Zvonko2203/Map-from-transfer-folder/SanaBike Measuring head/BoM_Messkopf.xlsx

Sheet: 20-30-602_SB3-1_2025_NiBP
20-30-602_SB3-1_2025_NiBP&SPO2 |  |  |  | 206-00-0-110 | Measuring Head with NiBP & SpO2
Qty | Unit | Ergosana article number | Description | New article number | Description
1 | Stück | 27-30-400 | Lagergehäuse für Messkopf - new version for rotation mechanisam | 206-10-5-001 | Bearing Rotation Mechanism
1 | Stück | 27-30-504 | Filterscheibe, Drehzahlanzeige, Meßkopf | 206-10-5-002 | Speed Indicator Housing
2 | Stück | 31-30-001 | Ersatzsteg für Platine ohne BD | 206-10-5-003 | Carrier for Main Unit PCB
1 | Stück | 35-30-001 | Auflageplatte, Display | 206-10-5-004 | Display plate | 206-10-1-001 | Downside Housing for Standard
1 | Stück | 35-30-400 | 35-30-400_ZI04 Unterteil, Gehäuse Messkopf Typ3_Stand2022-06-15 - BD+SpO2 | 206-10-1-002 | Downside Housing for NiBP/SpO2 | 206-10-1-002 | Downside Housing for NiBP/SpO2
1 | Stück | 35-30-401 | 35-30-401_ZI03 Oberteil, Gehäuse Messkopf Typ3-x_Displayausschnitt 2,8Zoll | 206-10-5-005 | Upside Housing | 206-10-1-003 | Downside Housing for NiBP
1 | Stück | 37-30-501 (https://qms.schiller.ch/display/SANABEM/Ergometer+Schematic+Part+List+37-30-501+Platine+Ergometersteuerung) | Platine Ergometersteuerung SB3 3.1 Version 30_04_012 | 206-30-1-100 | Main Unit PCB | 206-10-1-004 | Downside Housing for SpO2
1 | Stück | 37-30-503 (https://qms.schiller.ch/display/SANABEM/Ergometer+Schematic+Part+List+37-30-503+Platine+Drehzahlanzeige) | Platine Drehzahlanzeige kpl. SB3 | 206-30-1-200 | LED Display PCB
1 | Stück | N/A | Kabel SpO2 6 pol - from PAR | 211-40-1-100 | SpO2 cable from PAR
1 | Stück | 39-30-800 | Frontfolie Meßkopf SB3 | 206-10-5-006 | Front foil of head
9 | Stück | 40-08-006 | Linsenschraube, Kreuzschlitz DIN7985 4.8 verz. M3x4 | 210-10-5-101 | Pan Head Screw DIN7985 M3x4
4 | Stück | 40-10-001 | Senkschraube, Kreuzschlitz DIN965 4.8 verz. M4x10 | 210-10-5-102 | Flat Head Screw DIN965 M4x10
2 | Stück | 40-10-002 | Senkschraube, Kreuzschlitz DIN 965 4.8 verz. M3x6 | 210-10-5-103 | Flat Head Screw DIN965 M3x6
4 | Stück | 40-18-015 | Linsen-Blechschraube, Kreuzschlitz C DIN 7981 verz. 3,9x25 | 210-10-5-104 | Tapping screw DIN9781 3,9x25
7 | Stück | 41-01-006 | Mutter, Sechskant DIN934 8 verz. M3 | 210-10-5-201 | Hexagon Nut DIN934 M3
3 | Stück | 41-02-018 | Abstandsbolzen M3x15 (IG/AG) Stahl verz. | 210-10-5-701 | Spacer Bolts M3x15 Female/Male
2 | Stück | 42-01-001 | Scheibe, A DIN125 Stahl 140HV verz. 3,2 (M3) | 210-10-5-301 | Flat Washer DIN125A 140HV M3
1 | Stück | 42-02-001 | Scheibe, Kunststoff, A DIN125 Polyamid 6.6 3,2 (M3) | 210-10-5-302 | Flat Washer DIN125 Polyamide M3 | Ide na kriticno mjesto oko komponenti kod NiBP jedne na steuerplatine
1 | Stück | 59-01-147 | Federndruckstück GN 614.4-5-NI | 210-10-5-501 | Ganter GN 614.4-5-NI
4 | Stück | 59-01-148 | Gewindeeinsatz M3 | 210-10-5-001 | Thread insert brass M3
1 | Stück | 69-01-008 | Jumper (Brücke) 2-Pin 2,54mm SIP-2P | 211-20-5-101 | Jumper 2Pin 2,54mm SIP-2P
1 | Stück | 69-01-103 | Display TFT, Messkopf easy, SB3 | 211-20-5-102 | TFT Display
2 | Stück | N/A | Abstandsbolzen M3x10 (IG/AG) Stahl vern (gbms_3055_33_10) | 210-10-5-702 | Spacer Bolts M3x10 Female/Male
4 | Stück | N/A | Abstandsbolzen M3x30 (IG/AG) Stahl verz. (gbm_3050_30) | 210-10-5-703 | Spacer Bolts M3x30 Female/Male
1 | Stück | N/A | Label Ergosana | 230-10-5-001 | Label Ergosana
1 | Stück | 26-37-501_ZI00 | Anschlußstück Luftdruck, BD-Messung | 210-50-5-001 | Connector for air pressure
1 | Stück | 26-37-502_ZI00 | Mutter M7x0,75, Anschlussstück BD-Messung | 210-10-5-202 | Hexagon Nut M7x0,75 for air pressure connector
1 | Stück | N/A | Steckanschluss, Mikrophon - 4pin | 211-20-5-301 | 4pin Microphone connector 09-9766-30-04
1 | Stück | N/A | NiBP2020B | 211-20-1-100 | NiBP2020B module
1 | Stück | 38-30-320 | Kabel Drehzahlanzeige 6 pol 120 mm | 211-40-1-200 | LED Display Cable 6pin 120mm
1 | Stück | 35-30-xxx | Plain Bearing socket | 210-10-5-601 | Plain Bearing socket
1 | Stück | N/A | QRS cable | 210-10-5-602 | QRS Cable 2pin 220mm
1 | Stück | N/A | Microphone cable | 210-10-5-603 | Microphone Cable 3pin 220mm

Sheet: 20-30-600_SB3-1_2025
20-30-600_SB3-1_2025 |  |  |  | 206-00-0-000 | Measuring Head standard
Qty | Unit | Ergosana article number | Description | New article number | Description
1 | Stück | 27-30-400 | Lager, Gehäuse, Messkopf - new version for rotation mechanisam | 206-10-5-001 | Bearing Rotation Mechanism
1 | Stück | 27-30-504 | Filterscheibe, Drehzahlanzeige, Meßkopf | 206-10-5-002 | Speed Indicator Housing
2 | Stück | 31-30-001 | Ersatzsteg für Platine ohne BD | 206-10-5-003 | Carrier for Main Unit PCB
1 | Stück | 35-30-xxx | Plain Bearing socket | 210-10-5-601 | Plain Bearing socket
1 | Stück | 35-30-001 | Auflageplatte, Display | 206-10-5-004 | Display plate
1 | Stück | 35-30-400 | Gehäuse Messkopf Unterteil SB3 | 206-10-1-001 | Downside Housing for Standard
1 | Stück | 35-30-401 | Gehäuse Messkopf Oberteil SB3 | 206-10-5-005 | Upside Housing
1 | Stück | 37-30-501 (https://qms.schiller.ch/display/SANABEM/Ergometer+Schematic+Part+List+37-30-501+Platine+Ergometersteuerung) | Platine Ergometersteuerung SB3 3.1 Version 30_04_012 | 206-30-1-100 | Main Unit PCB
1 | Stück | 37-30-503 (https://qms.schiller.ch/display/SANABEM/Ergometer+Schematic+Part+List+37-30-503+Platine+Drehzahlanzeige) | Platine Drehzahlanzeige kpl. SB3 | 206-30-1-200 | LED Display PCB
1 | Stück | 38-30-320 | Kabel Drehzahlanzeige 6 pol 120 mm | 211-40-1-200 | LED Display Cable 6pin 120mm
1 | Stück | 39-30-800 | Frontfolie Meßkopf SB3 | 206-10-5-006 | Front foil of head
6 | Stück | 40-08-006 | Linsenschraube, Kreuzschlitz DIN7985 4.8 verz. M3x4 | 210-10-5-101 | Pan Head Screw DIN7985 M3x4
4 | Stück | 40-10-001 | Senkschraube, Kreuzschlitz DIN965 4.8 verz. M4x10 | 210-10-5-102 | Flat Head Screw DIN965 M4x10
2 | Stück | 40-10-002 | Senkschraube, Kreuzschlitz DIN 965 4.8 verz. M3x6 | 210-10-5-103 | Flat Head Screw DIN965 M3x6
4 | Stück | 40-18-015 | Linsen-Blechschraube, Kreuzschlitz C DIN 7981 verz. 3,9x25 | 210-10-5-104 | Tapping screw DIN9781 3,9x25
4 | Stück | 41-01-006 | Mutter, Sechskant DIN934 8 verz. M3 | 210-10-5-201 | Hexagon Nut DIN934 M3
4 | Stück | N/A | Abstandsbolzen M3x10 (IG/AG) Stahl vern (gbms_3055_33_10) | 210-10-5-702 | Spacer Bolts M3x10 Female/Male
2 | Stück | N/A | Abstandsbolzen M3x30 (IG/AG) Stahl verz. (gbm_3050_30) | 210-10-5-703 | Spacer Bolts M3x30 Female/Male
2 | Stück | 42-01-001 | Scheibe, A DIN125 Stahl 140HV verz. 3,2 (M3) | 210-10-5-301 | Flat Washer DIN125A 140HV M3
1 | Stück | 42-02-001 | Scheibe, Kunststoff, A DIN125 Polyamid 6.6 3,2 (M3) | 210-10-5-302 | Flat Washer DIN125 Polyamide M3
1 | Stück | 59-01-147 | Federndruckstück GN 614.4-5-NI | 210-10-5-501 | Ganter GN 614.4-5-NI
4 | Stück | 59-01-148 | Gewindeeinsatz M3 | 210-10-5-001 | Thread insert brass M3
1 | Stück | 69-01-008 | Jumper (Brücke) 2-Pin 2,54mm SIP-2P | 211-20-5-101 | Jumper 2Pin 2,54mm SIP-2P
1 | Stück | 69-01-103 | Display TFT, Messkopf easy, SB3 | 211-20-5-102 | TFT Display
1 | Stück | N/A | Label Ergosana | 230-10-5-001 | Label Ergosana
