Zvonko2203/Map-from-transfer-folder/SanaBike Measuring head/BoM_Messkopf_comparation.xlsx

Sheet: 20-30-602_SB3-1_2025_NiBP
Added parts to BoM
Removed Parts from BoM
Parts matched from BoM QMS
Changed number of parts to BoM
20-30-602_SB3-1_2025_NiBP&SPO2
Qty | Unit | Ergosana article number | Description
1 | Stück | 27-30-400 | Lagergehäuse für Messkopf - for rotation mechanisam
1 | Stück | 27-30-504 | Filterscheibe, Drehzahlanzeige, Meßkopf
2 | Stück | 31-30-001 | Ersatzsteg für Platine ohne BD
1 | Stück | 35-30-001 | Auflageplatte, Display
1 | Stück | 35-30-400 | 35-30-400_ZI04 Unterteil, Gehäuse Messkopf Typ3_Stand2022-06-15 - BD+SpO2
1 | Stück | 35-30-401 | 35-30-401_ZI03 Oberteil, Gehäuse Messkopf Typ3-x_Displayausschnitt 2,8Zoll
1 | Stück | 37-30-501 (https://qms.schiller.ch/display/SANABEM/Ergometer+Schematic+Part+List+37-30-501+Platine+Ergometersteuerung) | Platine Ergometersteuerung SB3 3.1 Version 30_04_012
1 | Stück | 37-30-503 (https://qms.schiller.ch/display/SANABEM/Ergometer+Schematic+Part+List+37-30-503+Platine+Drehzahlanzeige) | Platine Drehzahlanzeige kpl. SB3
1 | Stück | N/A | Kabel Drehzahlanzeige 6 pol - from PAR
1 | Stück | 39-30-800 | Frontfolie Meßkopf SB3
9 (6-old) | Stück | 40-08-006 | Linsenschraube, Kreuzschlitz DIN7985 4.8 verz. M3x4
4 | Stück | 40-10-001 | Senkschraube, Kreuzschlitz DIN965 4.8 verz. M4x10
2 | Stück | 40-10-002 | Senkschraube, Kreuzschlitz DIN 965 4.8 verz. M3x6
4 | Stück | 40-18-015 | Linsen-Blechschraube, Kreuzschlitz C DIN 7981 verz. 3,9x25
7 (6 - old) | Stück | 41-01-006 | Mutter, Sechskant DIN934 8 verz. M3
4 | Stück | 41-02-006 | Abstandsbolzen M3x25 (IG/AG) Stahl vern
3 (4-old) | Stück | 41-02-018 | Abstandsbolzen M3x15 (IG/AG) Stahl verz.
2 | Stück | 42-01-001 | Scheibe, A DIN125 Stahl 140HV verz. 3,2 (M3)
1 | Stück | 42-02-001 | Scheibe, Kunststoff, A DIN125 Polyamid 6.6 3,2 (M3)
1 | Stück | 59-01-147 | Federndruckstück GN 614.4-5-NI
4 | Stück | 59-01-148 | Gewindeeinsatz M3
1 | Stück | 69-01-008 | Jumper (Brücke) 2-Pin 2,54mm SIP-2P
1 | Stück | 69-01-103 | Display TFT, Messkopf easy, SB3
2 | Stück | N/A | Abstandsbolzen M3x10 (IG/AG) Stahl vern (gbms_3055_33_10)
4 | Stück | N/A | Abstandsbolzen M3x30 (IG/AG) Stahl verz. (gbm_3050_30)
2 | Stück | 26-30-800 | Anschlußstück BD-Druckausgleich
1 | Stück | 38-01-043 | PVC-Schlauch 8x2mm glasklar
1 | Stück | N/A | Label Ergosana
1 | Stück | 26-37-501_ZI00 | Anschlußstück Luftdruck, BD-Messung
1 | Stück | 26-37-502_ZI00 | Mutter M7x0,75, Anschlussstück BD-Messung
1 | Stück | N/A | Steckanschluss, Mikrophon - 4pin
1 | Stück | 69-01-075 | Mutter, Mikrofonstecker
1 | Stück | 69-30-010 | SpO2-Stecker-bluepoint
1 | Stück | N/A | NiBP2020B
1 | Stück | 38-30-320 | Kabel Drehzahlanzeige 6 pol 120 mm
1 | Stück | 35-30-xxx | Plain Bearing socket

Sheet: 20-30-600_SB3-1_2025
Added parts to BoM
Removed Parts from BoM
Parts matched from BoM QMS
Changed number of parts to BoM
20-30-602_SB3-1_2025_NiBP&SPO2
Qty | Unit | Ergosana article number | Description
1 | Stück | 27-30-504 | Filterscheibe, Drehzahlanzeige, Meßkopf
2 | Stück | 31-30-001 | Ersatzsteg für Platine ohne BD
1 | Stück | 35-30-001 | Auflageplatte, Display
1 | Stück | 35-30-400 | Gehäuse Messkopf Unterteil SB3
1 | Stück | 35-30-401 | Gehäuse Messkopf Oberteil SB3
1 | Stück | 37-30-501 (https://qms.schiller.ch/display/SANABEM/Ergometer+Schematic+Part+List+37-30-501+Platine+Ergometersteuerung) | Platine Ergometersteuerung SB3 3.1 Version 30_04_012
1 | Stück | 37-30-503 (https://qms.schiller.ch/display/SANABEM/Ergometer+Schematic+Part+List+37-30-503+Platine+Drehzahlanzeige) | Platine Drehzahlanzeige kpl. SB3
1 | Stück | 38-30-320 | Kabel Drehzahlanzeige 6 pol 120 mm
1 | Stück | 39-30-800 | Frontfolie Meßkopf SB3
6 | Stück | 40-08-006 | Linsenschraube, Kreuzschlitz DIN7985 4.8 verz. M3x4
4 | Stück | 40-10-001 | Senkschraube, Kreuzschlitz DIN965 4.8 verz. M4x10
2 | Stück | 40-10-002 | Senkschraube, Kreuzschlitz DIN 965 4.8 verz. M3x6
4 | Stück | 40-18-015 | Linsen-Blechschraube, Kreuzschlitz C DIN 7981 verz. 3,9x25
4 (6-old) | Stück | 41-01-006 | Mutter, Sechskant DIN934 8 verz. M3
4 | Stück | 41-02-006 | Abstandsbolzen M3x25 (IG/AG) Stahl vern
2 (4-old) | Stück | 41-02-018 | Abstandsbolzen M3x15 (IG/AG) Stahl verz.
2 | Stück | 42-01-001 | Scheibe, A DIN125 Stahl 140HV verz. 3,2 (M3)
1 | Stück | 42-02-001 | Scheibe, Kunststoff, A DIN125 Polyamid 6.6 3,2 (M3) | check - extra on model for display
1 | Stück | 59-01-147 | Federndruckstück GN 614.4-5-NI
4 | Stück | 59-01-148 | Gewindeeinsatz M3
1 | Stück | 69-01-008 | Jumper (Brücke) 2-Pin 2,54mm SIP-2P
1 | Stück | 69-01-103 | Display TFT, Messkopf easy, SB3
1 | Stück | 27-30-400 | Lager, Gehäuse, Messkopf - new version for rotation mechanisam
1 | Stück | N/A | Label Ergosana
1 | Stück | 35-30-xxx | Plain Bearing socket
