Zvonko2203/Map-from-transfer-folder/SanaBike New PS/RACM/BoM/BoM_SB1000.xlsx

Added parts
Removed Parts
Modified part
Not on model |  |  |  | 17
SanaBike 1000
Qty | Unit | Ergosana article number | Description
1 | Stück | 20-30-201 (https://qms.schiller.ch/pages/viewpage.action?pageId=156026939) | Antriebseinheit, Baureihe SB3.1 ab 03/22
1 | Stück | 20-30-602 (https://qms.schiller.ch/display/SANABEM/Ergometer+BoM+20-30-602+Messkopf%2C+SB+3.1) | Meßkopf
1 | Stück | 35-10-807 | Faltenbalg Sattel, basaltgrau (RAL7012) SB2+SB3
1 | Stück | 35-10-806 | Faltenbalg Lenker, basaltgrau (RAL7012) SB2+SB3
1 | Stück | 21-10-806 | Lenker Fahrradergometer SB2+SB3
1 | Stück | 35-30-813 | Fußabdeckung vorne SanaBike 1000 SB3
1 | Stück | 35-30-811 | Verschalung Seitenteile Ergometer SB3
1 | Stück | 37-30-300 (https://qms.schiller.ch/pages/viewpage.action?pageId=156030211) | Platine Netzteil
1 | Stück | 20-30-100 | Liefersatz Gestell SanaBike 1000 (Fahrradergometer SB3) | 28-30-101-A1-ZI06 (Hole for input cable moved, position for trafo removed, add new 4 holes for SMPS, new hole for fixing RS232, changed position for PE)
 |  |  |  | 28-30-101-A4_ZI00 & 28-30-101-A5_ZI00 removed
1 | Stück | 21-30-801 | Lenkerstange SanaBike 1000 SB3
1 | Stück | 25-30-101 | Lenkerklemmung Messkopf Typ3
1 | Stück | 25-30-100 | Lenkerverkleidung Messkopf Typ3
1 | Stück | 26-10-210 | Federlager | ??
1 | Stück | 27-10-808 | Druckplatte Lenkerrohrklemmung
1 | Stück | 27-10-803 | Gewindeplatte Sattelklemmung
2 | Stück | 28-30-001 | Haltewinkel, Verschalung SanaBike 1000
1 | Stück | 28-10-802 | Druckplatte Sattelklemmung
2 | Stück | 31-10-805 | Platte, Verschalung
1 | Stück | 31-10-301 | Schnittstellenblech, RS232
1 | Stück | 31-10-803 | Halter Faltenbalg Sattel, SB2+3
1 | Stück | 31-10-804 | Halter Faltenbalg Lenker SB2+3
1 | Stück | 31-30-100 | Abdeckung Netzteilplatine, SanaBike 1000, SB3
0.32 | Mtr. | 35-10-860 | Bms30 Streifen 40mm (mit Selbstklebeband)
2 | Stück | 35-30-831 | Isolationsfolie Abdeckung Netzteilplatine
1 | Stück | 35-30-832 | Isolationsfolie Netzteilplatine 0,43mm Materialstärke
1 | Stück | 37-10-201 (https://qms.schiller.ch/display/SANABEM/Ergometer+BoM+37-10-201+Platine+DMS) | Platine DMS kpl. | part of Drive unit
1 | Stück | 37-10-302 (https://qms.schiller.ch/display/SANABEM/Ergometer+BoM+37-30-302+Platine+RS232) | Platine Schnittstelle RS232 | modified version
 | Stück | 38-10-307 | Kabel, Erdleitung NT-Platine (zentr. Schutzleiter) 200mm | PE cable from power PCB
1 | Stück | 38-10-305 | Kabel, Kombimodul-Netzteilplatine, 500mm | new cable from input to SMPS
1 | Stück | 38-30-301 | Kabel, Steuerplatine-Netzteil 1900mm, 26-polig
1 | Stück | 38-10-302 | Kabel, DMS-Platine-Netzteil, 480mm
1 | Stück | 38-10-313 | Kabel, RS232-Schnittstelle-NT, 10-polig, 240mm
1 | Stück | 38-10-318 | Kabel, Erdleitung-Kombimodul (zentr. Schutzl) 430mm, SB2+SB3 | cable grom input to old power pcb
0.1 | Mtr. | 38-01-041 | Spiralschlauch Polyethylen 10-40mm
1 | Stück | 39-10-201 | Zugseil DMS (Öse/Öse) | part of Drive unit
1 | Stück | 39-10-202 | Federseil DMS | part of Drive unit
1 | Stück | 40-01-001 | Zylinderschraube, Innensechskant DIN912 8.8 verz. M3x12
1 | Stück | 40-01-002 | Zylinderschraube, Innensechskant DIN912 8.8 M8x25
1 | Stück | 40-01-007 | Zylinderschraube, Innensechskant DIN912 8.8 verz. M4x14
1 | Stück | 40-01-030 | Zylinderschraube, Innensechskant DIN912 8.8 verz. M8x12
2 | Stück | 40-11-005 | Linsensenkschraube, Kreuzschlitz DIN966 4.8 verz. M3x8
4 | Stück | 40-01-004 | Zylinderschraube, Innensechskant DIN912 8.8 verz. M8x18
1 | Stück | 40-13-013 | Gewindestift, Innensechskant DIN913 45H sw. M6x12
2 | Stück | 40-03-015 | Sechskantbolzen, SUB-D-Stecker verz. M3x13,2 (4-40UNC)
1 | Stück | 40-08-001 | Linsenschraube, Kreuzschlitz DIN7985 4.8 verz. M5x6
1 | Stück | 40-10-001 | Senkschraube, Kreuzschlitz DIN965 4.8 verz. M4x10
2 | Stück | 40-18-010 | Linsen-Blechschraube, Kreuzschlitz DIN7981 verz. 4,2x50
6 | Stück | 40-18-003 | Linsen-Blechschraube, Kreuzschlitz DIN7981 verz. 4,2x19
4 | Stück | 40-18-001 | Linsen-Blechschraube, Kreuzschlitz DIN7981 verz. 3,9x9,5
1 | Stück | 40-15-002 | Ringschraube 4.8 verz. M4x10
1 | Stück | 40-15-004 | Ringschraube 4.8 verz. M4x30
7 | Stück | 40-08-007 | Linsenschraube, Kreuzschlitz DIN7985 4.8 verz. M4x6
3 | Stück | 40-08-015 | EcoFix-Schraube BN4825 verz. M4x8
2 | Stück | 40-01-026 | Zylinderschraube, Innensechskant DIN7984 08.8 verz. M6x12
9 (5-old) | Stück | 41-01-006 | Mutter, Sechskant DIN934 8 verz. M3
2(3-old) | Stück | 41-01- 003 | Mutter, Sechskant DIN934 8 verz. M8 | ?? On model is one
1 | Stück | 41-01-002 | Mutter, Sechskant DIN934 8 verz. M6
2 | Stück | 41-01-001 | Mutter, Sechskant DIN934 8 verz. M4
1 | Stück | 41-02-001 | Abstandsbolzen M4x20 (IG/IG) Ms vern
2 | Stück | 42-01-001 | Scheibe, A DIN125 Stahl 140HV verz. 3,2 (M3) | on model different definition
1 | Stück | 42-04-001 | Zahnscheibe, Innenverz. DIN6797 Federstahl verz. 3,2 (M3)
1 | Stück | 42-04-002 | Zahnscheibe, Innenverz. DIN6797 Federstahl verz. 8,4 (M8)
1 (2-old) | Stück | 42-04-003 | Zahnscheibe, Innenverz. DIN6797 Federstahl verz. 4,3 (M4)
1 | Stück | 42-01-006 | Scheibe, B DIN125 Stahl 140HV verz. 6,4 (M6)
5 | Stück | 42-01-002 | Scheibe, A DIN125 Stahl 140HV verz. 8,4 (M8)
2 | Stück | 42-01-014 | Kotflügelscheibe Stahl 100HV verz. 4,3x20x1,5
2 | Stück | 42-01-007 | Scheibe, A DIN9021 Stahl 100HV verz. 10,5 (M10)
2 | Stück | 42-05-001 | Federscheibe (ohne Kappe) verz. Ø12
2 | Stück | 42-04-004 | Fächerscheibe, Außenverz. DIN6798 Federstahl verz. 6,4 (M6)
1 | Stück | 42-01-003 | Scheibe, A DIN125 Stahl HV140 verz. 4,3 (M4)
2 | Stück | 42-03-007 | Passscheibe, Stahl DIN988 40x50x1,2
1 | Stück | 46-01-007 | Druckfeder VD 161
2 | Stück | 49-01-006 | Sicherungsscheibe DIN6799 Ø9x1
3 | Stück | 59-01-021 | Klebesockel 27x27 natur
3 | Stück | 59-01-037 | Kabelbinder 100x2,5mm natur
0.03 | Mtr. | 59-01-089 | Zellgummiband (Flüssigkeitssperre)
1 | Stück | 59-01-027 | Sattel für SanaBike (Ergometersattel)
2 | Stück | 59-01-005 | Justierteller, antirutsch HVF 48 M10x30
1 | Stück | 59-01-004 | Klemmhebel schwarz M10x30 (Lenkerverstellung 360°)
4 | Stück | 59-01-035 | Distanzstück 4,3x8x5
1 | Stück | 59-01-171 | Kabeltülle PVC schwarz 25 x 31,7mm
2 | Stück | 59-01-006-01 | Abdeckung, Radkappe Rad Polypropylen
1 | Stück | 59-01-056 | Warnschild, Potentialausgleich
1 | Stück | 59-01-011 | Pedal (Paar) long straps 9/16", schwarz, ergosana
2 | Stück | 59-01-010 | Combischraube+Ansatzscheibe VKT DIN933 sw. 14 M8x1x18
1 | Stück | 59-01-009 | Tretkurbel AVAX rechts 170mm FG -Rechtsgewinde- sw
1 | Stück | 59-01-008 | Tretkurbel AVAX-S links 170mm FG -Linksgewinde- sw
2 | Stück | 59-01-006 | Rad, Polypropylen PP80/12G
2 | Stück | 59-01-003 | Klemmhebel schwarz M10x20 Lenker- +Sitzhöhenverst.
2 | Stück | 59-01-117 | Spreizmutter 12,7x0,8
1 | Stück | 59-01-164 | Sattelkloben 5- Komp. ab Sep. 21
1 | Stück | 59-01-062 | Piktogramm "Bedienungsanleitung beachten"
1 | Stück | 66-10-302 | Ringkerntransformator SB2+SB3
1 | Stück | 69-01-015 | Stecker, Potentialausgleich
1 | Stück | 69-01-050 | Farbring, Potentialausgleichsanschluss
1 | Stück | 69-01-119 (https://qms.schiller.ch/pages/viewpage.action?pageId=231286925) | Brücke kpl. für 230V Netzspannung
1 | Stück | 69-01-121 (https://qms.schiller.ch/pages/viewpage.action?pageId=238960409) | Kombi Einbaustecker mit Schalter kpl. SanaBike
1 | Stück | 69-01-123 (https://qms.schiller.ch/pages/viewpage.action?pageId=238960487) | Biegeelement kpl. SB3
1 | Stück | N/A | new PS - RACM230
1 | Stück | N/A | new Power PCB
4 | Stück | N/A | spring washer M3 DIN 127
4 | Stück | N/A | DIN 916 M3x16
4 | Stück | N/A | BN 6 1010565 flat washer M3
4 | Stück | N/A | DIN985 M3 nut with gume
1 | Stück | N/A | Isolationfolie for SMPS (new isolationfolie above SMPS)
1 | Stück | 41-01-003 | Mutter, Sechskant DIN934 8 verz. M8 | not in BoM?
1 | Stück | N/A | Cable from SMPS to Power PCB
1 | Stück | 42-01-001 | Sechskantmutter M4 - DIN 934 | not in BoM?
