Zvonko2203/Map-from-transfer-folder/SanaBike New PS/RACM/BoM/BoM_SB500.xlsx

Added parts
Removed Parts
Modified part
11-20-500 SanaBike 500
Qty | Unit | Ergosana article number | Description
1 | Stück | 20-31-100 | Grundgestell kpl. | 21-31-101-A1_ZI03 (old holes removed, added new holes for SMPS)
1 | Stück | 20-30-201 (https://qms.schiller.ch/pages/viewpage.action?pageId=156026939) | Antriebseinheit, Baureihe ab 03/22
1 | Stück | 20-30-602 (https://qms.schiller.ch/display/SANABEM/Ergometer+BoM+20-30-602+Messkopf%2C+SB+3.1) | Meßkopf
1 | Stück | 21-10-806 | Lenker Fahrradergometer SB2+SB3
1 | Stück | 25-30-101 | Lenkerklemmung Messkopf Typ3
1 | Stück | 25-30-100 | Lenkerverkleidung Messkopf Typ3
1 | Stück | 26-10-210 | Federlager
1 | Stück | 27-10-803 | Gewindeplatte Sattelklemmung
1 | Stück | 28-11-102 | Abdeckblech, Ringkerntrafo | modified with new holes for new PS
1 | Stück | 28-11-103 | Abdeckblech, Netzteilplatine
2 | Stück | 28-11-105 | Haltewinkel, Verkleidung
1 | Stück | 28-10-802 | Druckplatte Sattelklemmung
2 | Stück | 28-11-301 | Halteblech NT-Platine
2 | Stück | 31-10-805 | Platte, Verschalung
1 | Stück | 31-10-803 | Halter Faltenbalg Sattel, SB2+3
1 | Stück | 35-11-817 | Montagesteg, Verschalung
0.08 | Mtr. | 35-10-860 | Bms30 Streifen 40mm (mit Selbstklebeband)
1 | Stück | 35-10-807 | Faltenbalg Sattel, basaltgrau (RAL7012) SB2+SB3
1 | Satz | 35-31-811 | Verschalung Seitenschale links/rechts Rohrergom. sb3 (Satz)
1 | Stück | 37-10-201 (https://qms.schiller.ch/display/SANABEM/Ergometer+BoM+37-10-201+Platine+DMS) | Platine DMS kpl.
1 | Stück | 37-10-302 (https://qms.schiller.ch/display/SANABEM/Ergometer+Schematic+Part+List+37-30-302+Platine+RS232) | Platine Schnittstelle RS232 | modified version
1 | Stück | 37-30-300 (https://qms.schiller.ch/display/SANABEM/Ergometer+Schematic+Part+List+37-30-300+Platine+Netzteil) | Platine Netzteil | new PS from Schiller AG
1 | Stück | 38-11-303 | Kabel, Schnittstelle-Netzteil, 10-polig, 600mm
1 | Stück | 38-10-307 | Kabel, Erdleitung NT-Platine (zentr. Schutzleiter) 200mm | cable from power PCB to PE
1 | Stück | 38-10-308 | Kabel, Erdleitung Kombimodul (zentr. Schutzleiter) 750mm
1 | Stück | 38-31-301 | Kabel Steuerplatine-Netzteil 26-pol. 1780mm
1 | Stück | 38-11-305 | Kabel, Kombimodul-NT-Platine (Rohrergometer) 650mm | cable with new connector for new PS
1 | Stück | 38-10-302 | Kabel, DMS-Platine-Netzteil, 480mm
1 | Stück | 38-12-311 | Kabel Erdleitung f. Pot-Ausgleichst.-zentr.Erdleiter 500mm
0.1 | Mtr. | 38-01-041 | Spiralschlauch Polyethylen 10-40mm
1 | Stück | 39-10-201 | Zugseil DMS (Öse/Öse)
1 | Stück | 39-10-202 | Federseil DMS
4 | Stück | 40-01-004 | Zylinderschraube, Innensechskant DIN912 8.8 verz. M8x18
4 | Stück | 40-08-003 | Linsenschraube, Kreuzschlitz DIN7985 4.8 verz. M4x10
1 | Stück | 40-15-004 | Ringschraube 4.8 verz. M4x30
2 | Stück | 40-18-005 | Linsensenk-Blechschraube, Kreuzschl. C DIN7983 verz. 2,9x13
6 | Stück | 40-18-001 | Linsen-Blechschraube, Kreuzschlitz DIN7981 verz. 3,9x9,5
4 | Stück | 40-01-001 | Zylinderschraube, Innensechskant DIN912 8.8 verz. M3x12
2 | Stück | 40-18-003 | Linsen-Blechschraube, Kreuzschlitz DIN7981 verz. 4,2x19
4 | Stück | 40-11-005 | Linsensenkschraube, Kreuzschlitz DIN966 4.8 verz. M3x8
2 | Stück | 40-03-007 | Sechskantbolzen, SUB-D-Stecker verz. M3x18,2 (4-40UNC)
1 | Stück | 40-01-003 | Zylinderschraube, Innensechskant DIN912 8.8 verz. M8x40
1 | Stück | 40-01-002 | Zylinderschraube, Innensechskant DIN912 8.8 M8x25
1 | Stück | 40-01-007 | Zylinderschraube, Innensechskant DIN912 8.8 verz. M4x14
4 | Stück | 40-08-007 | Linsenschraube, Kreuzschlitz DIN7985 4.8 verz. M4x6
3 | Stück | 40-08-015 | EcoFix-Schraube BN4825 verz. M4x8
2 | Stück | 40-01-026 | Zylinderschraube, Innensechskant DIN7984 08.8 verz. M6x12
2 | Stück | 40-03-012 | Sechskantschraube DIN933 8.8 verz. M10x60
6 (2-old) | Stück | 41-01-006 | Mutter, Sechskant DIN934 8 verz. M3
1 | Stück | 41-01-002 | Mutter, Sechskant DIN934 8 verz. M6
1 | Stück | 41-02-001 | Abstandsbolzen M4x20 (IG/IG) Ms vern
2 | Stück | 42-04-004 | Fächerscheibe, Außenverz. DIN6798 Federstahl verz. 6,4 (M6)
1 | Stück | 42-04-002 | Zahnscheibe, Innenverz. DIN6797 Federstahl verz. 8,4 (M8)
2 | Stück | 42-01-003 | Scheibe, A DIN125 Stahl HV140 verz. 4,3 (M4)
1 | Stück | 42-01-006 | Scheibe, B DIN125 Stahl 140HV verz. 6,4 (M6)
4 (5-old) | Stück | 42-01-002 | Scheibe, A DIN125 Stahl 140HV verz. 8,4 (M8)
1 | Stück | 42-04-001 | Zahnscheibe, Innenverz. DIN6797 Federstahl verz. 3,2 (M3)
2 | Stück | 42-04-003 | Zahnscheibe, Innenverz. DIN6797 Federstahl verz. 4,3 (M4)
2 | Stück | 42-01-007 | Scheibe, A DIN9021 Stahl 100HV verz. 10,5 (M10)
2 | Stück | 42-05-001 | Federscheibe (ohne Kappe) verz. Ø12
2 | Stück | 42-03-007 | Passscheibe, Stahl DIN988 40x50x1,2
4 | Stück | 43-01-002 | Abstandshülse Polystyrol sw 7x3,6x3
1 | Stück | 46-01-007 | Druckfeder VD 161
4 | Stück | 59-01-021 | Klebesockel 27x27 natur
6 | Stück | 59-01-037 | Kabelbinder 100x2,5mm natur
2 | Stück | 59-01-005 | Justierteller, antirutsch HVF 48 M10x30
1 | Stück | 59-01-004 | Klemmhebel schwarz M10x30 (Lenkerverstellung 360°)
1 | Stück | 59-01-003 | Klemmhebel schwarz M10x20 Lenker- +Sitzhöhenverst.
4 | Stück | 59-01-035 | Distanzstück 4,3x8x5
2 | Stück | 59-01-006-01 | Abdeckung, Radkappe Rad Polypropylen
1 | Stück | 59-01-056 | Warnschild, Potentialausgleich
1 | Stück | 59-01-011 | Pedal (Paar) long straps 9/16", schwarz, ergosana
2 | Stück | 59-01-010 | Combischraube+Ansatzscheibe VKT DIN933 sw. 14 M8x1x18
1 | Stück | 59-01-009 | Tretkurbel AVAX rechts 170mm FG -Rechtsgewinde- sw
1 | Stück | 59-01-008 | Tretkurbel AVAX-S links 170mm FG -Linksgewinde- sw
2 | Stück | 59-01-074 | Gleiter 40x40x1,5-2,0mm
2 | Stück | 59-01-006 | Rad, Polypropylen PP80/12G
0.03 | Mtr. | 59-01-089 | Zellgummiband (Flüssigkeitssperre)
1 | Stück | 59-01-164 | Sattelkloben 5- Komp. ab Sep. 21
1 | Stück | 59-01-062 | Piktogramm "Bedienungsanleitung beachten"
1 | Stück | 66-10-302 | Ringkerntransformator SB2+SB3
1 | Stück | 69-01-015 | Stecker, Potentialausgleich
1 | Stück | 69-01-050 | Farbring, Potentialausgleichsanschluss
1 | Stück | 69-01-119 (https://qms.schiller.ch/pages/viewpage.action?pageId=231286925) | Brücke kpl. für 230V Netzspannung
1 | Stück | 69-01-121 (https://qms.schiller.ch/pages/viewpage.action?pageId=238960409) | Kombi Einbaustecker mit Schalter kpl. SanaBike
1 | Stück | 69-01-123 (https://qms.schiller.ch/pages/viewpage.action?pageId=238960487) | Biegeelement kpl. SB3
4 | Stück | N/A | spring washer M3 DIN 127
4 | Stück | N/A | DIN 916 M3x16
4 | Stück | N/A | BN 6 1010565 flat washer M3
4 | Stück | N/A | DIN985 M3 nut with rubber
1 | Stück | N/A | Power PCB Schiller AG
1 | Stück | N/A | Cable from SMPS to power PCB
