Zvonko2203/Map-from-transfer-folder/Rotation Mechanism/Passscheibe 40x50x1,2 - DIN 988 (ArtNr. 42-03-007).step

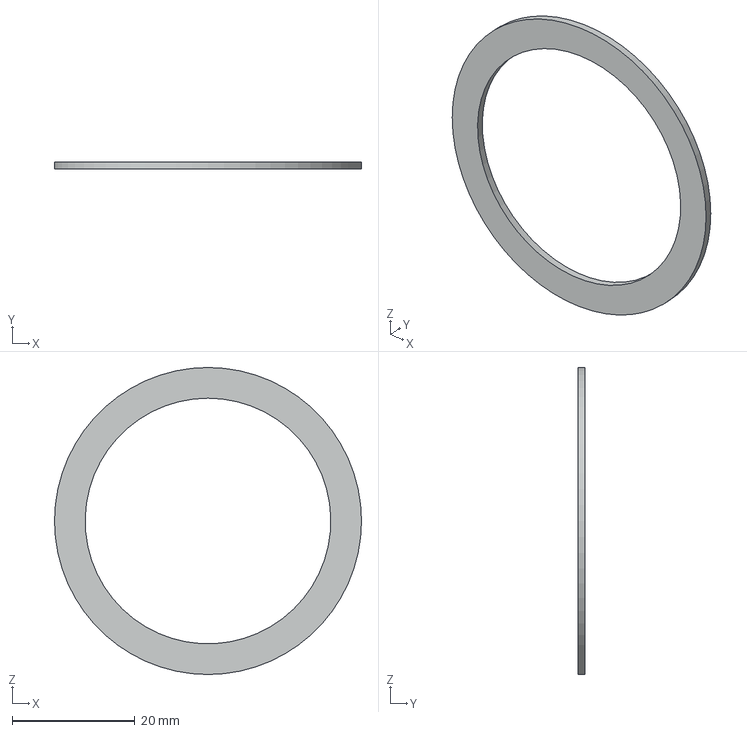
[picture p1: CAD file, 2025-05-22]
Rotation Mechanism/Passscheibe 40x50x1,2 - DIN 988 (ArtNr. 42-03-007).step
50.0 x 1.20 x 50.0 mm
