Zvonko2203/Map-from-transfer-folder/SanaBike New PS/RACM/SB1000/CAD components/28-30-101-A1_ZI06 Mittelteilblech, Grundgestell.step

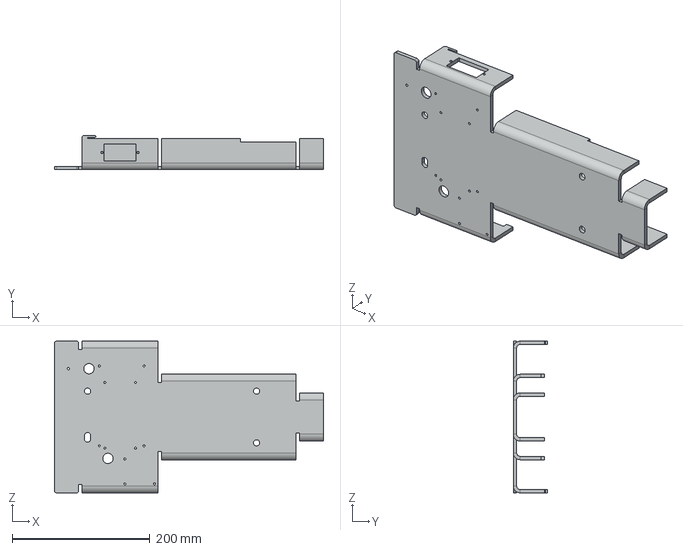
[picture p2: CAD file, 2025-05-22]
SanaBike New PS/RACM/SB1000/CAD components/28-30-101-A1_ZI06 Mittelteilblech, Grundgestell.step
390.0 x 50.0 x 220.0 mm
