Zvonko2203/Map-from-transfer-folder/SanaBike New PS/RACM/SB500/CAD components/Obsolite/28-11-102_ZI03 Abdeckblech, Ringkerntrafo.step

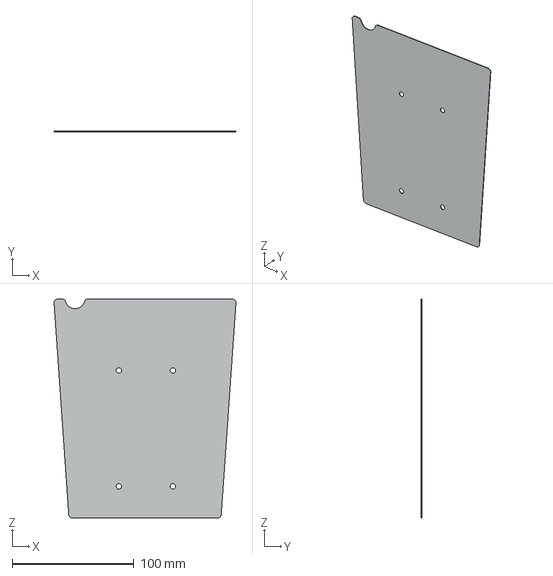
[picture p4: CAD file, 2025-05-22]
SanaBike New PS/RACM/SB500/CAD components/Obsolite/28-11-102_ZI03 Abdeckblech, Ringkerntrafo.step
149.6 x 0.5 x 180.0 mm
