Zvonko2203/Map-from-transfer-folder/Test Station/Test_Station_Front_Housing.step

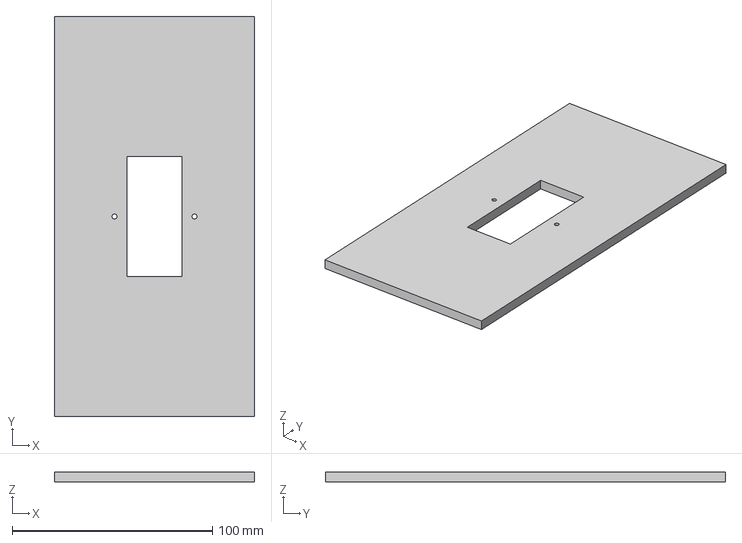
[picture p5: CAD file, 2025-05-22]
Test Station/Test_Station_Front_Housing.step
100.0 x 200.0 x 5.00 mm
