Zvonko2203/Map-from-transfer-folder/SanaBike New PS/RACM/SB500/CAD components/21-31-101-A1_ZI03 Grundrohr, Grundgestell_.step

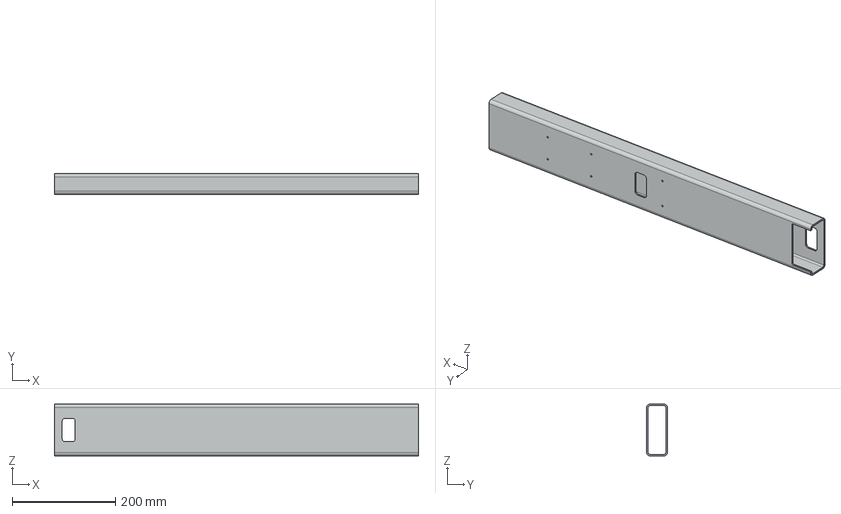
[picture p6: CAD file, 2025-05-22]
SanaBike New PS/RACM/SB500/CAD components/21-31-101-A1_ZI03 Grundrohr, Grundgestell_.step
705.0 x 40.0 x 100.0 mm
