Zvonko2203/Map-from-transfer-folder/SanaBike 500 Modifield/Rotation Mechanism/Linsenflanschkopf (ecosyn-fix) M4x8 BN4825 (40-08-015).step

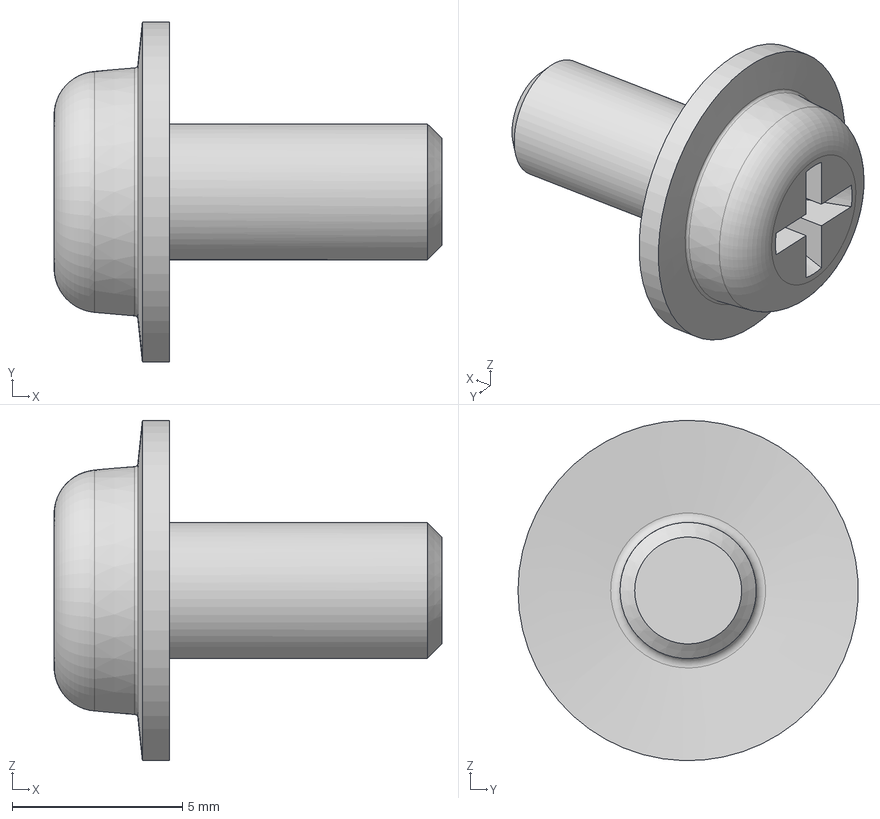
[picture p8: CAD file, 2025-05-22]
SanaBike 500 Modifield/Rotation Mechanism/Linsenflanschkopf (ecosyn-fix) M4x8 BN4825 (40-08-015).step
11.4 x 9.99 x 10.00 mm
