Zvonko2203/Map-from-transfer-folder/Test Station/Housing Debugger.step

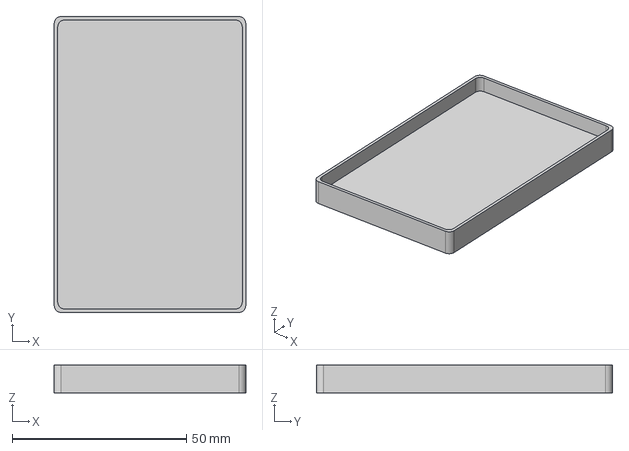
[picture p9: CAD file, 2025-05-22]
Test Station/Housing Debugger.step
55.0 x 85.0 x 8.00 mm
