Zvonko2203/Map-from-transfer-folder/(list of files, cad)

Other CAD files:
SanaBike New PS/RACM/SB1000/CAD components/Obsolite/28-30-101-A1_ZI06 Mittelteilblech, Grundgestell .step
Template folder/ERG_template_GENERAL.dwg
Rotation Mechanism/35-30-xxx Plain Bearing socket.dwg
SanaBike 500 Modifield/Rotation Mechanism/35-30-xxx Plain Bearing socket.dwg
SanaBike New PS/RACM/SB500/CAD components/Obsolite/21-31-101-A1_ZI03 Grundrohr, Grundgestell.step
Template folder/ERG_template_GENERAL 2.dwg
Rotation Mechanism/27-30-400_ZI05 Lager, Gehäuse, Messkopf.dwg
SanaBike 500 Modifield/Rotation Mechanism/27-30-400 Bearing, Housing Measuring Head.dwg
10-30-100 SanaBike 1000_/1,5nF, 250V Kondensator (HerstNr. MPY20W1150FA00MSC9).ipt
10-30-100 SanaBike 1000_/100nF, 440V Kondensator (HerstNr. B81141C1103M).ipt
10-30-100 SanaBike 1000_/20-30-200_ZI01 Antriebseinheit Typ3, kpl.iam
10-30-100 SanaBike 1000_/20-30-602 Messkopf SB3-1_2022-06-23 - BD+SpO2.iam
10-30-100 SanaBike 1000_/21-10-202_ZI00 Spannhebel Stufe 2, kpl.iam
10-30-100 SanaBike 1000_/21-10-203_ZI00 Spannhebel Stufe 1, kpl.iam
10-30-100 SanaBike 1000_/21-10-803-A1_ZI00 Rohr, Sattelstange.ipt
10-30-100 SanaBike 1000_/21-10-803-A2_ZI00 Bolzen, Sattelstange.ipt
10-30-100 SanaBike 1000_/21-10-803-A_ZI00 Sattelstange, kpl.iam
10-30-100 SanaBike 1000_/21-10-806_ZI00 Lenker SanaBike, kpl.iam
10-30-100 SanaBike 1000_/21-10-830-A1_ZI00 Führungsrohr, Sattelstange.ipt
10-30-100 SanaBike 1000_/21-10-830-A2_ZI01 Klemmhalter, Sattelführungsrohr.ipt
10-30-100 SanaBike 1000_/21-10-830-A3_ZI00 Befestigungswinkel, Sattelführungsrohr.ipt
10-30-100 SanaBike 1000_/21-10-830-A_ZI02 Sattelführungsrohr, kpl.iam
10-30-100 SanaBike 1000_/21-30-101-A1_ZI02 Führungsrohr, Lenkerstange, Grundgestell.ipt
10-30-100 SanaBike 1000_/21-30-101-A2_ZI01 Anschweißplatte, Lenkerführungsrohr, Grundgestell.ipt
10-30-100 SanaBike 1000_/21-30-101-A_ZI01 Führungsrohr, Lenkerstange, kpl.iam
10-30-100 SanaBike 1000_/21-30-101_ZI02 Grundgestell kpl.iam
10-30-100 SanaBike 1000_/21-30-102-A1_ZI01 Querrohr vorne, Grundgestell.ipt
10-30-100 SanaBike 1000_/21-30-102-A3_ZI01 Achsbolzen.ipt
10-30-100 SanaBike 1000_/21-30-102-A_ZI01 Querrohr vorne kpl, Grundgestell.iam
10-30-100 SanaBike 1000_/21-30-220-A_ZI04 Grundblech, Gehäuse, Antriebseinheit Typ3.ipt
10-30-100 SanaBike 1000_/21-30-220-B1_ZI03 Seitenblech, Gehäuse, Antriebseinheit Typ3.ipt
10-30-100 SanaBike 1000_/21-30-220-B2_ZI02 Mittelblech, Gehäuse, Antriebseinheit Typ3.ipt
10-30-100 SanaBike 1000_/21-30-220-B3_ZI01 DMS Montageplatte, Antriebseinheit Typ3.ipt
10-30-100 SanaBike 1000_/21-30-220-B_ZI01 Seitenteil, Antriebseinheit Typ3, kpl.iam
10-30-100 SanaBike 1000_/21-30-801-A1_ZI01 Lenkerstange.ipt
10-30-100 SanaBike 1000_/21-30-801-A2_ZI04 Anschraubplatte, Lenkerverkleidung.ipt
10-30-100 SanaBike 1000_/21-30-801-A3_ZI04 Klemmklotz, Lenkerklemmung.ipt
10-30-100 SanaBike 1000_/21-30-801-A_ZI01 Lenkerstange, kpl.iam
10-30-100 SanaBike 1000_/25-30-100_ZI02 Lenkerverkleidung.ipt
10-30-100 SanaBike 1000_/25-30-101_ZI02 Lenkerklemmung.ipt
10-30-100 SanaBike 1000_/26-10-201_ZI01 Tretlagerewelle, Antriebseinheit.ipt
10-30-100 SanaBike 1000_/26-10-203_ZI01 Spannrad Stufe 1, Riemenspanner.ipt
10-30-100 SanaBike 1000_/26-10-204_ZI06 Freilaufwelle, Antriebseinheit.ipt
10-30-100 SanaBike 1000_/26-10-206_ZI01 Spannrad Stufe 2, Riemenspanner.ipt
10-30-100 SanaBike 1000_/26-10-207_ZI00 Gewindestift, Seilaufhängung.ipt
10-30-100 SanaBike 1000_/26-10-208_ZI04 Lagerbolzen, Spannhebel.ipt
10-30-100 SanaBike 1000_/26-10-209_ZI01 Lagerhülse, Spannhebel.ipt
10-30-100 SanaBike 1000_/26-10-210_ZI00 Federlager.ipt
10-30-100 SanaBike 1000_/26-10-211_ZI00 Führungshülse, Druckfeder.ipt
10-30-100 SanaBike 1000_/26-10-212_ZI03 Bolzen, Spannhebel Stufe 1.ipt
10-30-100 SanaBike 1000_/26-10-213_ZI03 Bolzen, Spannhebel Stufe 2.ipt
10-30-100 SanaBike 1000_/26-30-800_ZI01 Anschlußstück BD-Druckausgleich.ipt
10-30-100 SanaBike 1000_/26-37-501_ZI00 Anschlußstück Luftdruck, BD-Messung.ipt
10-30-100 SanaBike 1000_/26-37-502_ZI00 Mutter M7x0,75, Anschlussstück BD-Messung.ipt
10-30-100 SanaBike 1000_/27-10-803_ZI00 Gewindeplatte, Sattelklemmung.ipt
10-30-100 SanaBike 1000_/27-10-804_ZI00 Druckplatte Lenkerrohrklemmung.ipt
10-30-100 SanaBike 1000_/27-30-400_ZI04 Lager, Gehäuse, Messkopf.ipt
10-30-100 SanaBike 1000_/27-30-504_ZI00 Filterscheibe, Drehzahlanzeige, Messkopf Typ3.ipt
10-30-100 SanaBike 1000_/28-10-802_ZI01 Druckplatte, Sattelklemmung.ipt
10-30-100 SanaBike 1000_/28-30-001_ZI01 Haltewinkel, Verkleidung.ipt
10-30-100 SanaBike 1000_/28-30-100_ZI02 Winkelblech, Netzstecker.ipt
10-30-100 SanaBike 1000_/28-30-101-A1_ZI04 Mittelteilblech, Grundgestell.ipt
10-30-100 SanaBike 1000_/28-30-101-A2_ZI00 Blende1, Mittelteilblech, Grundgestell.ipt
10-30-100 SanaBike 1000_/28-30-101-A3_ZI00 Blende2, Mittelteilblech, Grundgestell.ipt
10-30-100 SanaBike 1000_/28-30-101-A4_ZI00 Gewindebolzen, Ringkerntrafo, Grundgestell.ipt
10-30-100 SanaBike 1000_/28-30-101-A5_ZI00 Gewindebolzen, Erdung, Grundgestell.ipt
10-30-100 SanaBike 1000_/28-30-101-A6_ZI00 Gewindebolzen, Netzteilplatine, Grundgestell.ipt
10-30-100 SanaBike 1000_/28-30-101-A_ZI04 Blechmittelteil, Grundgestell.iam
10-30-100 SanaBike 1000_/29-10-201_ZI01 Poly-V Riemenscheibe PJ8 22mm.ipt
10-30-100 SanaBike 1000_/29-10-202_ZI01 Poly-V Riemenscheibe PJ8 22mm.ipt
10-30-100 SanaBike 1000_/29-10-203_ZI02 Poly-V Riemenscheibe PJ4 11mm.ipt
10-30-100 SanaBike 1000_/30-10-111_ZI03 Mittelrohr, Grundgestell.ipt
10-30-100 SanaBike 1000_/30-30-103_ZI01 Querrohr hinten, Grundgestell.ipt
10-30-100 SanaBike 1000_/31-10-112_ZI01 Versteifung, Mittelteilblech, Grundgestell.ipt
10-30-100 SanaBike 1000_/31-10-114_ZI01 Versteifungsblech, Grundgestell.ipt
10-30-100 SanaBike 1000_/31-10-201_ZI01 Spannhebel, Riemenspanner.ipt
10-30-100 SanaBike 1000_/31-10-301_ZI01 Blende, RS232-Platine.ipt
10-30-100 SanaBike 1000_/31-10-803_ZI01 Halter, Faltenbalg Sattel.ipt
10-30-100 SanaBike 1000_/31-10-804_ZI01 Halter, Faltenbalg Lenker.ipt
10-30-100 SanaBike 1000_/31-10-805_ZI00 Halteplatte, Verschalung.ipt
10-30-100 SanaBike 1000_/31-30-100_ZI00 Blech, Abdeckung, Netzteilplatine_StandardSM-FLAT-PATTERN.ipt
10-30-100 SanaBike 1000_/35-10-806_ZIxx Faltenbalg Lenker.ipt
10-30-100 SanaBike 1000_/35-10-807_ZIxx Faltenbalg Sattel.ipt
10-30-100 SanaBike 1000_/35-10-813_ZIxx Fußabdeckung vorne.ipt
10-30-100 SanaBike 1000_/35-10-860 BMS-Streifen.ipt
10-30-100 SanaBike 1000_/35-30-001_ZI04 Auflageplatte, Display.ipt
10-30-100 SanaBike 1000_/35-30-400_ZI04 Unterteil, Gehäuse Messkopf Typ3_Stand2022-06-15 - BD+SpO2.ipt
10-30-100 SanaBike 1000_/35-30-401_ZI03 Oberteil, Gehäuse Messkopf Typ3-x_Displayausschnitt 2,8Zoll.ipt
10-30-100 SanaBike 1000_/35-30-811_ZIxx Verschalung Seitenteile re+li (links).iam
10-30-100 SanaBike 1000_/35-30-811_ZIxx Verschalung Seitenteile re+li (rechts).iam
10-30-100 SanaBike 1000_/35-30-830_ZI00 Isolationsfolie, Netzteilplatine.ipt
10-30-100 SanaBike 1000_/35-30-831_ZI00 Isolationsfolie, Abdeckung Netzteilplatine.ipt
10-30-100 SanaBike 1000_/37-10-201_ZI00 Platine DMS.ipt
10-30-100 SanaBike 1000_/37-10-302 RS232-Schnittstelle.iam
10-30-100 SanaBike 1000_/37-10-504-CH Platine BD (Schiller), teilbestückt.ipt
10-30-100 SanaBike 1000_/37-10-506 Platine BD-Schiller kpl.iam
10-30-100 SanaBike 1000_/37-30-300 Netzteilplatine.iam
10-30-100 SanaBike 1000_/37-30-501 Steuerplatine, teilbestückt (LY_sanabike_30_04_008) - Stand 03-2020.iam
10-30-100 SanaBike 1000_/37-30-503 Platine Drehzahlanzeige.ipt
10-30-100 SanaBike 1000_/38-01-043_ZI00 PVC-Schlauch 8x2mm glasklar.ipt
10-30-100 SanaBike 1000_/39-10-201_ZI00 Zugseil.ipt
10-30-100 SanaBike 1000_/39-10-202-A1_ZI00 Federseil, Seil.ipt
10-30-100 SanaBike 1000_/39-10-202-A2_ZI00 Federseil, Gewindestift.ipt
10-30-100 SanaBike 1000_/39-10-202_ZI00 Federseil.iam
10-30-100 SanaBike 1000_/39-30-800_ZI01 Frontfolie, Messkopf SB3 Typ easy.ipt
10-30-100 SanaBike 1000_/50-01-001_ZI00 Poly-V Riemen, 20mm Stufe 1.ipt
10-30-100 SanaBike 1000_/50-01-002_ZI00 Poly-V Riemen, 10mm Stufe 2.ipt
10-30-100 SanaBike 1000_/59-01-002-A_ZIA Achse, Wirbelstrombremse.ipt
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
