Zvonko2203/Map-from-transfer-folder/Test Station/Housing Debugger.pdf

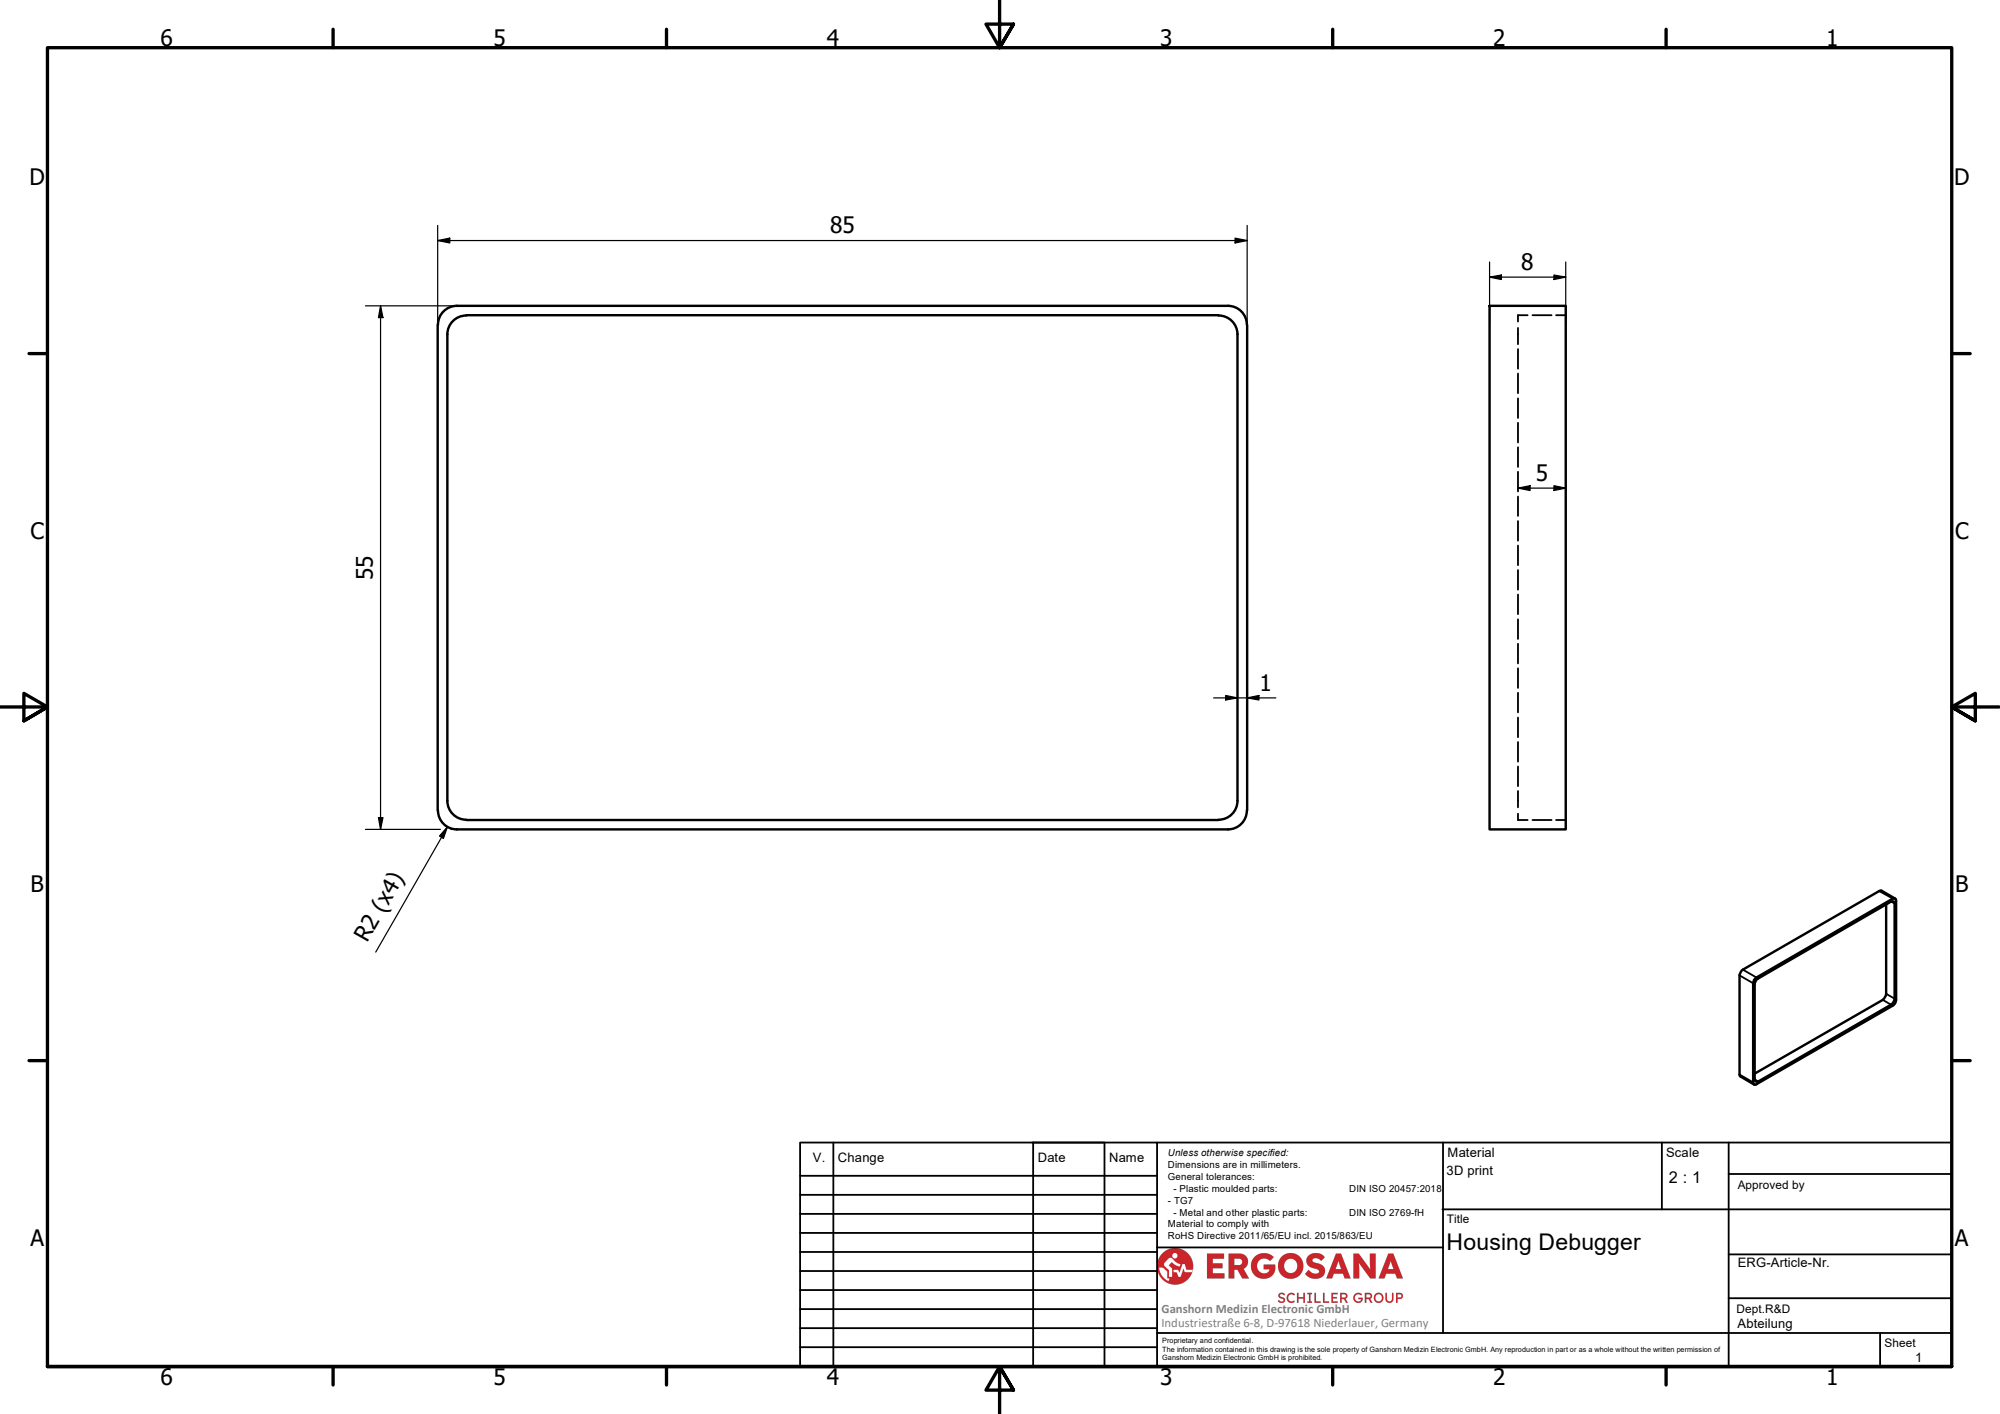
[picture p10: page 1]
Approved by; - Plastic moulded parts:; DIN ISO 20457:2018; - Metal and other plastic parts:; DIN ISO 2769-fH; 3D print

Unless otherwise specified:
Dimensions are in millimeters.
General tolerances:
Material to comply with
RoHS Directive 2011/65/EU incl. 2015/863/EU

Title Housing Debugger

ERG-Article-Nr.

Ganshorn Medizin Electronic GmbH
Industriestraße 6-8, D-97618 Niederlauer, Germany

Proprietary and confidential. The information contained in this drawing is the sole property of Ganshorn Medizin Electronic GmbH. Any reproduction in part or as a whole without the written permission of Ganshorn Medizin Electronic GmbH is prohibited. | Sheet 1
