Zvonko2203/Map-from-transfer-folder/SanaBike New PS/RACM/SB1000/CAD components/28-30-101-A1_ZI06 Mittelteilblech, Grundg.pdf

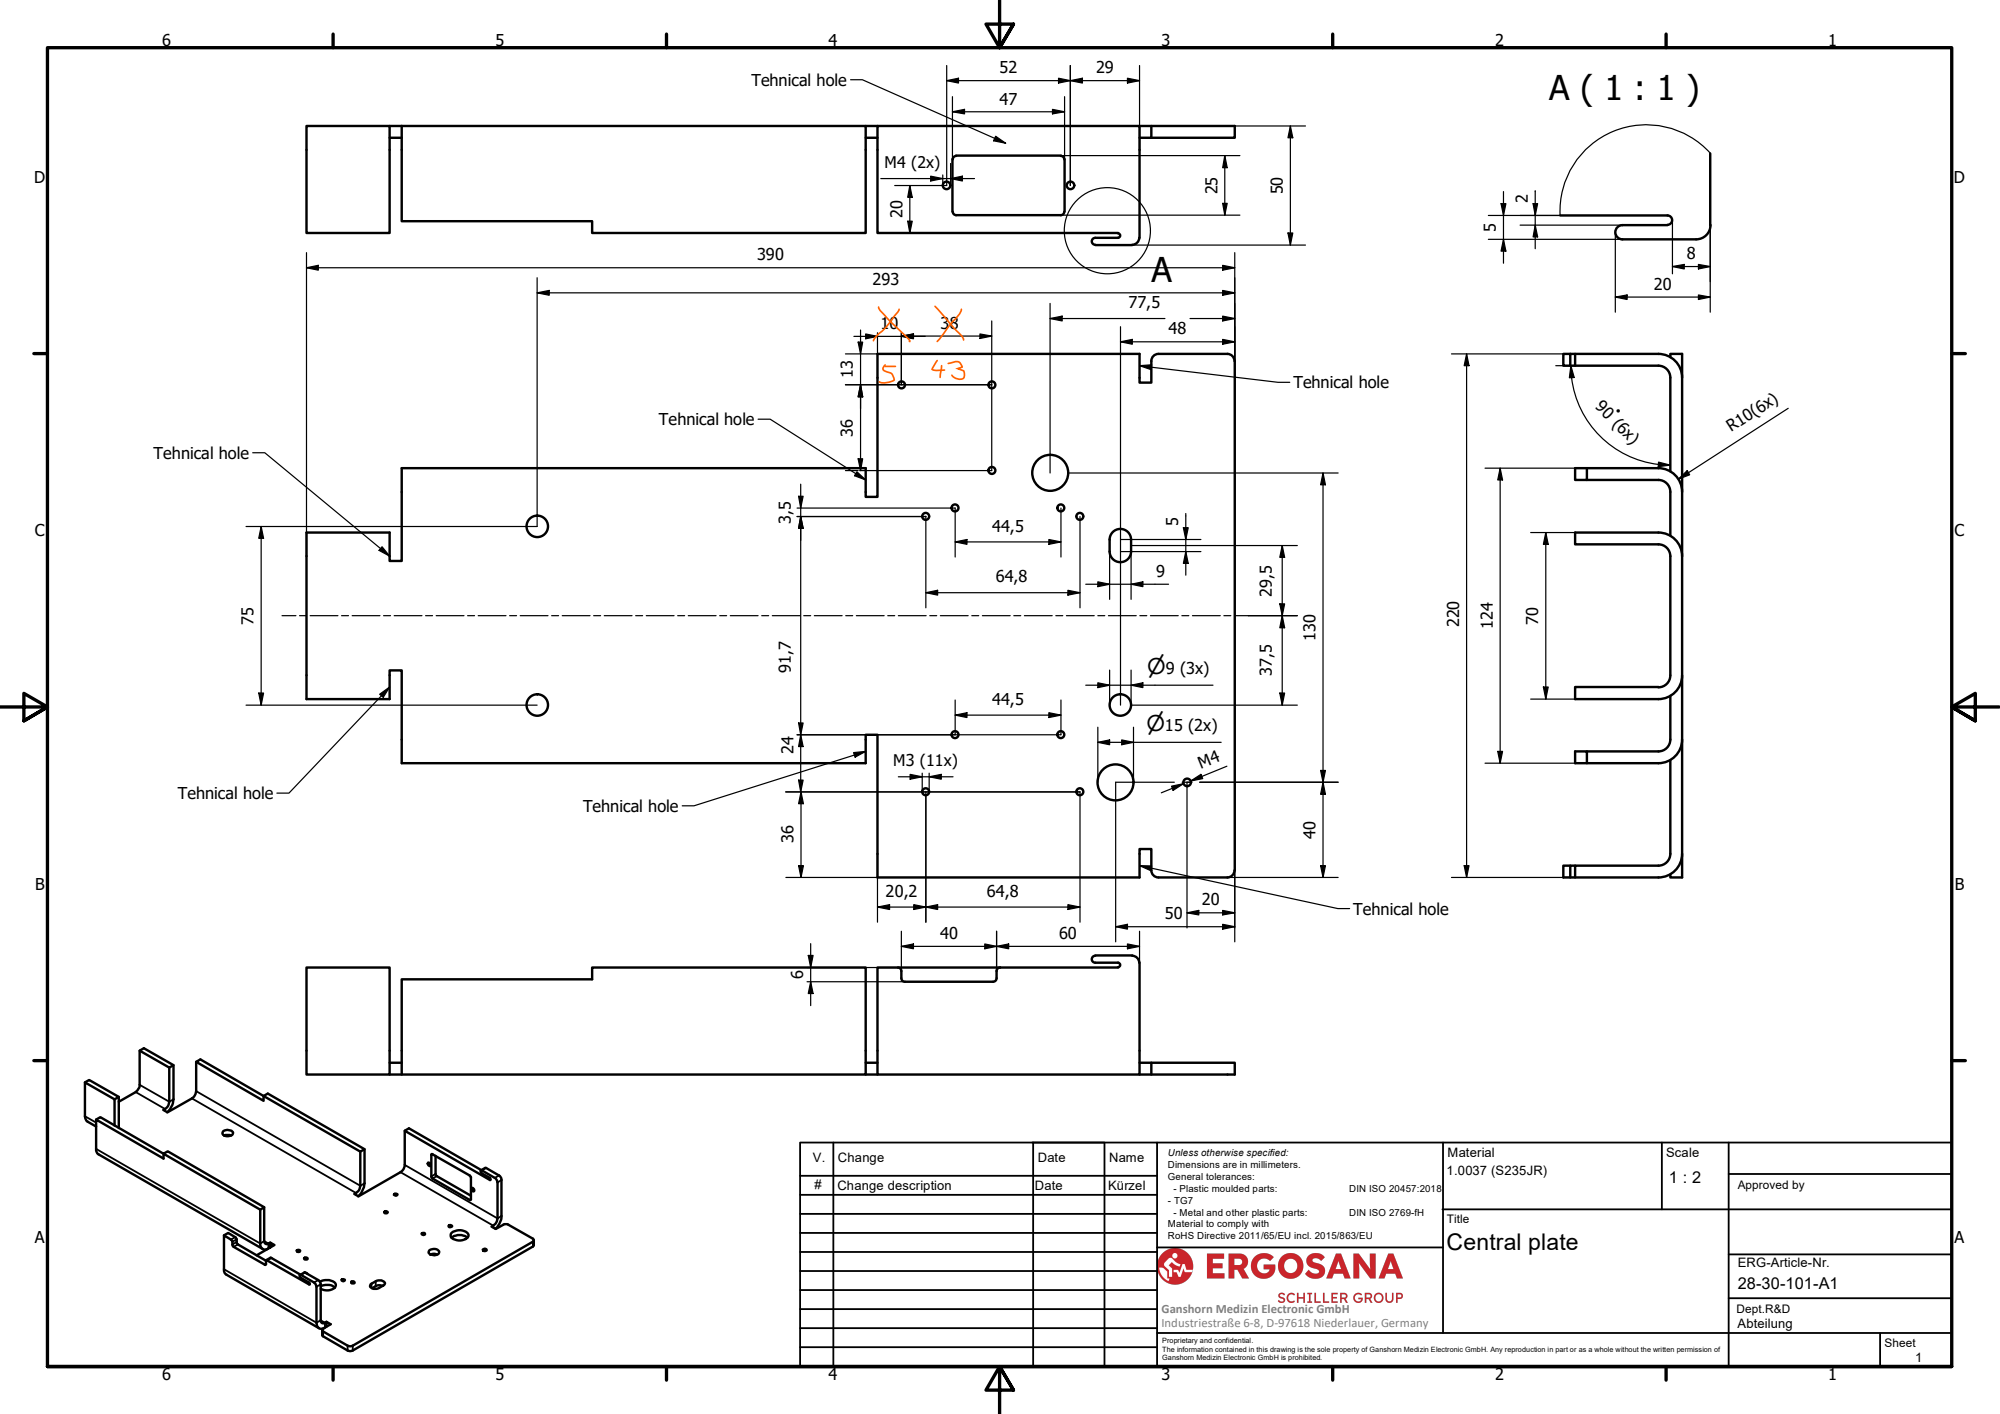
[picture p11: page 1]
Tehnical hole

V. | Change | Date | Name | Unless otherwise specified: Dimensions are in millimeters. General tolerances: - Plastic moulded parts: DIN ISO 20457:2018 - TG7 - Metal and other plastic parts: DIN ISO 2769-fH Material to comply with RoHS Directive 2011/65/EU incl. 2015/863/EU | Material 1.0037 (S235JR) | Scale 1 : 2

# | Change description | Date | Kürzel | | | | Approved by

Title Central plate

ERG-Article-Nr.

Ganshorn Medizin Electronic GmbH
Industriestraße 6-8, D-97618 Niederlauer, Germany

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
