Zvonko2203/Map-from-transfer-folder/SanaBike New PS/RACM/SB500/CAD components/Obsolite/21-31-101-A1_ZI03 Grundrohr, Grundgestell  .pdf

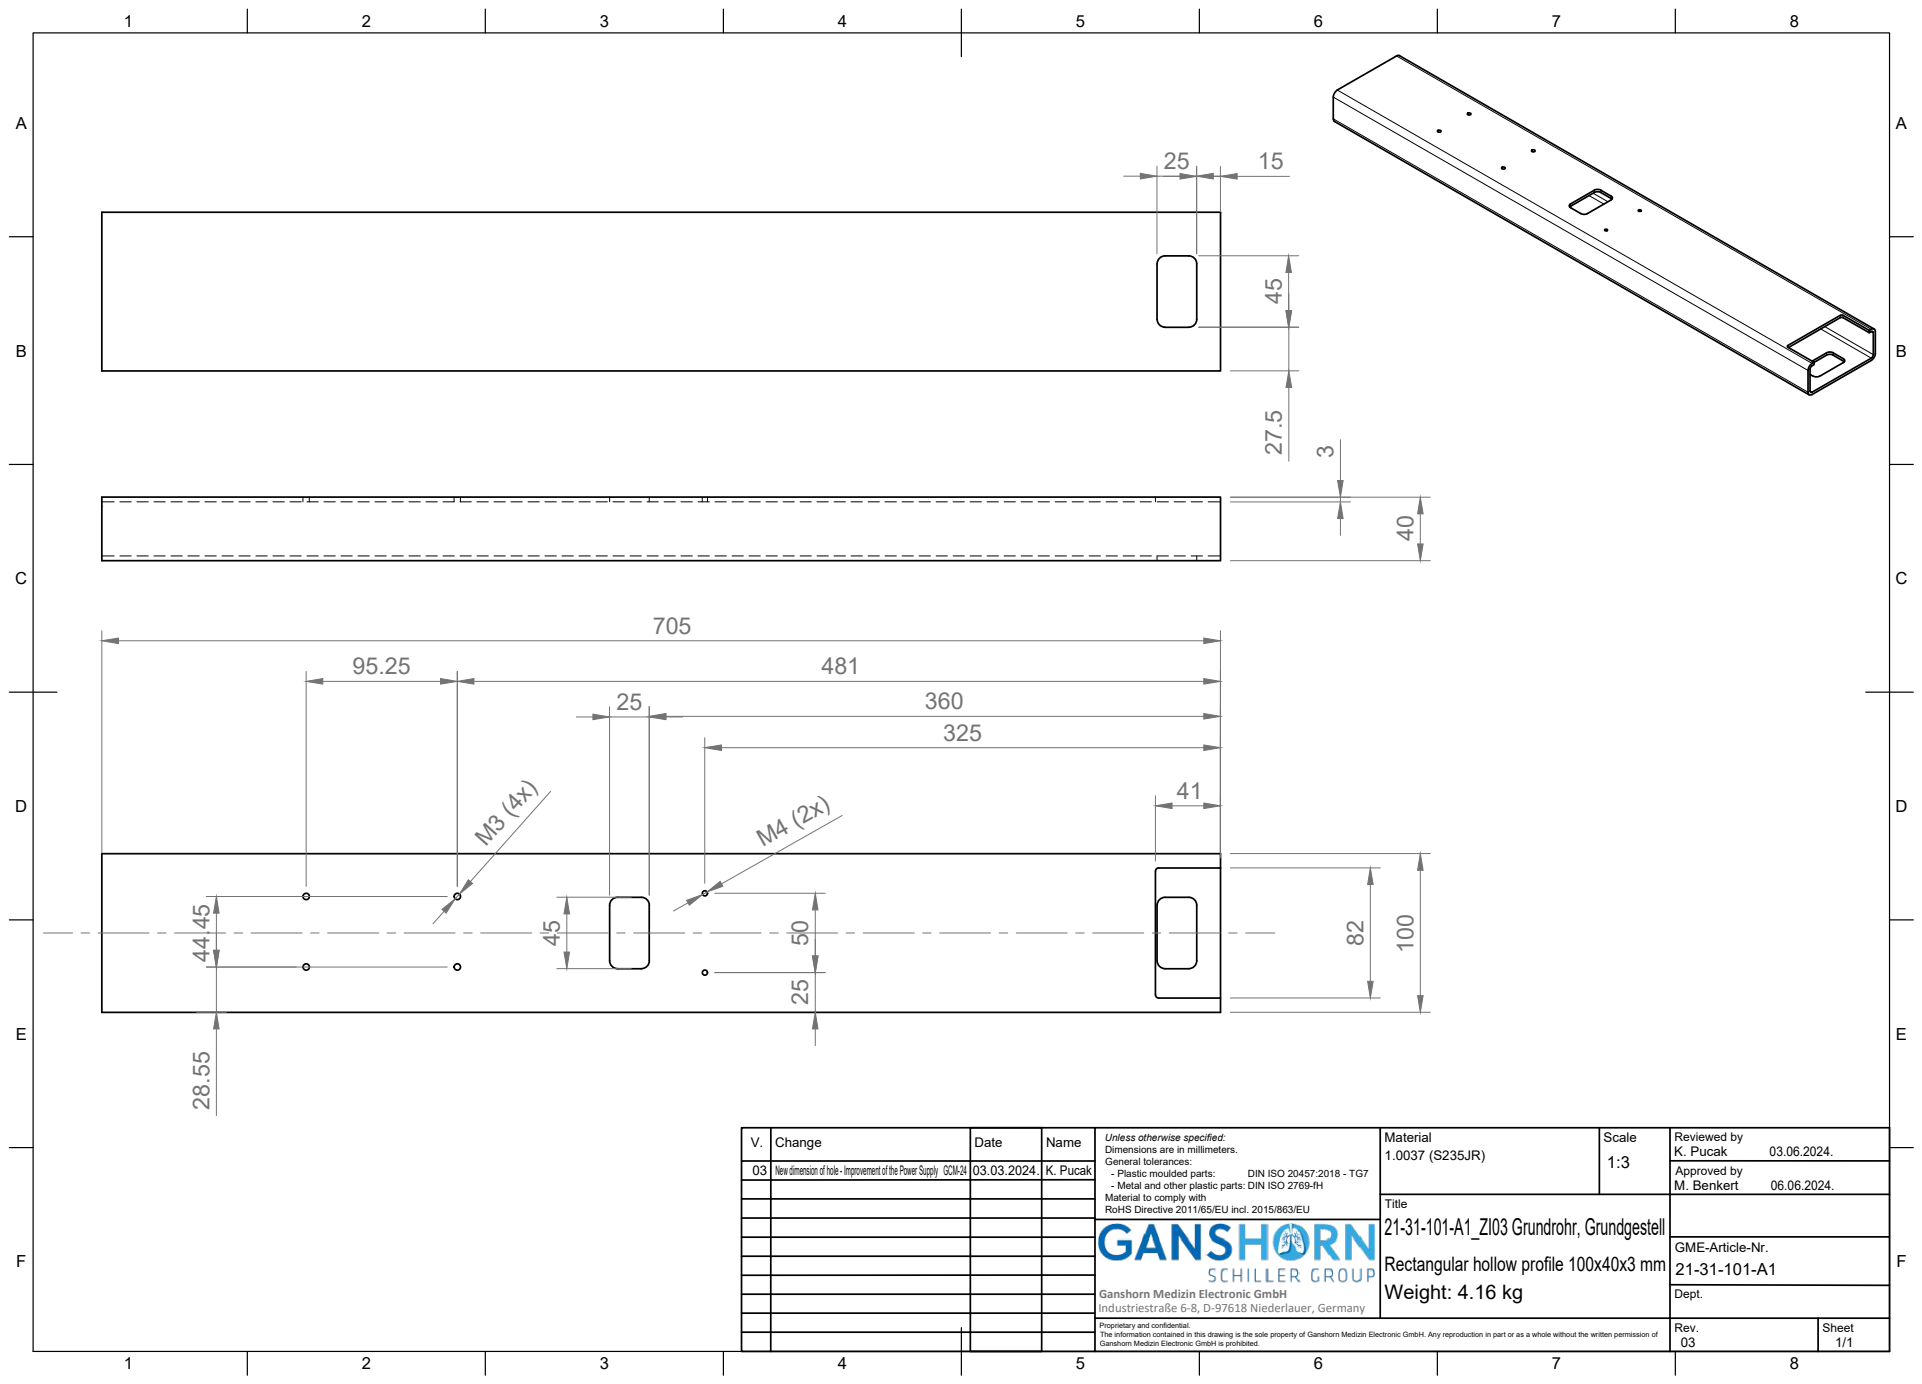
[picture p12: page 1]
Proprietary and confidential. The information contained in this drawing is the sole property of Ganshorn Medizin Electronic GmbH. Any reproduction in part or as a whole without the written permission of Ganshorn Medizin Electronic GmbH is prohibited.; Dept.; Reviewed by; Approved by; - Plastic moulded parts:; DIN ISO 20457:2018 - TG7; - Metal and other plastic parts: DIN ISO 2769-fH Material to comply with RoHS Directive 2011/65/EU incl. 2015/863/EU; Weight: 4.16 kg; M. Benkert; K. Pucak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

Unless otherwise specified: Dimensions are in millimeters. General tolerances:

GME-Article-Nr.

Rectangular hollow profile 100x40x3 mm

Ganshorn Medizin Electronic GmbH
Industriestraße 6-8, D-97618 Niederlauer, Germany
