Zvonko2203/Map-from-transfer-folder/SanaBike New PS/RACM/SB500/CAD components/Obsolite/28-11-102_ZI03 Abdeckblech, Ringkerntrafo  .pdf

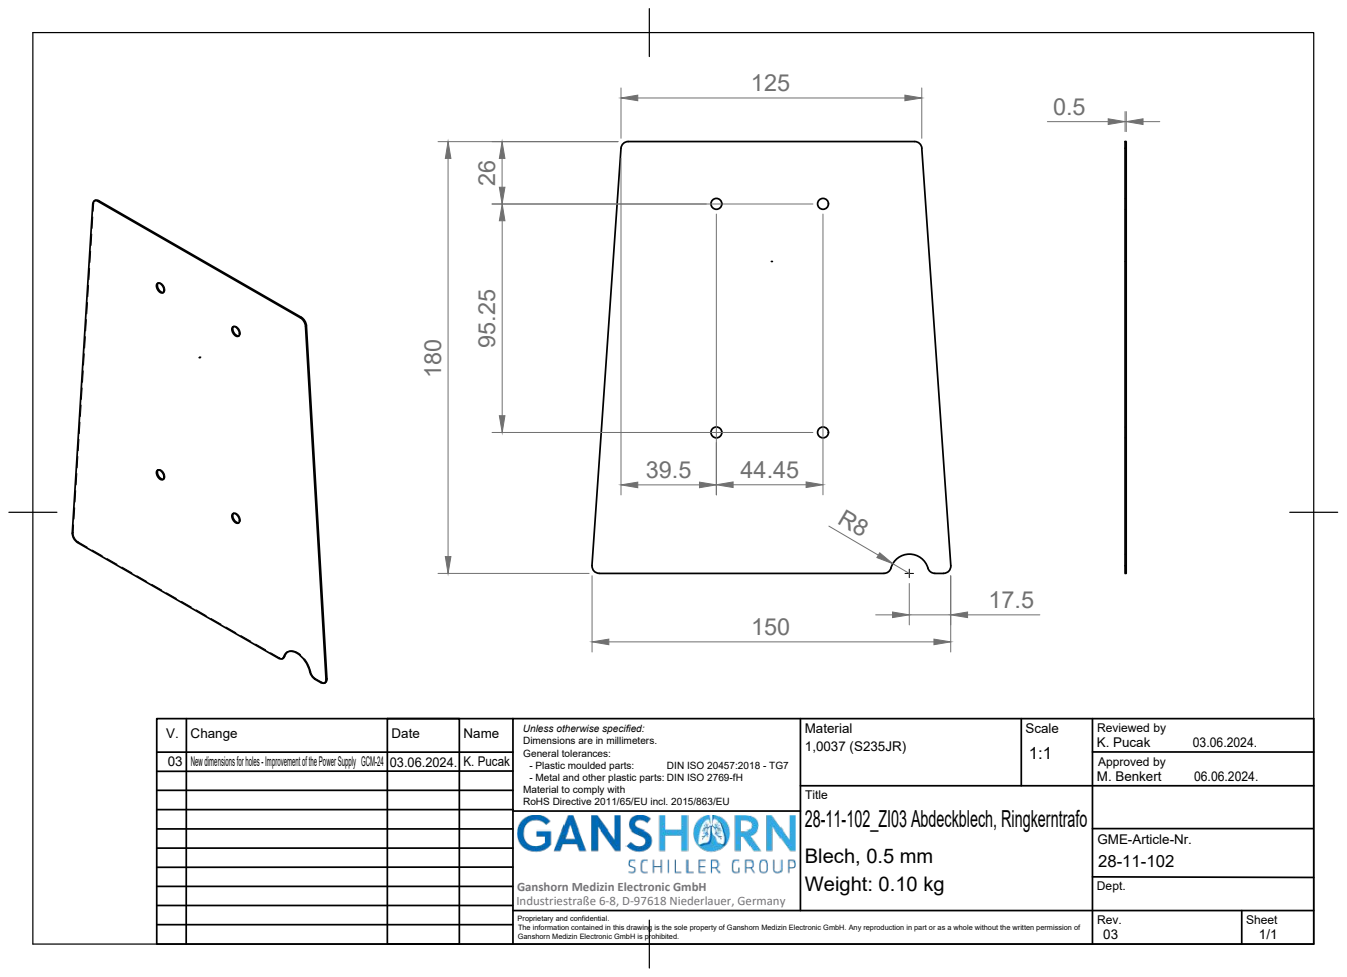
[picture p13: page 1]

V. | Change | Date | Name | Unless otherwise specified: Dimensions are in millimeters. General tolerances: - Plastic moulded parts: DIN ISO 20457:2018 - TG7 | Material 1,0037 (S235JR) | Scale | Reviewed by K. Pucak 03.06.2024. 1:1

03 | New dimensions for holes - Improvement of the Power Supply GCM-24 | 03.06.2024. | K. Pucak | | | | Approved by M. Benkert 06.06.2024.

- Metal and other plastic parts: DIN ISO 2769-fH Material to comply with RoHS Directive 2011/65/EU incl. 2015/863/EU Ganshorn Medizin Electronic GmbH

Title 28-11-102_ZI03 Abdeckblech, Ringkerntrafo Blech, 0.5 mm Weight: 0.10 kg

GME-Article-Nr.

Dept. Proprietary and confidential. The information contained in this drawing is the sole property of Ganshorn Medizin Electronic GmbH. Any reproduction in part or as a whole without the written permission of Ganshorn Medizin Electronic GmbH is prohibited.
Industriestraße 6-8, D-97618 Niederlauer, Germany

Rev. 03 | Sheet 1/1
