Zvonko2203/Map-from-transfer-folder/Rotation Mechanism/27-30-400_ZI05 Lager, Gehäuse, Messkopf.pdf

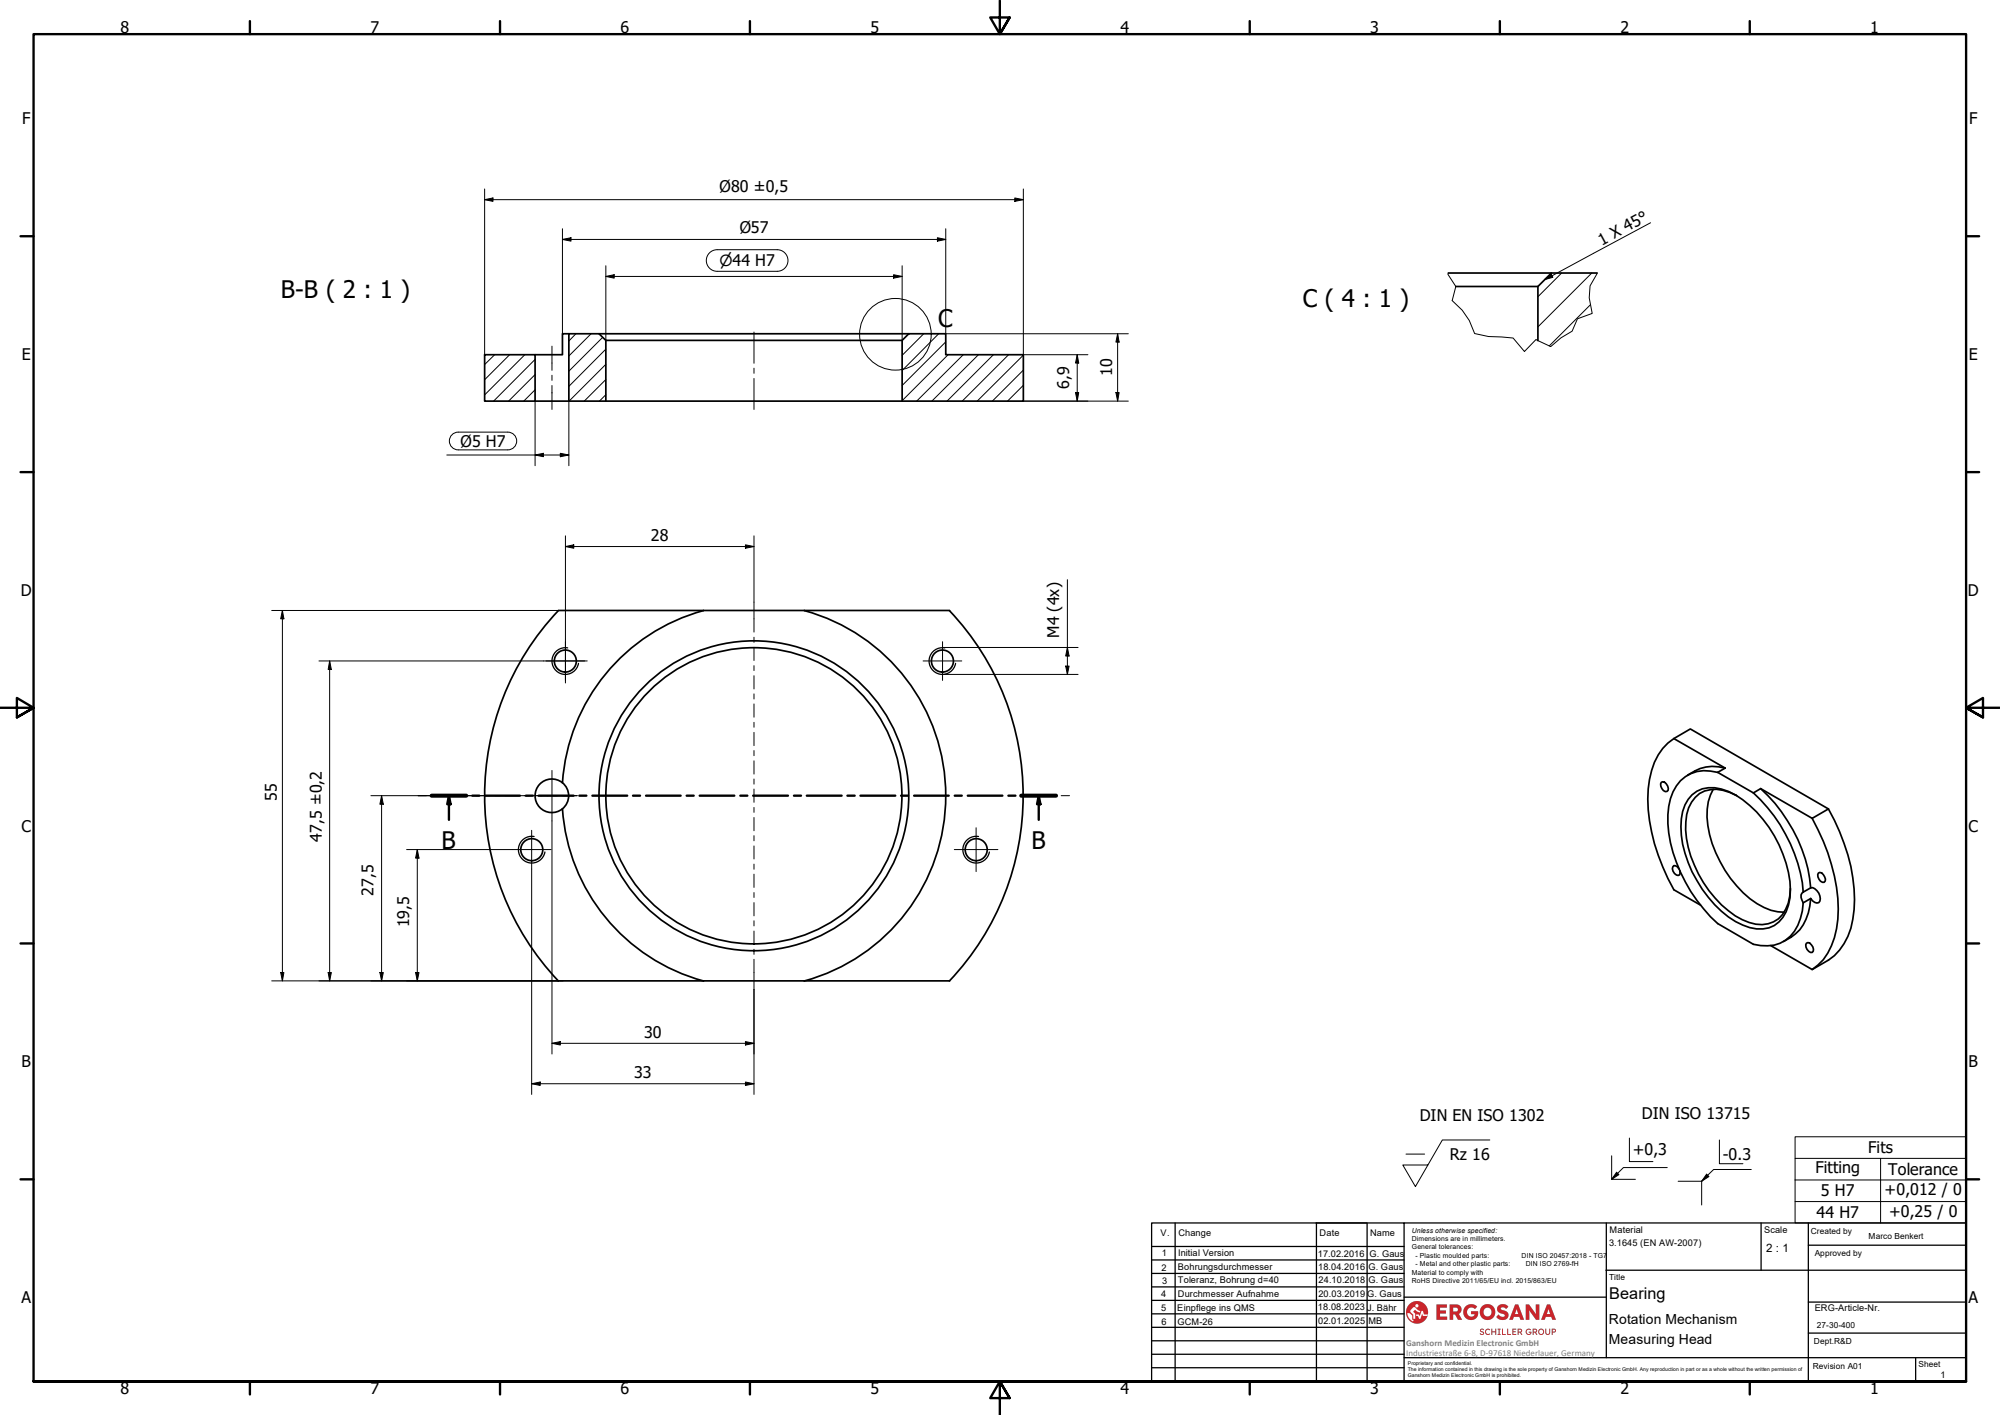
[picture p14: page 1]
Rotation Mechanism; Ganshorn Medizin Electronic GmbH; Measuring Head; Revision A01; DIN ISO 13715

DIN EN ISO 1302

Fitting 5 H7 | Tolerance +0,012 / 0

V. | Change | Date | Name | Unless otherwise specified: Dimensions are in millimeters. General tolerances: - Plastic moulded parts: DIN ISO 20457:2018 - TG7 - Metal and other plastic parts: DIN ISO 2769-fH Material to comply with RoHS Directive 2011/65/EU incl. 2015/863/EU | Material 3.1645 (EN AW-2007) | Scale 2 : 1 | Created by Marco Benkert

1 | Initial Version | 17.02.2016 | G. Gaus | | | | Approved by
2 | Bohrungsdurchmesser | 18.04.2016 | G. Gaus
3 | Toleranz, Bohrung d=40 | 24.10.2018 | G. Gaus
4 | Durchmesser Aufnahme | 20.03.2019 | G. Gaus
5 | Einpflege ins QMS | 18.08.2023 | J. Bähr | | | | ERG-Article-Nr. 27-30-400
6 | GCM-26 | 02.01.2025 | MB

Industriestraße 6-8, D-97618 Niederlauer, Germany

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
