Zvonko2203/Map-from-transfer-folder/Rotation Mechanism/35-30-xxx Plain Bearing socket.pdf

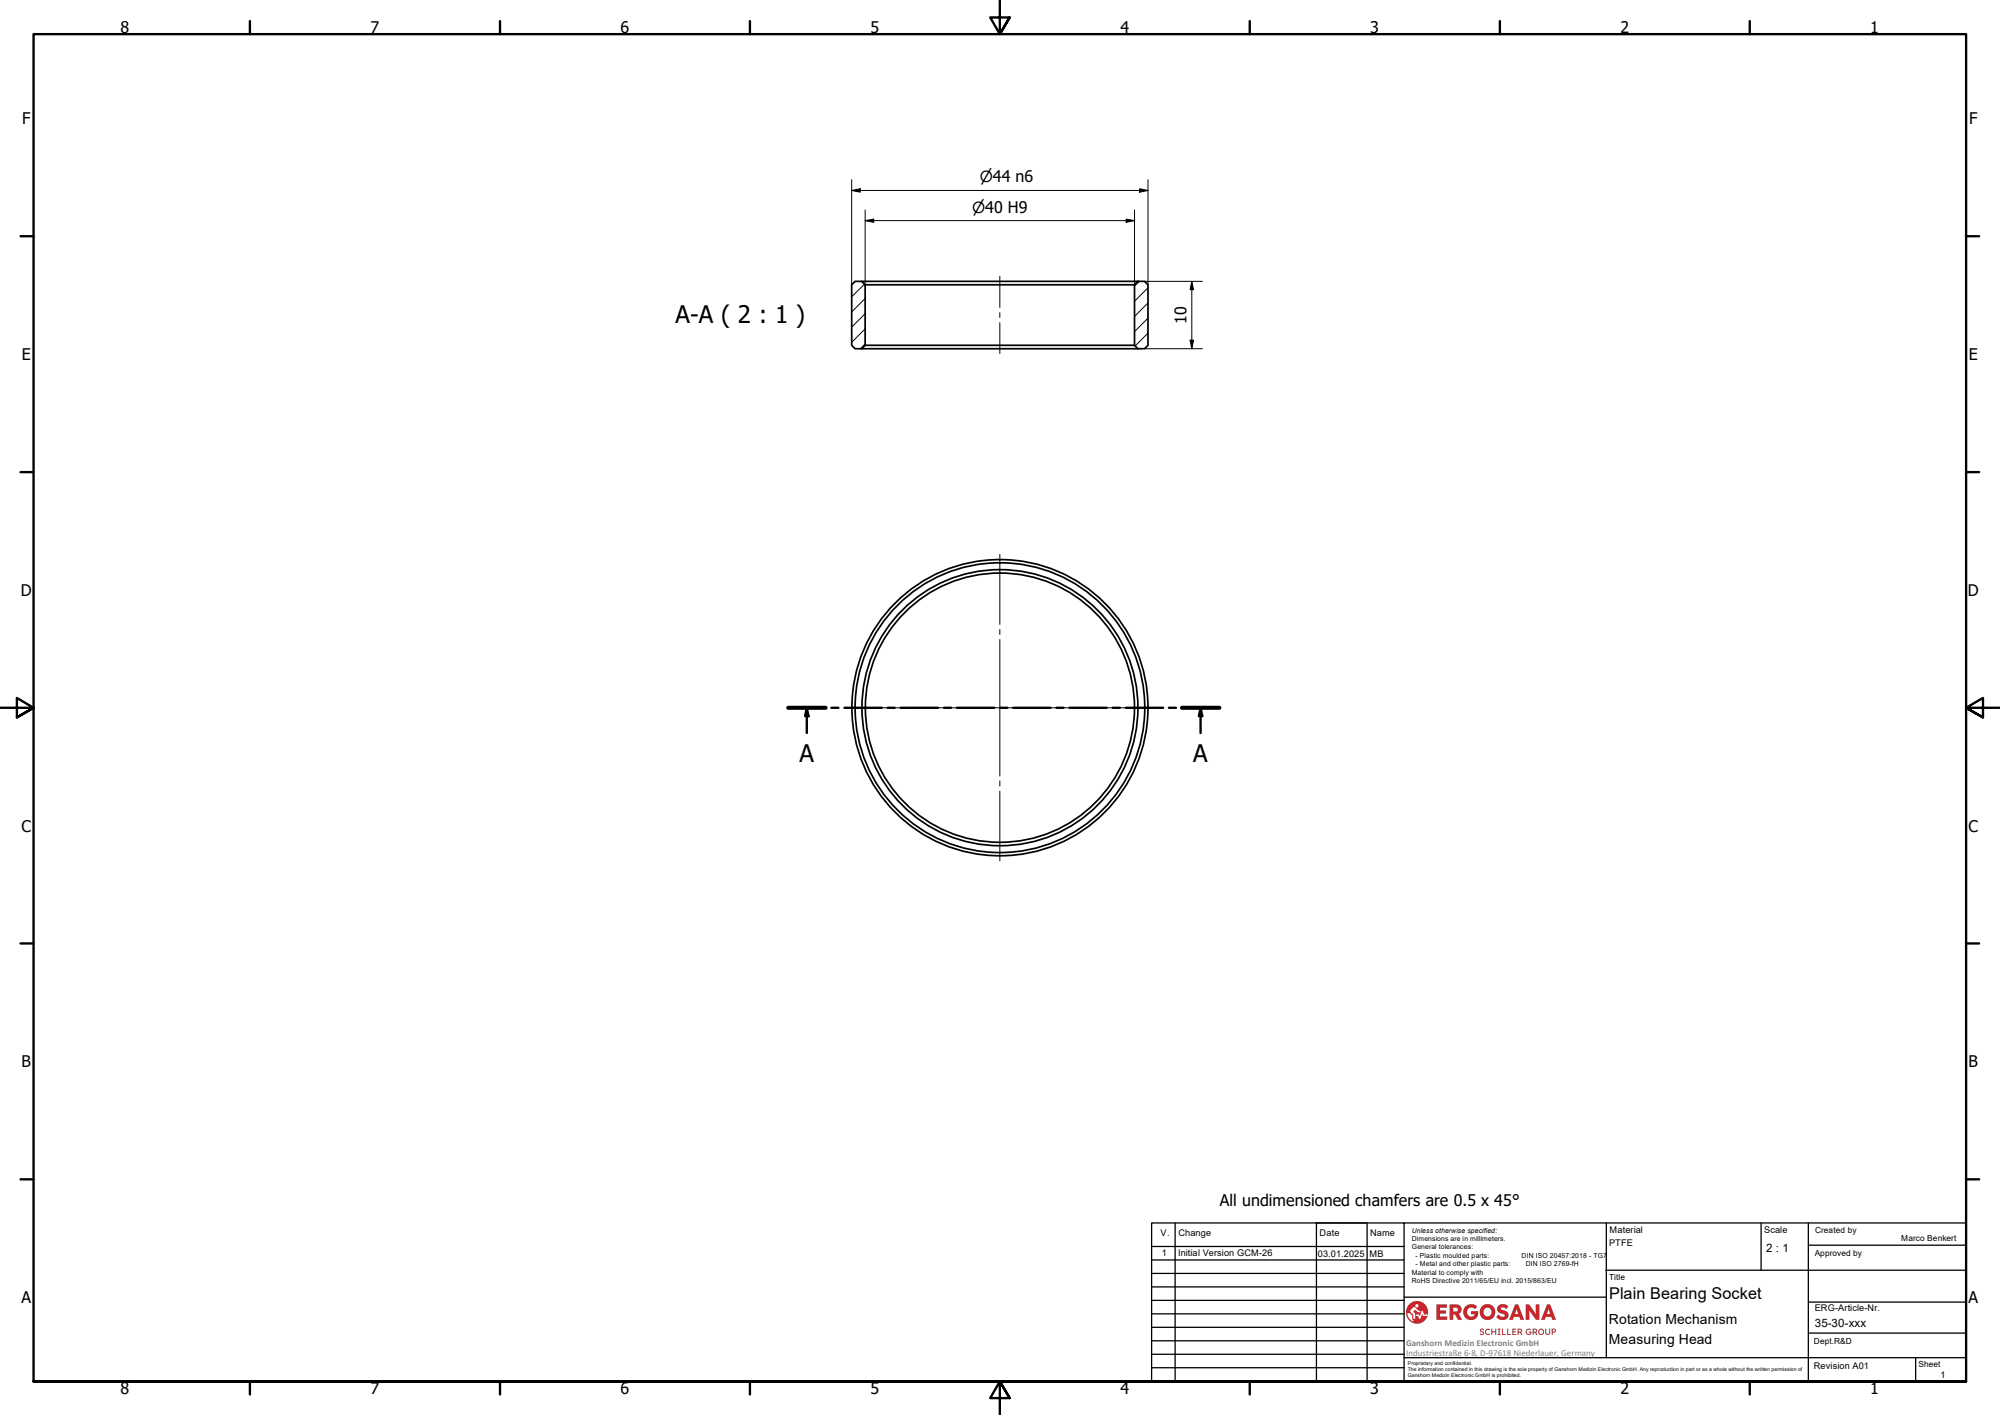
[picture p15: page 1]
Rotation Mechanism; 35-30-xxx; Ganshorn Medizin Electronic GmbH; Measuring Head; Revision A01

All undimensioned chamfers are 0.5 x 45°

V. | Change | Date | Name | Unless otherwise specified: Dimensions are in millimeters. General tolerances: - Plastic moulded parts: DIN ISO 20457:2018 - TG7 - Metal and other plastic parts: DIN ISO 2769-fH Material to comply with RoHS Directive 2011/65/EU incl. 2015/863/EU | Material PTFE | Scale 2 : 1 | Created by Marco Benkert

1 | Initial Version GCM-26 | 03.01.2025 | MB | | | | Approved by

Title
Plain Bearing Socket

ERG-Article-Nr.

Industriestraße 6-8, D-97618 Niederlauer, Germany

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
