Zvonko2203/Map-from-transfer-folder/SanaBike 1000 E-Sattel/26-10-821-A Thrust pin, e-seat adjustment.pdf

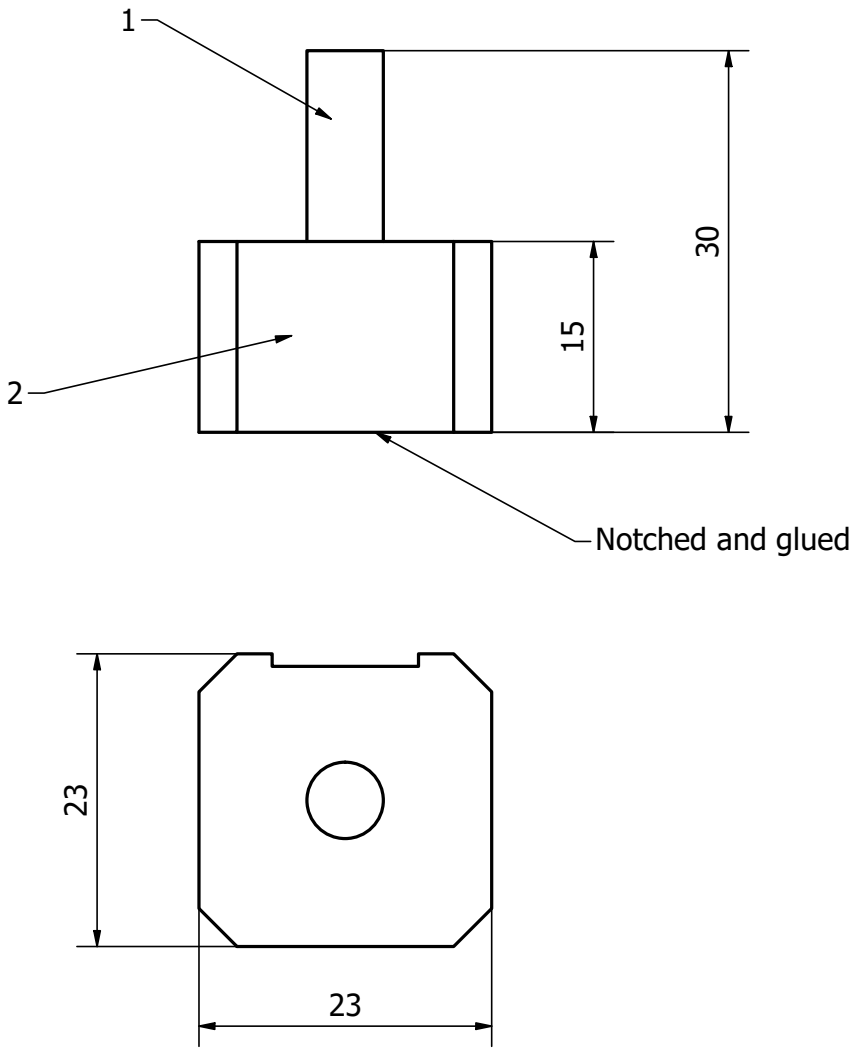
[picture p16: page 1]

PARTS LIST

ITEM | QTY | PART NUMBER | DESCRIPTION
1 | 1 | 26-10-821-A1 | Bolt M6
2 | 1 | 26-10-824-A2 | Thrust bolt, e-seat adjustment

Notched and glued

V. | Change | Date | Name | Unless otherwise specified: Dimensions are in millimeters. General tolerances: - Plastic moulded parts: DIN ISO 20457:2018 - TG7 - Metal and other plastic parts: DIN ISO 2769-fH Material to comply with RoHS Directive 2011/65/EU incl. 2015/863/EU | Material 26-10-821-A | Scale 2 : 1

01 | Inclusion in the QMS | 23.09.2024 | J. Bähr | | | | Approved by
02 | Transfer to Inventor | 19.03.2025 | Z.Gabric

Title Thrust pin, e-seat adjustment

ERG-Article-Nr.

Ganshorn Medizin Electronic GmbH
Industriestraße 6-8, D-97618 Niederlauer, Germany

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
