Zvonko2203/Map-from-transfer-folder/Drive Unit/Drive Unit-tehnical Drawing 2025/21-10-206 set.pdf

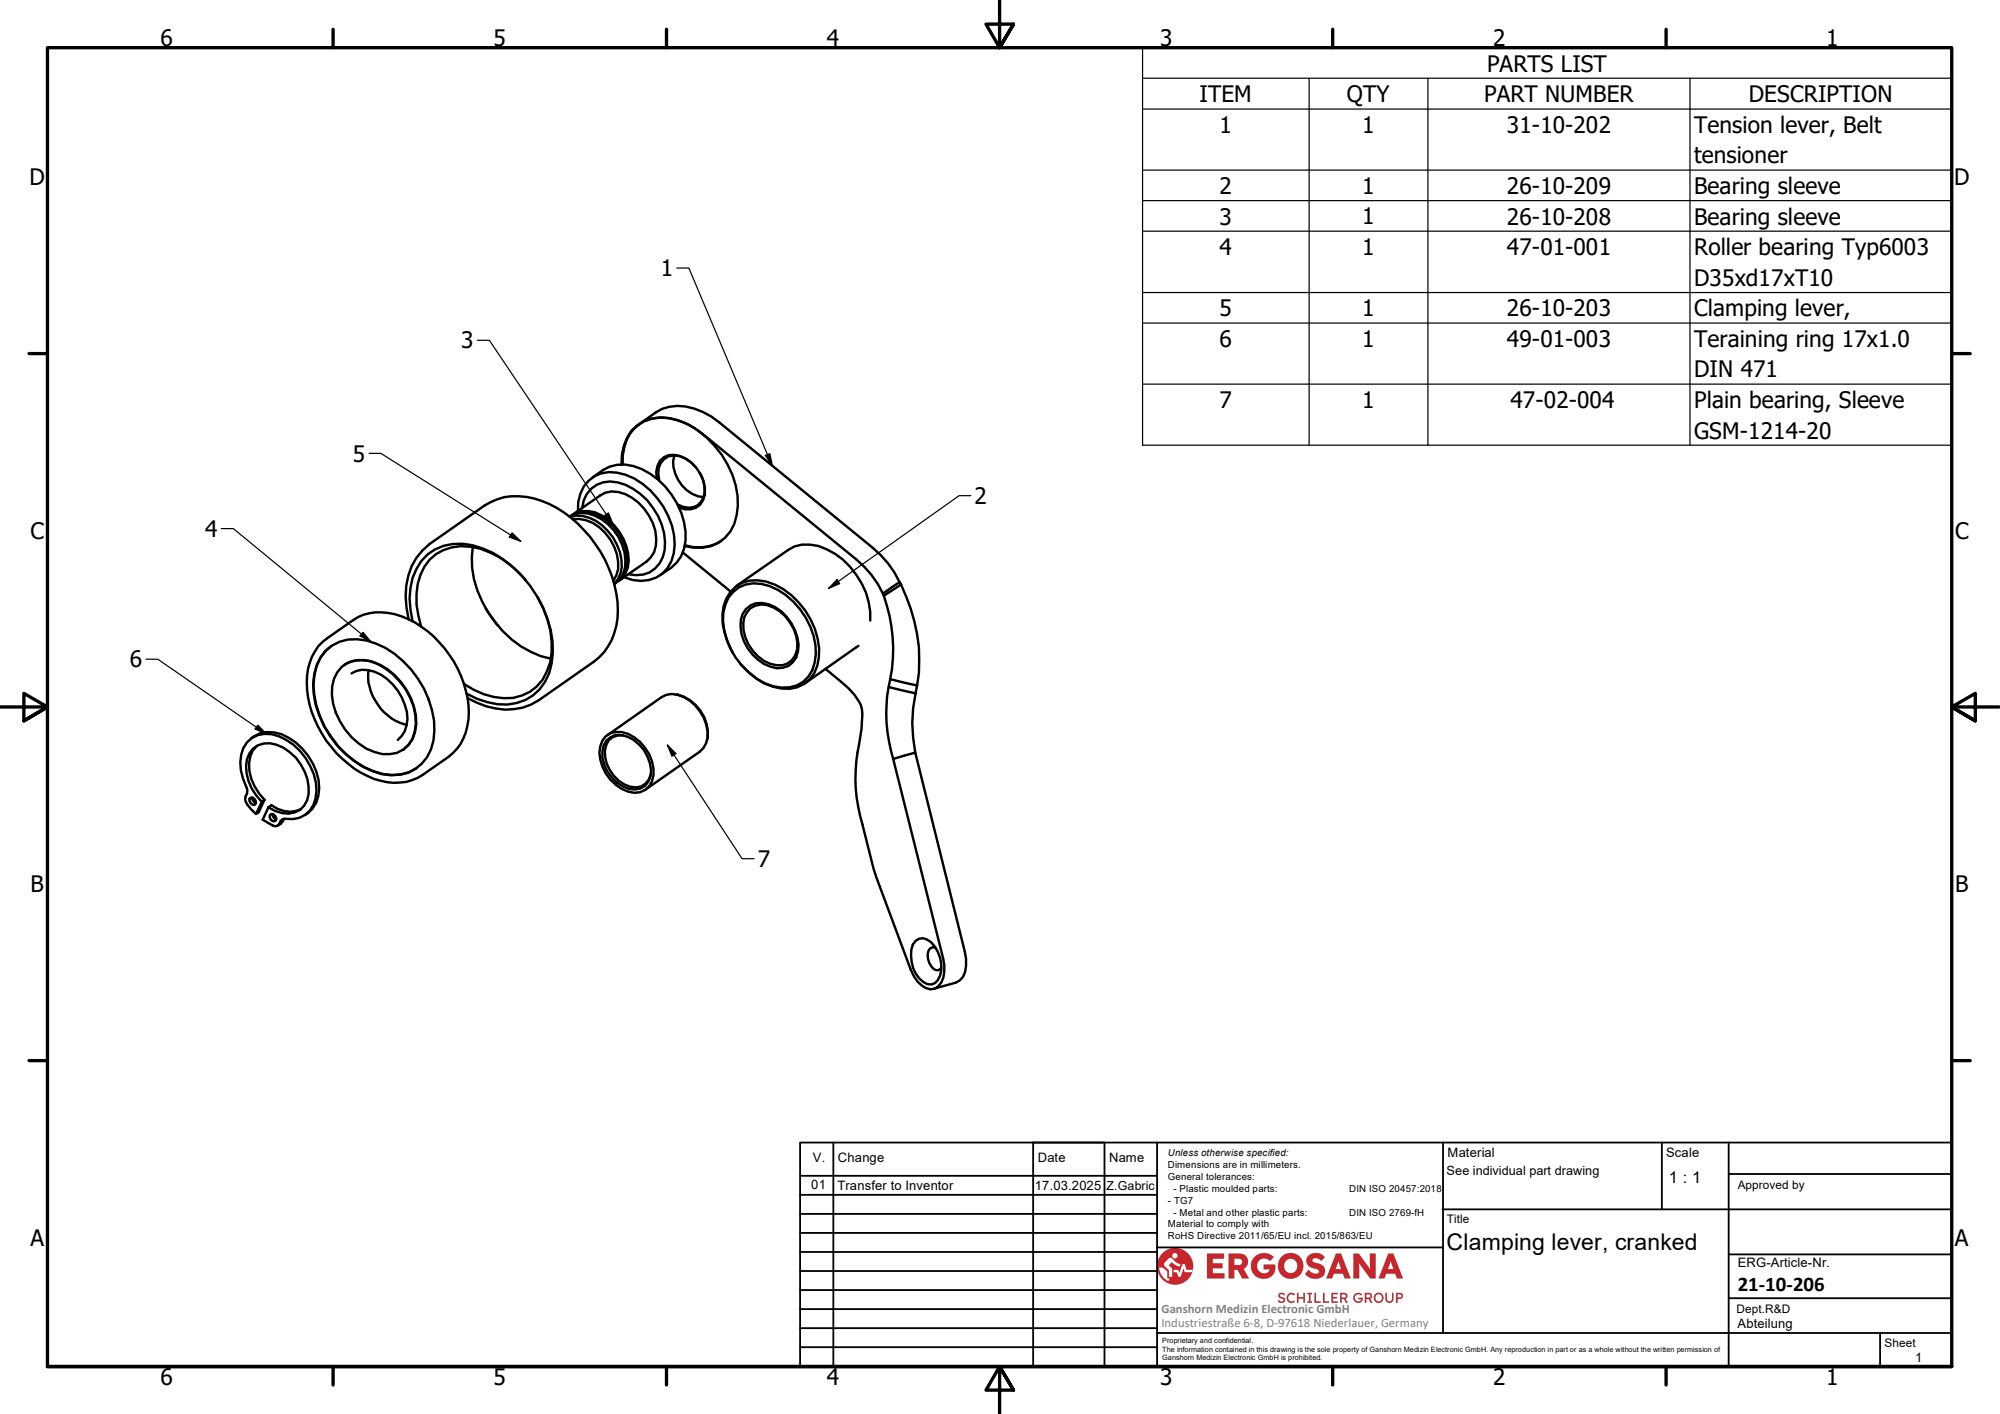
[picture p17: page 1]

PARTS LIST

ITEM | QTY | PART NUMBER | DESCRIPTION
1 | 1 | 31-10-202 | Tension lever, Belt tensioner

2 | 1 | 26-10-209 | Bearing sleeve
3 | 1 | 26-10-208 | Bearing sleeve
4 | 1 | 47-01-001 | Roller bearing Typ6003 D35xd17xT10

5 | 1 | 26-10-203 | Clamping lever,
6 | 1 | 49-01-003 | Teraining ring 17x1.0 DIN 471

7 | 1 | 47-02-004 | Plain bearing, Sleeve GSM-1214-20

V. | Change | Date | Name | Unless otherwise specified: Dimensions are in millimeters. General tolerances: - Plastic moulded parts: DIN ISO 20457:2018 - TG7 - Metal and other plastic parts: DIN ISO 2769-fH Material to comply with RoHS Directive 2011/65/EU incl. 2015/863/EU | Material See individual part drawing | Scale 1 : 1

01 | Transfer to Inventor | 17.03.2025 | Z.Gabric | | | | Approved by

Title Clamping lever, cranked

ERG-Article-Nr.

Ganshorn Medizin Electronic GmbH
Industriestraße 6-8, D-97618 Niederlauer, Germany

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
