Zvonko2203/Map-from-transfer-folder/Drive Unit/Drive Unit-tehnical Drawing 2025/26-10-212.pdf

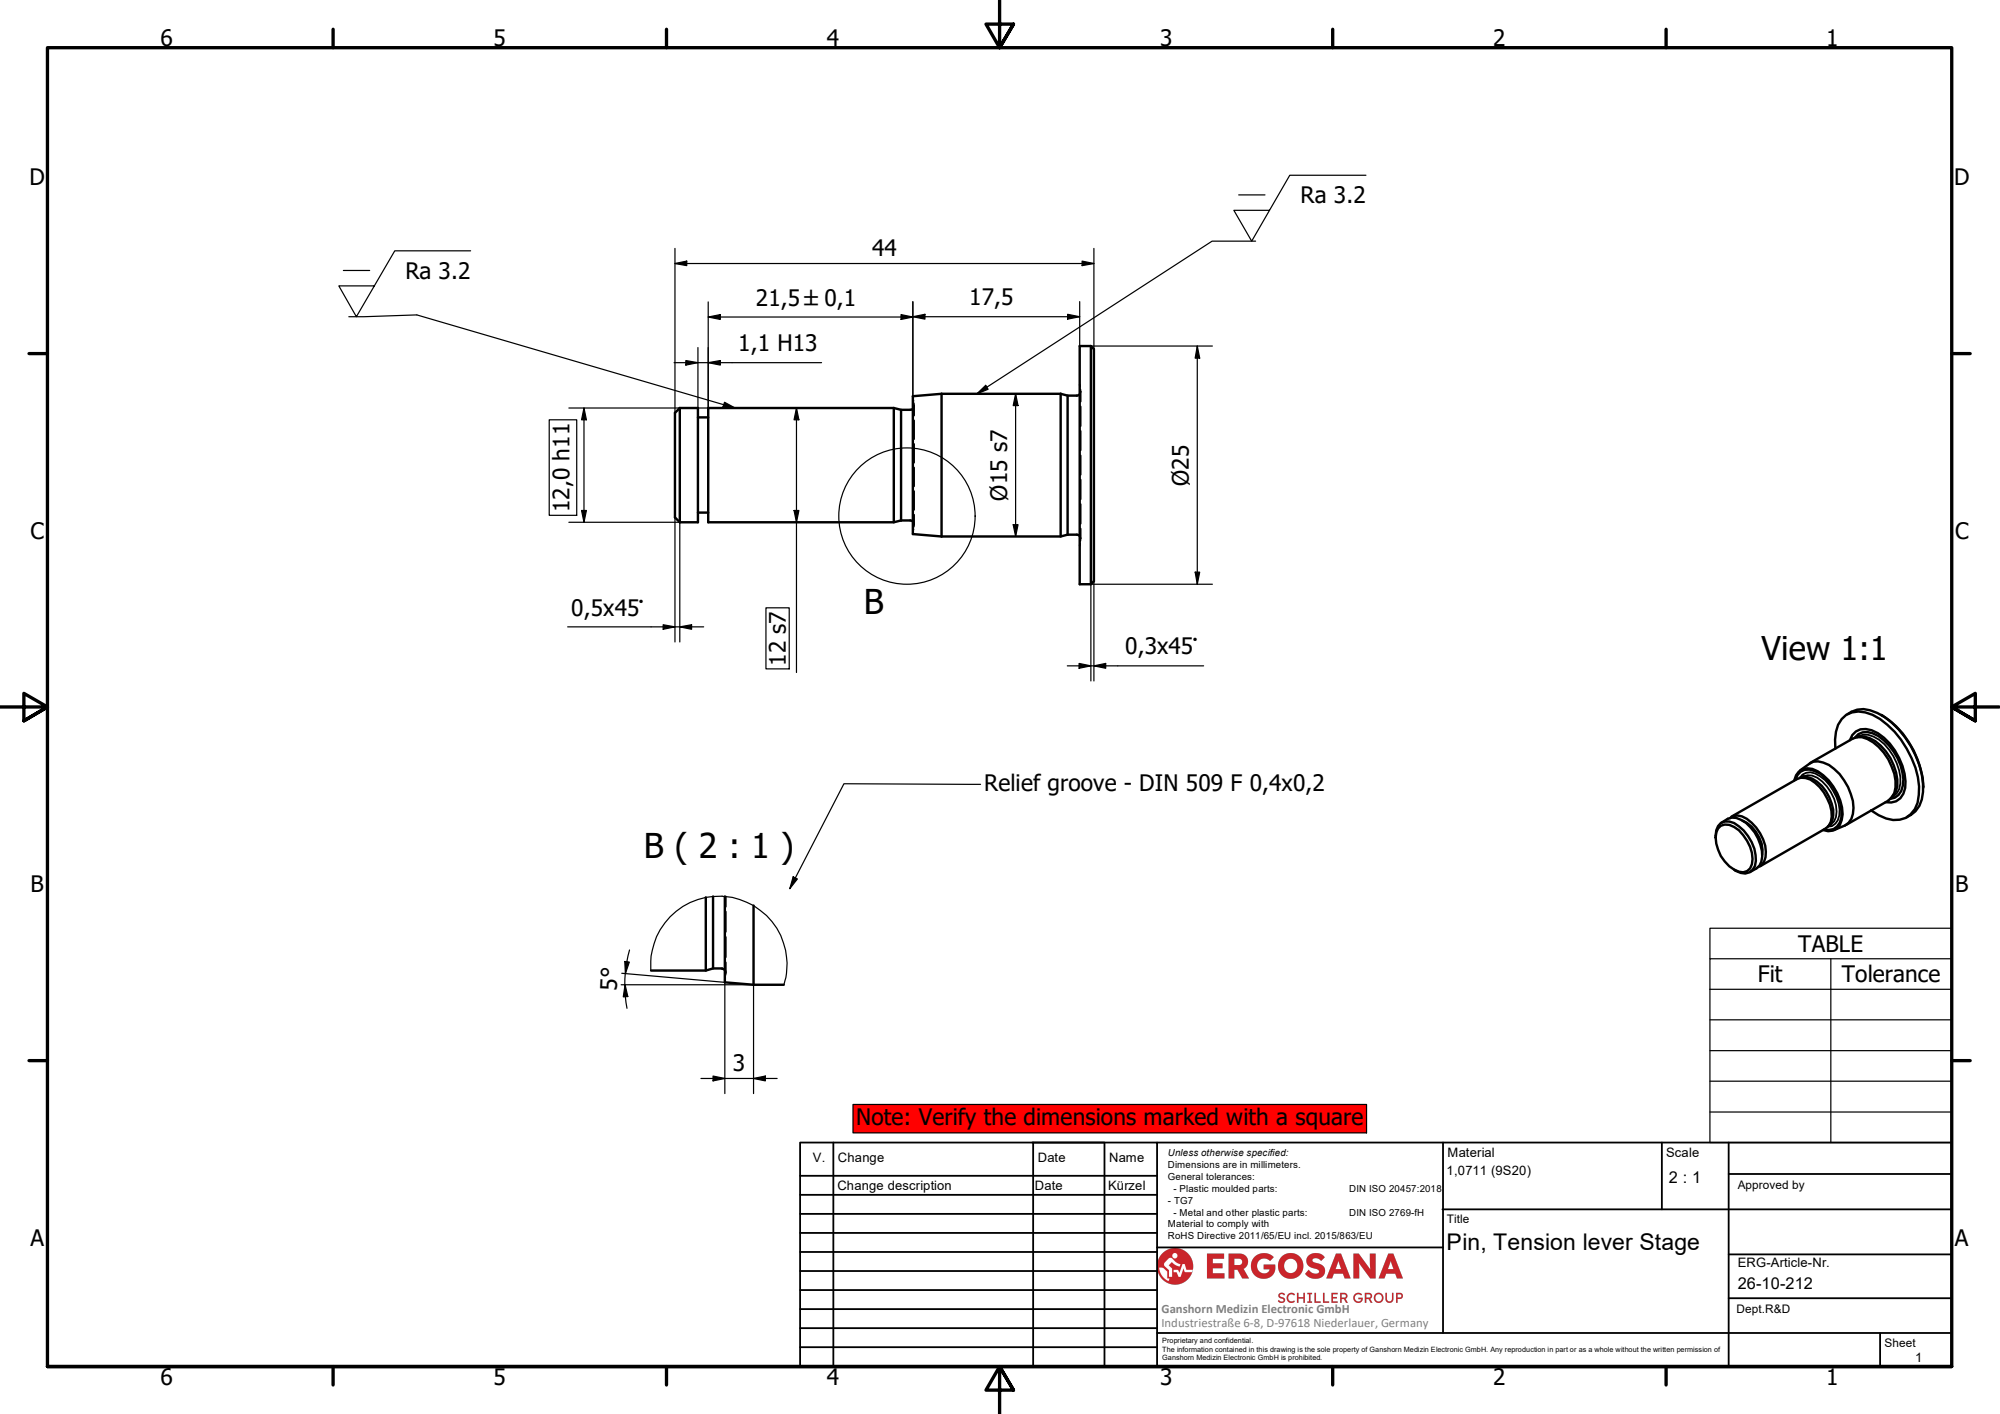
[picture p18: page 1]
View 1:1

Relief groove - DIN 509 F 0,4x0,2

Note: Verify the dimensions marked with a square

V. | Change | Date | Name | Unless otherwise specified: Dimensions are in millimeters. General tolerances: - Plastic moulded parts: DIN ISO 20457:2018 - TG7 - Metal and other plastic parts: DIN ISO 2769-fH Material to comply with RoHS Directive 2011/65/EU incl. 2015/863/EU | Material 1,0711 (9S20) | Scale 2 : 1

Change description | Date | Kürzel | | | | Approved by

Title Pin, Tension lever Stage

ERG-Article-Nr.

Ganshorn Medizin Electronic GmbH
Industriestraße 6-8, D-97618 Niederlauer, Germany

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
