Zvonko2203/Map-from-transfer-folder/Drive Unit/Drive Unit-tehnical Drawing 2025/31-10-201.pdf

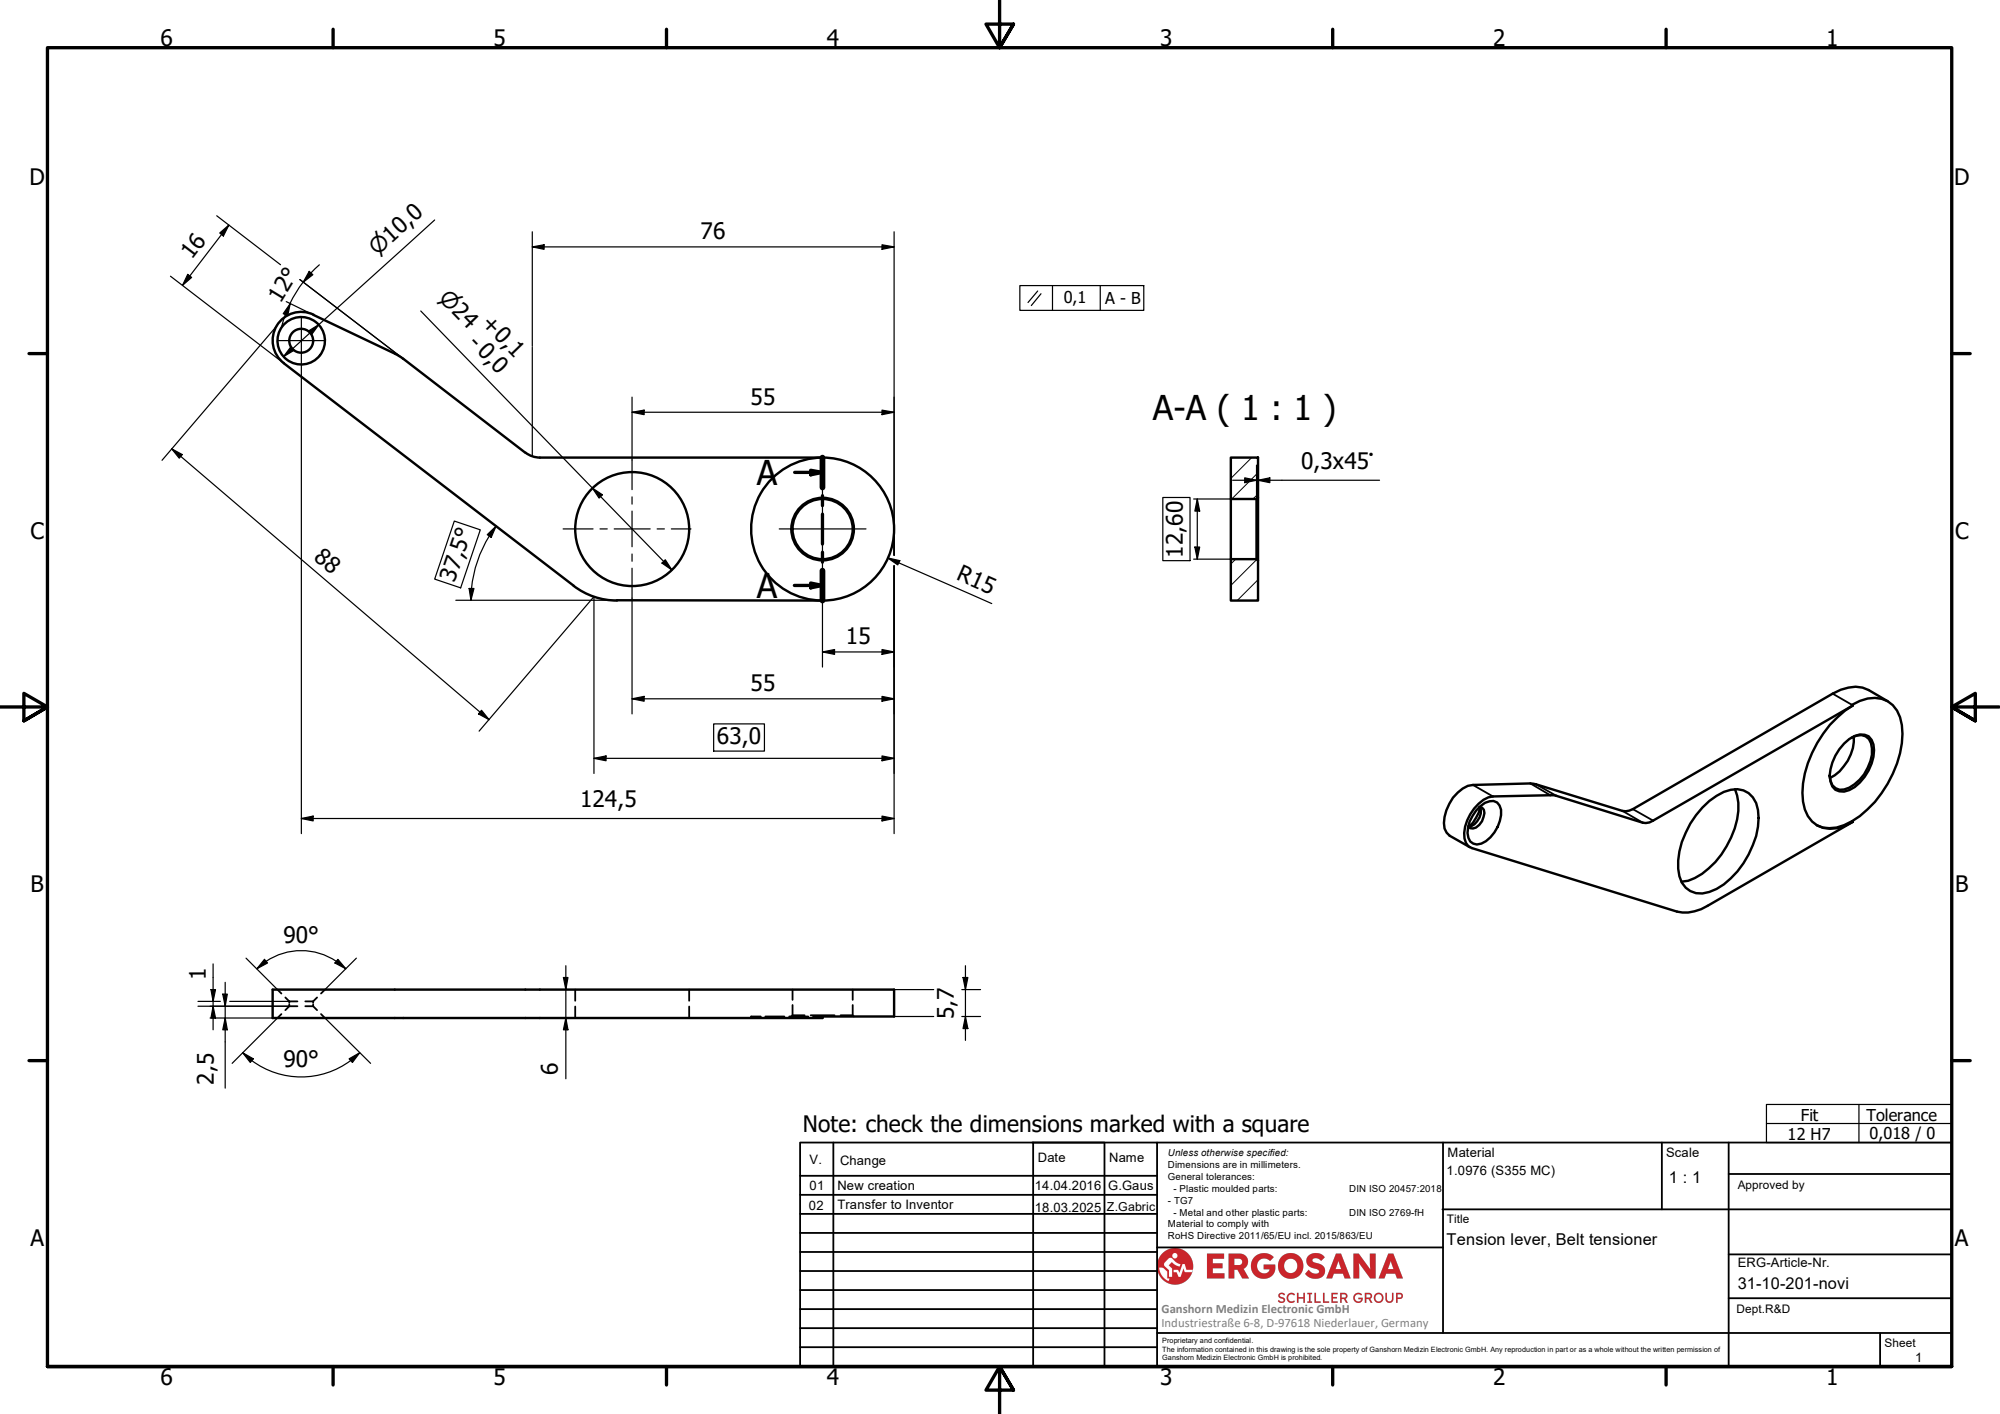
[picture p19: page 1]

Fit | Tolerance
12 H7 | 0,018 / 0

Note: check the dimensions marked with a square

V. | Change | Date | Name | Unless otherwise specified: Dimensions are in millimeters. General tolerances: - Plastic moulded parts: DIN ISO 20457:2018 - TG7 - Metal and other plastic parts: DIN ISO 2769-fH Material to comply with RoHS Directive 2011/65/EU incl. 2015/863/EU | Material 1.0976 (S355 MC) | Scale 1 : 1

01 | New creation | 14.04.2016 | G.Gaus | | | | Approved by
02 | Transfer to Inventor | 18.03.2025 | Z.Gabric

Title Tension lever, Belt tensioner

ERG-Article-Nr.
31-10-201-novi

Ganshorn Medizin Electronic GmbH
Industriestraße 6-8, D-97618 Niederlauer, Germany

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
