Zvonko2203/Map-from-transfer-folder/Drive Unit/Drive Unit-tehnical Drawing 2025/39-10-202.pdf

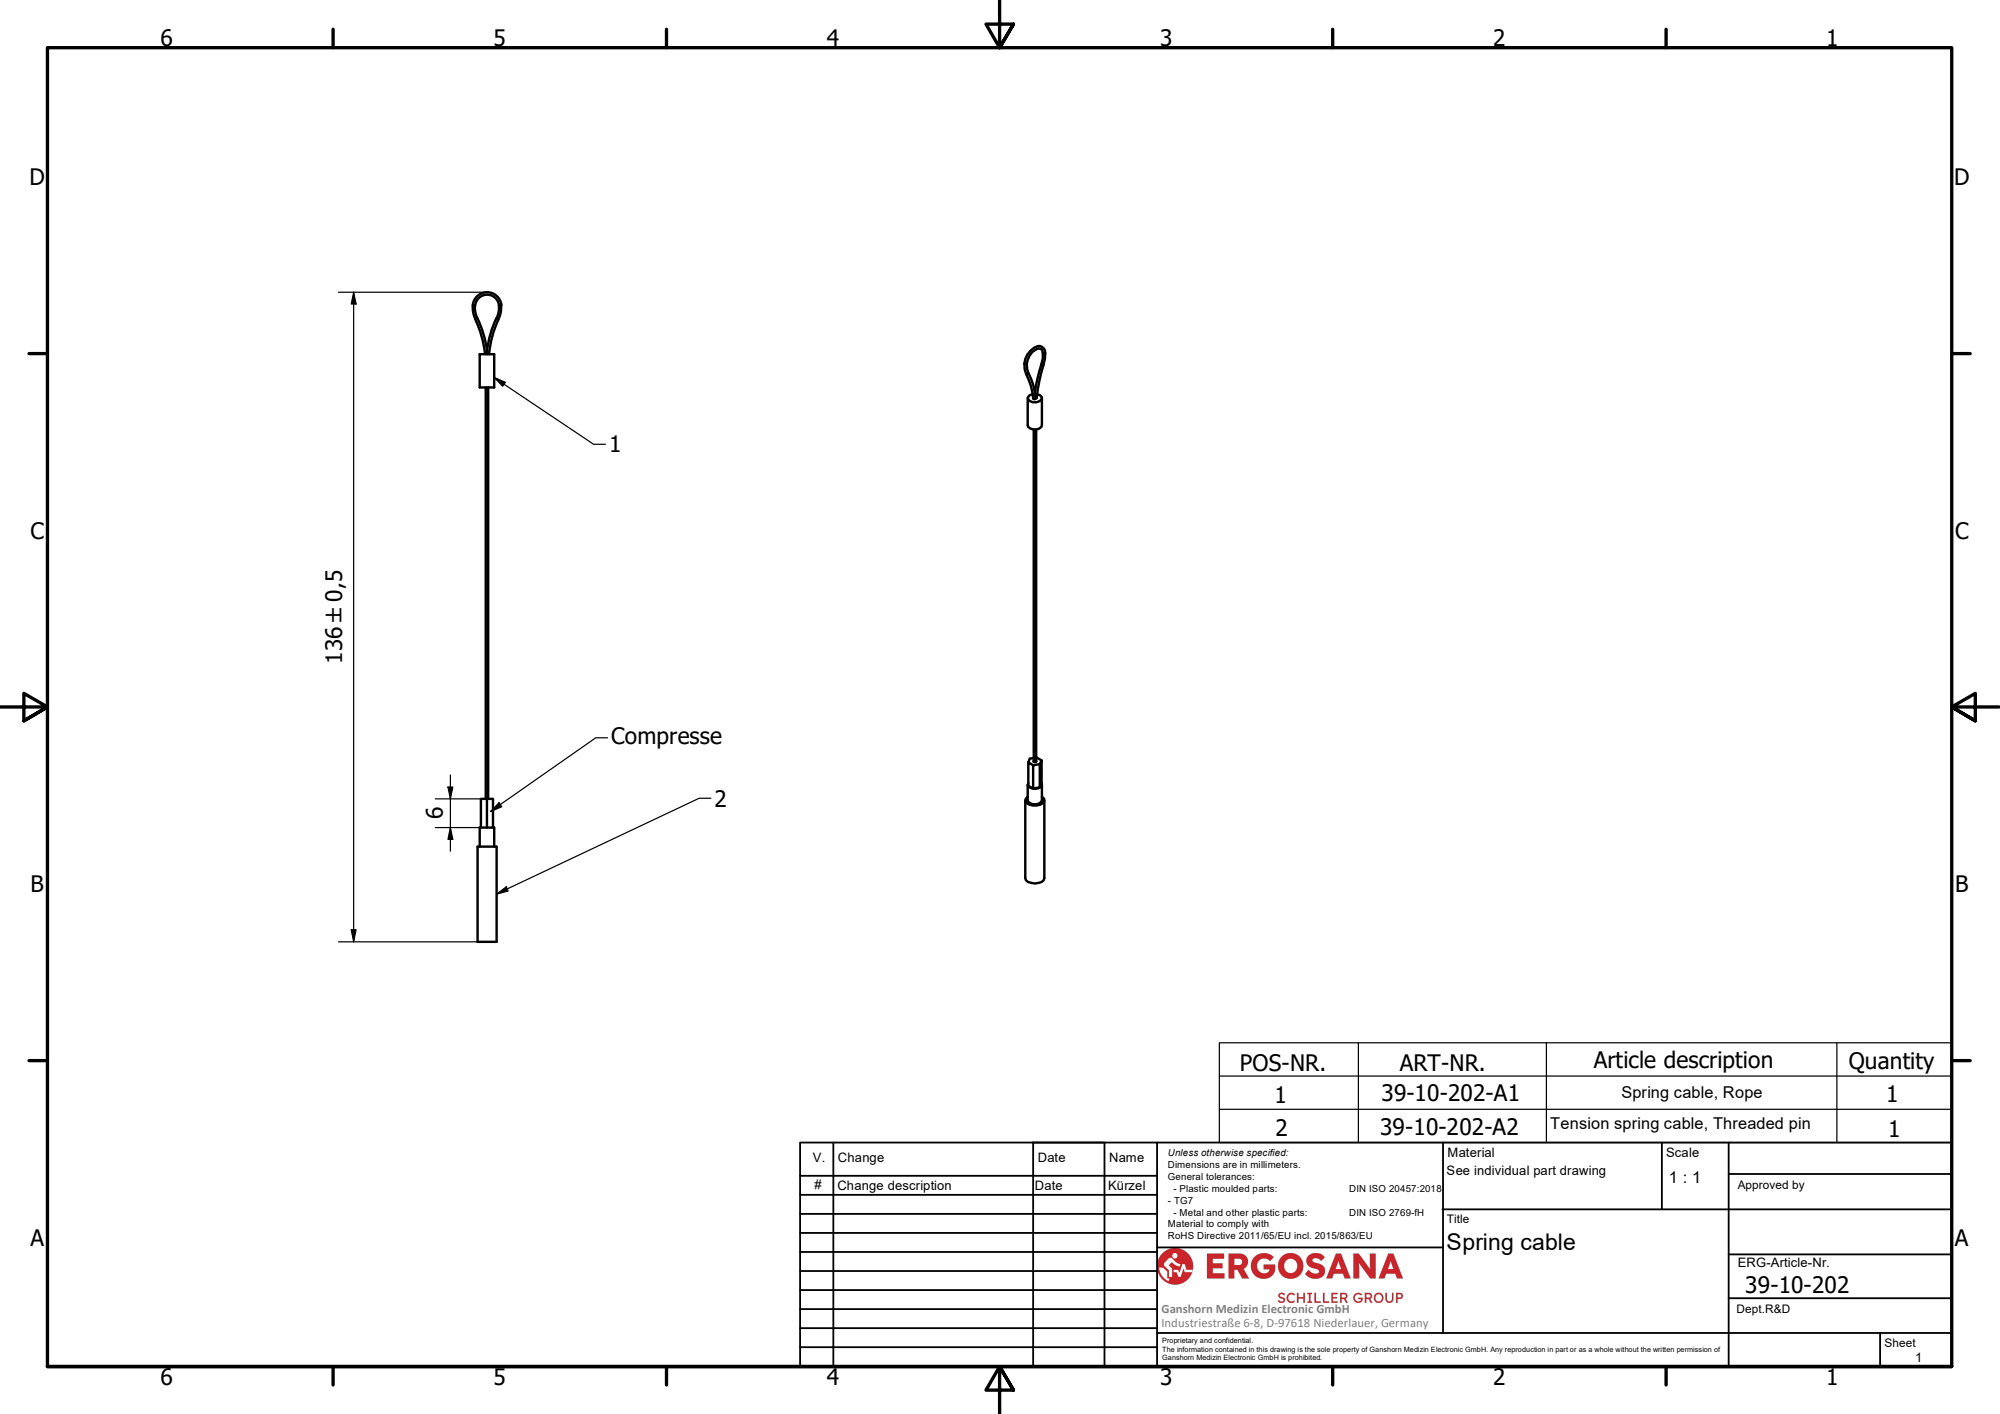
[picture p20: page 1]

POS-NR. | ART-NR. | Article description | Quantity
1 | 39-10-202-A1 | Spring cable, Rope | 1
2 | 39-10-202-A2 | Tension spring cable, Threaded pin | 1

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

# | Change description | Date | Kürzel | | | | Approved by

Title Spring cable

ERG-Article-Nr.

Ganshorn Medizin Electronic GmbH
Industriestraße 6-8, D-97618 Niederlauer, Germany

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
