Zvonko2203/Map-from-transfer-folder/Drive Unit/Drive Unit-tehnical Drawing 2025/59-01-002-A.pdf

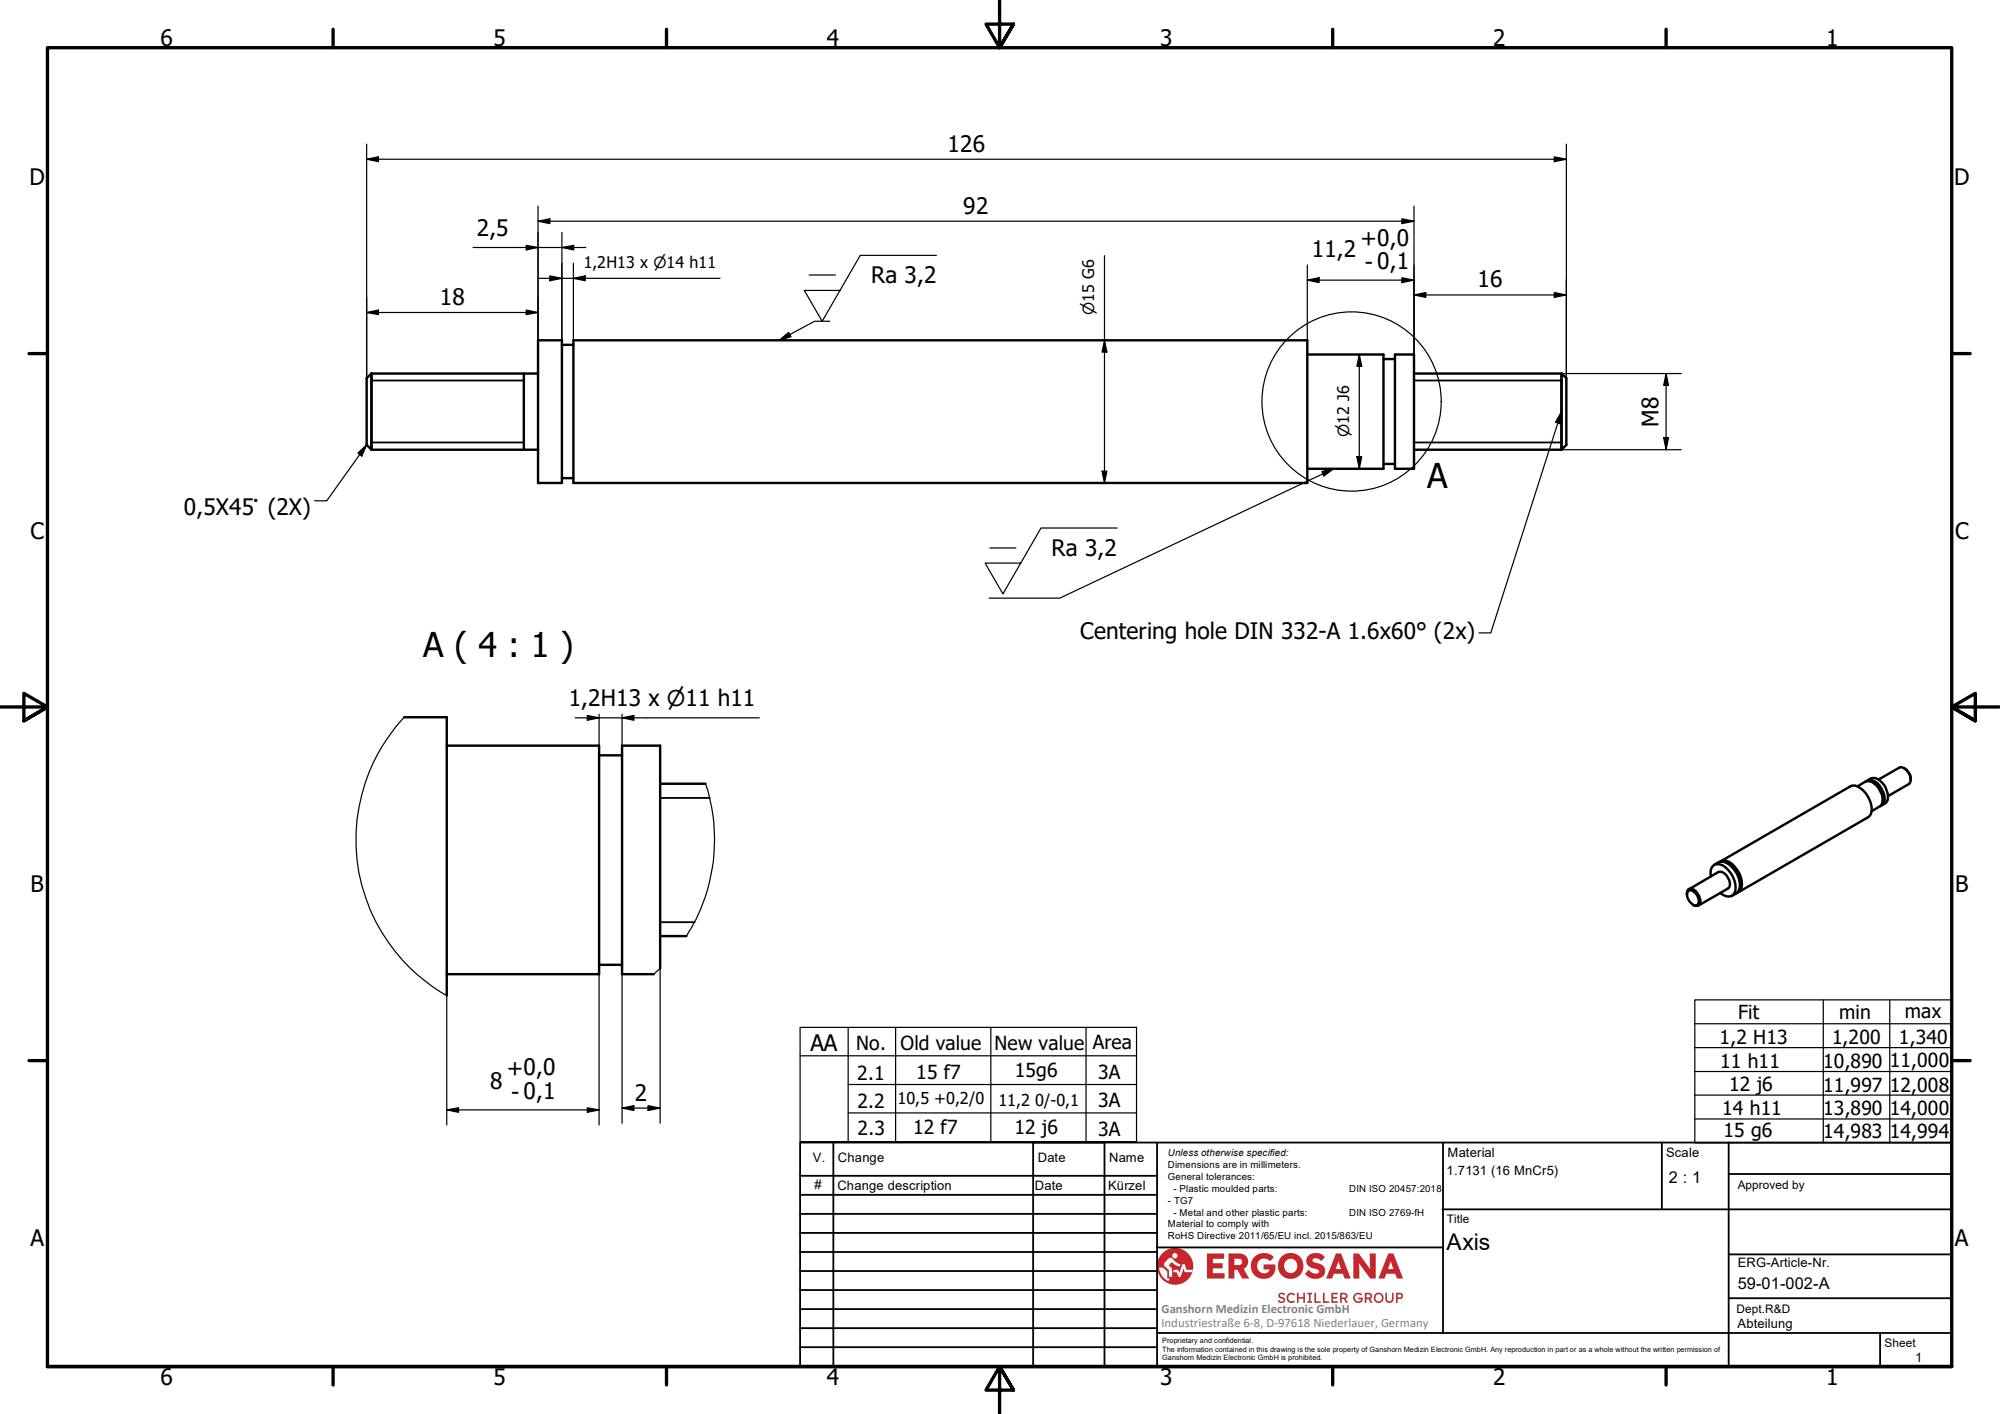
[picture p21: page 1]
Old value; New value; Area

Centering hole DIN 332-A 1.6x60° (2x)

11 h11 | 10,890 | 11,000
12 j6 | 11,997 | 12,008
14 h11 | 13,890 | 14,000
15 g6 | 14,983 | 14,994

2.1 | 15 f7 | 15g6 | 3A
2.2 | 10,5 +0,2/0 | 11,2 0/-0,1 | 3A
2.3 | 12 f7 | 12 j6 | 3A

V. | Change | Date | Name | Unless otherwise specified: Dimensions are in millimeters. General tolerances: - Plastic moulded parts: DIN ISO 20457:2018 - TG7 - Metal and other plastic parts: DIN ISO 2769-fH Material to comply with RoHS Directive 2011/65/EU incl. 2015/863/EU | Material 1.7131 (16 MnCr5) | Scale 2 : 1

# | Change description | Date | Kürzel | | | | Approved by

Title Axis

ERG-Article-Nr.

Ganshorn Medizin Electronic GmbH
Industriestraße 6-8, D-97618 Niederlauer, Germany

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
