Zvonko2203/Map-from-transfer-folder/Drive Unit/Drive Unit-tehnical Drawing 2025/59-01-002-C.pdf

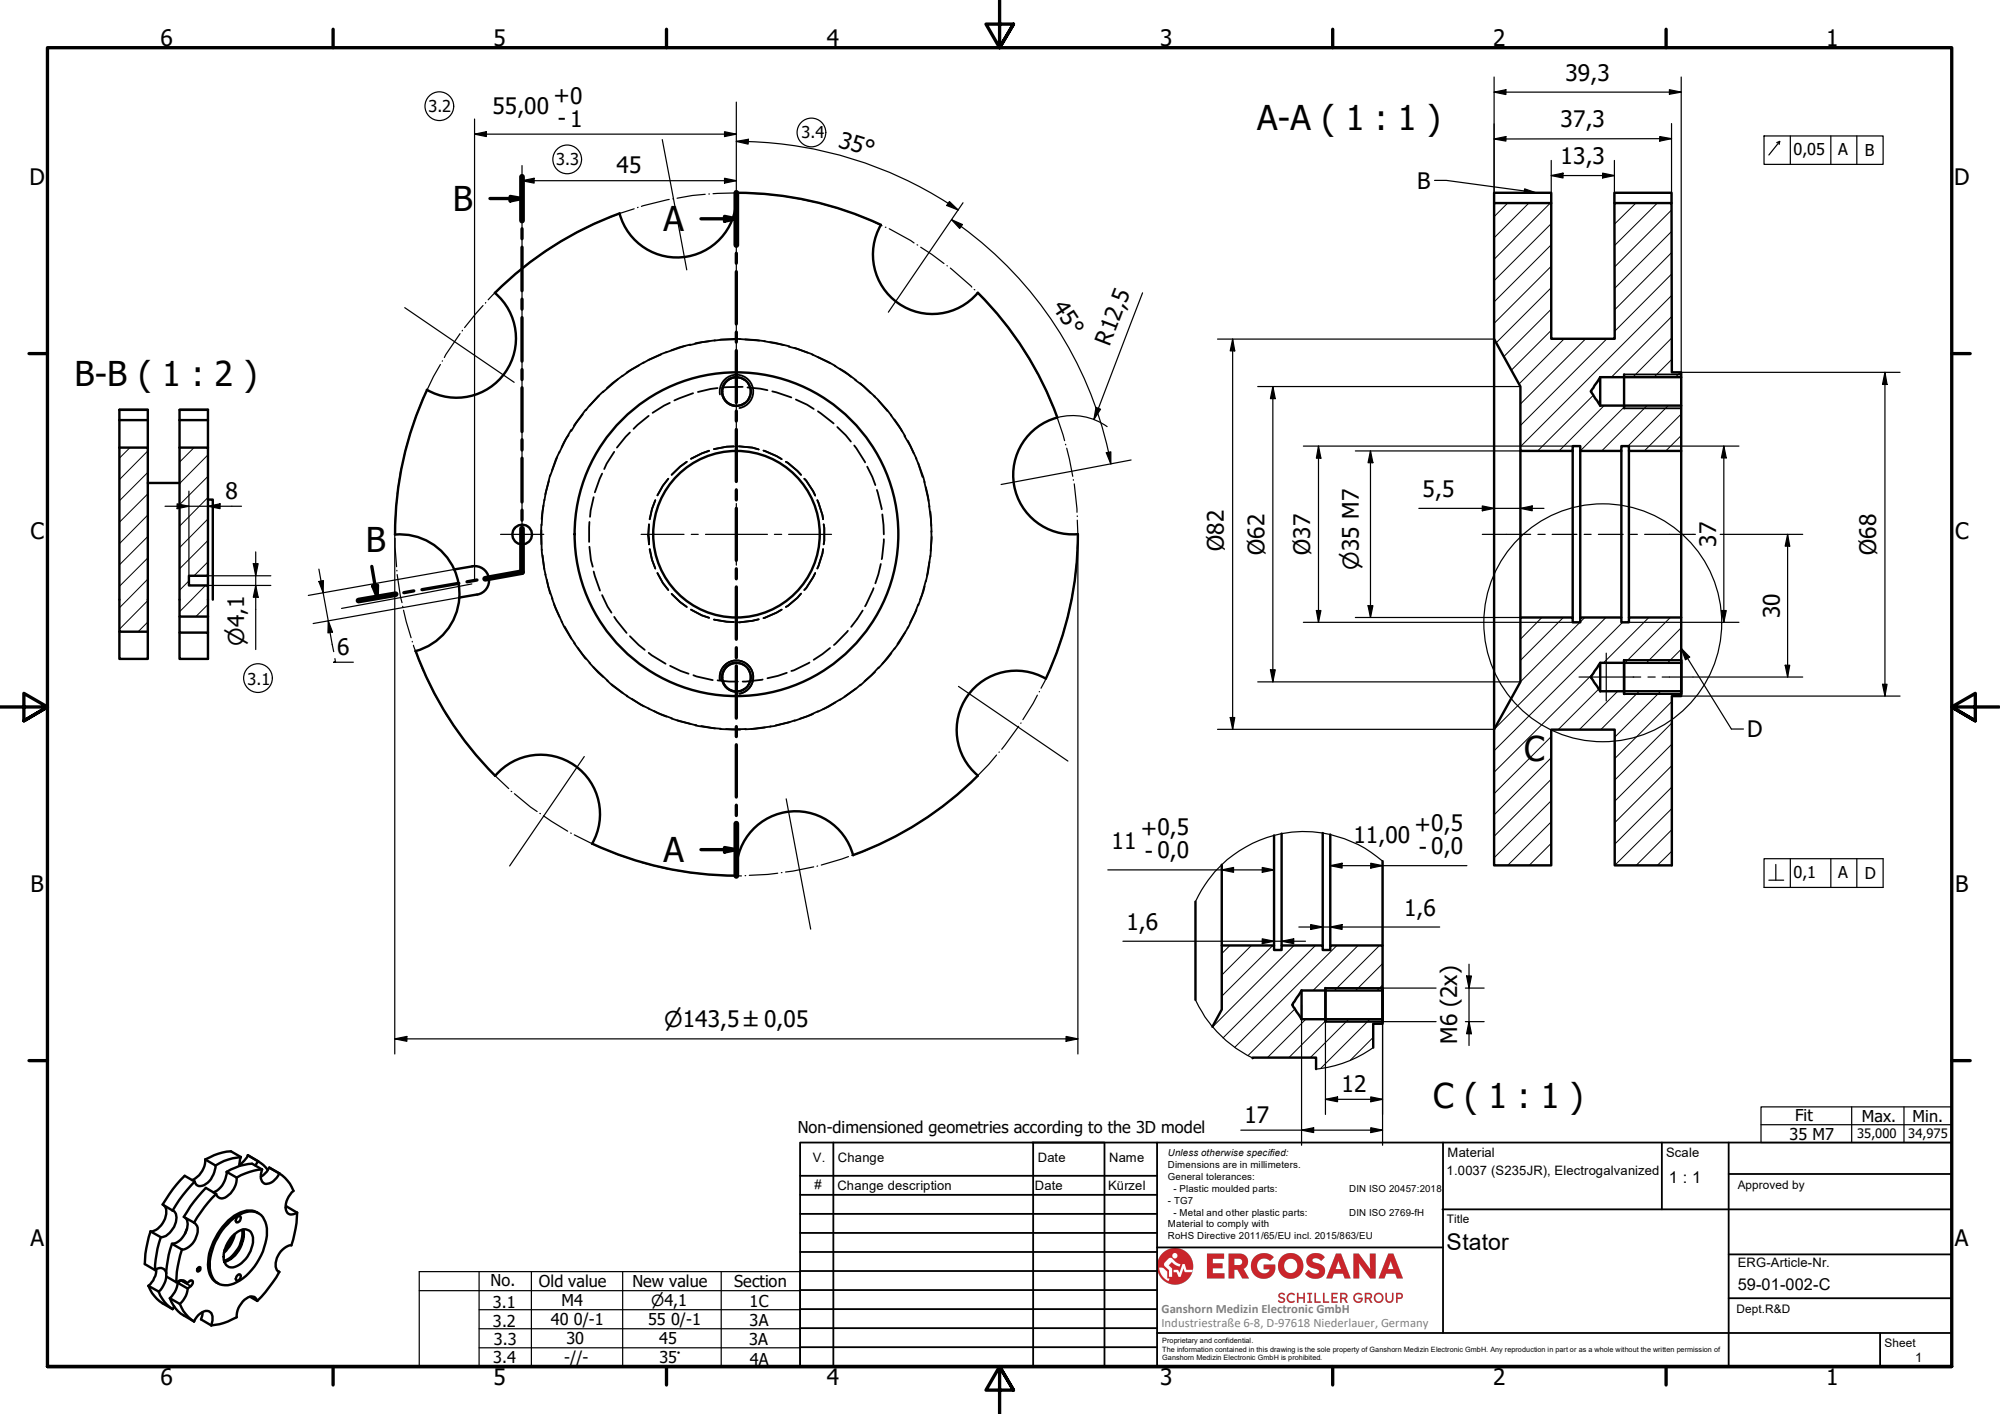
[picture p22: page 1]

Fit | Max. | Min.
35 M7 | 35,000 | 34,975

Non-dimensioned geometries according to the 3D model

V. | Change | Date | Name | Unless otherwise specified: Dimensions are in millimeters. General tolerances: - Plastic moulded parts: DIN ISO 20457:2018 - TG7 - Metal and other plastic parts: DIN ISO 2769-fH Material to comply with RoHS Directive 2011/65/EU incl. 2015/863/EU | Material 1.0037 (S235JR), Electrogalvanized | Scale 1 : 1

# | Change description | Date | Kürzel | | | | Approved by

Title Stator

ERG-Article-Nr.

No. | Old value | New value | Section
3.1 | M4 | ⌀4,1 | 1C
3.2 | 40 0/-1 | 55 0/-1 | 3A
3.3 | 30 | 45 | 3A
3.4 | -//- | 35~ | 4A

Ganshorn Medizin Electronic GmbH
Industriestraße 6-8, D-97618 Niederlauer, Germany

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
