Zvonko2203/Map-from-transfer-folder/SanaBike 1000 E-Sattel/10-30-100 SanaBike 1000 E-Sattel_/21-10-822-A1_ZI01 Rohr, Sattelstange, E-Sattel.pdf

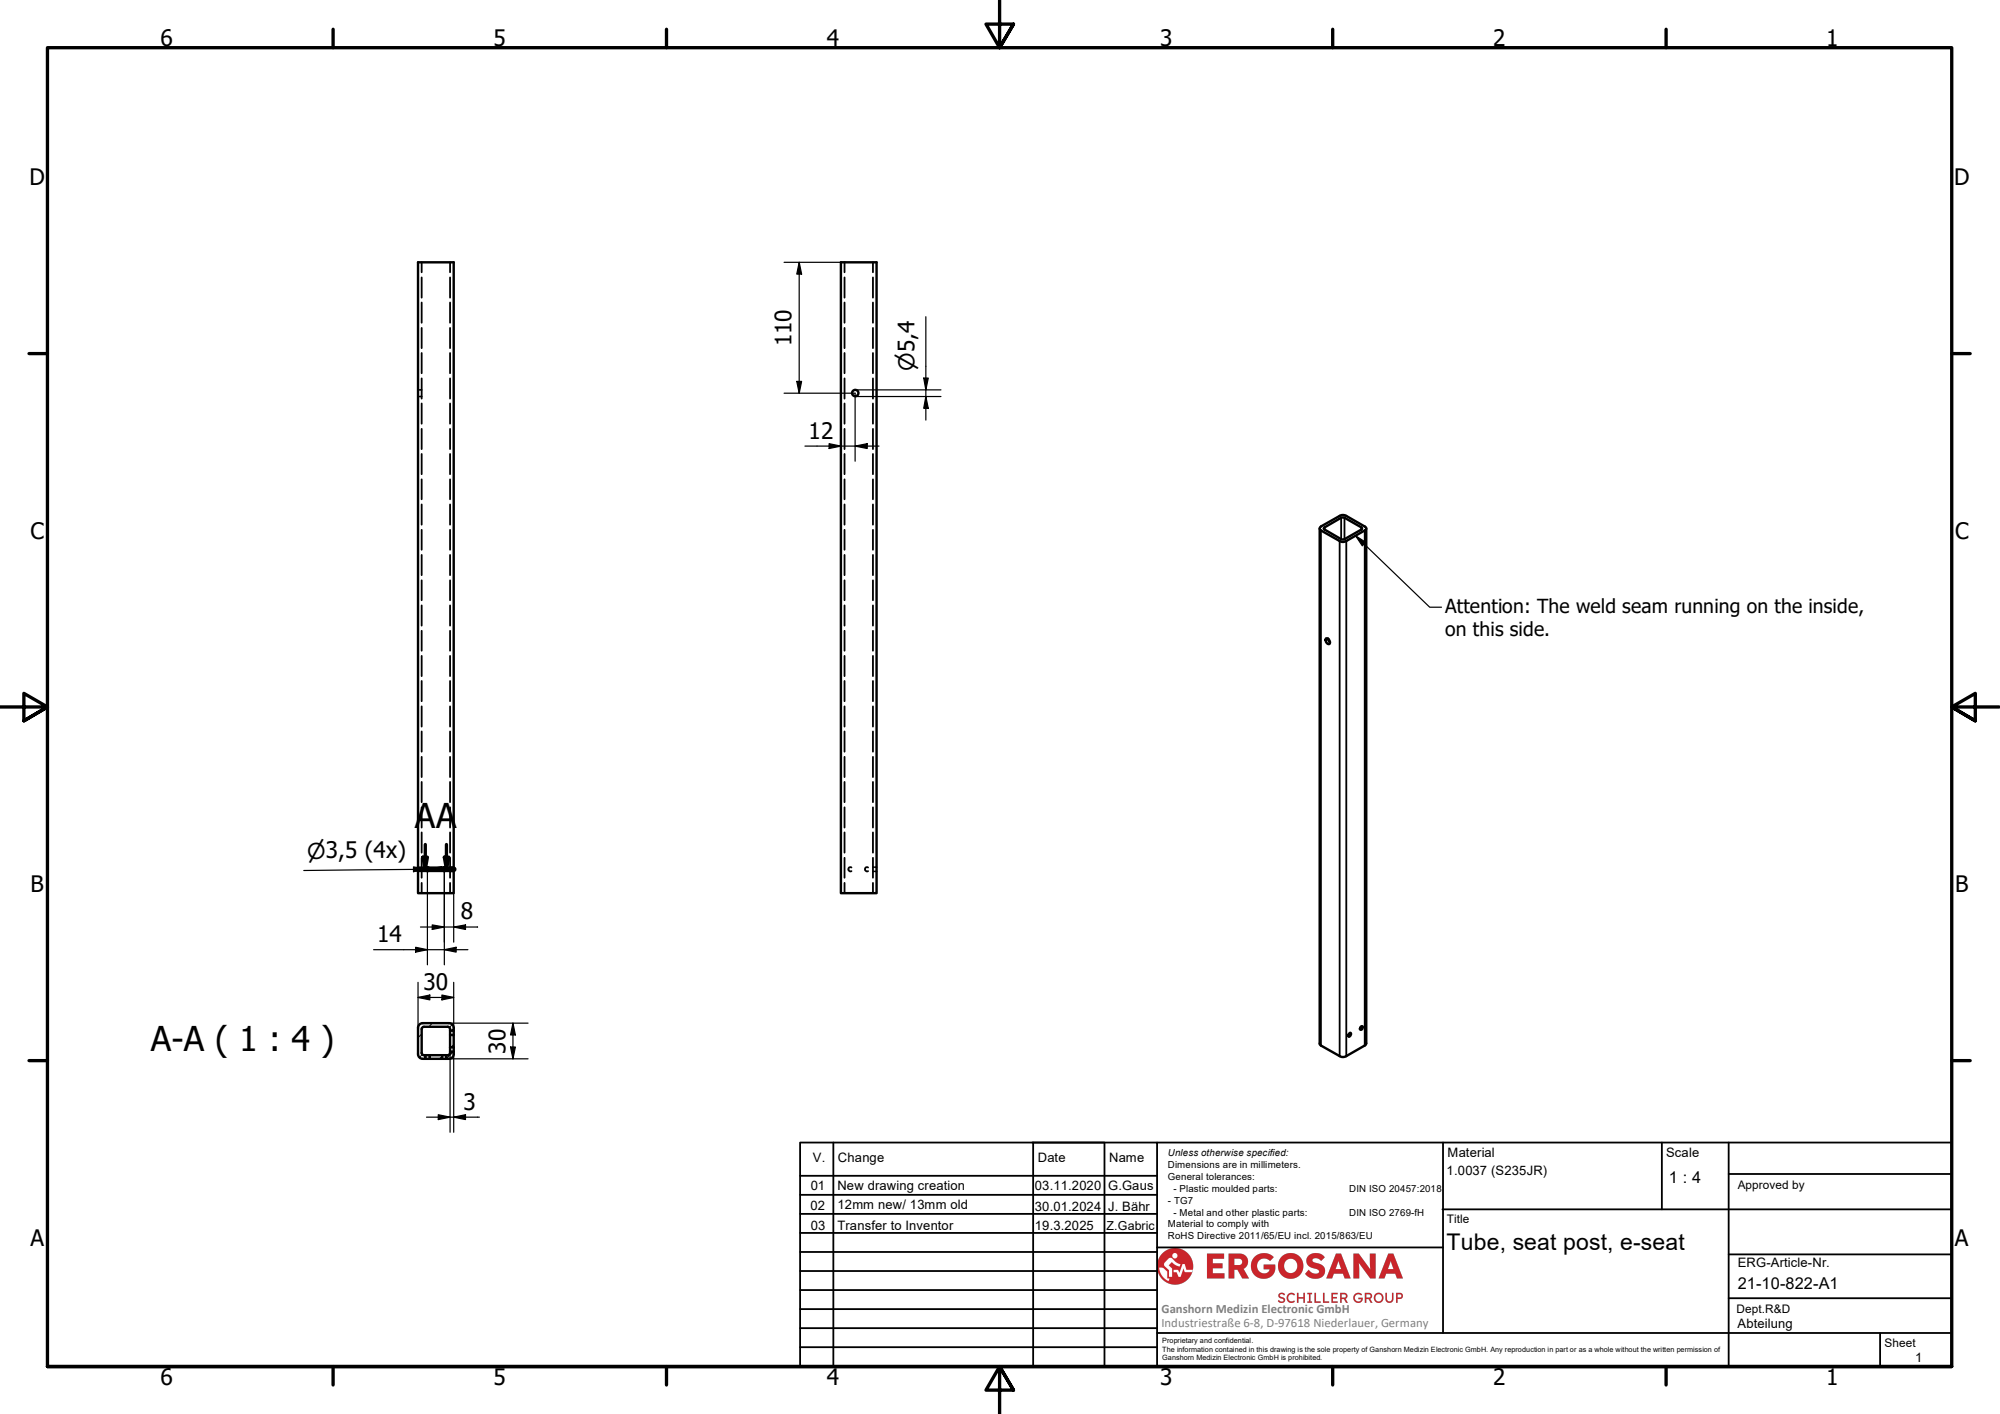
[picture p23: page 1]

Attention: The weld seam running on the inside,
on this side.

V. | Change | Date | Name | Unless otherwise specified: Dimensions are in millimeters. General tolerances: - Plastic moulded parts: DIN ISO 20457:2018 - TG7 - Metal and other plastic parts: DIN ISO 2769-fH Material to comply with RoHS Directive 2011/65/EU incl. 2015/863/EU | Material 1.0037 (S235JR) | Scale 1 : 4

01 | New drawing creation | 03.11.2020 | G.Gaus | | | | Approved by
02 | 12mm new/ 13mm old | 30.01.2024 | J. Bähr
03 | Transfer to Inventor | 19.3.2025 | Z.Gabric

Title Tube, seat post, e-seat

ERG-Article-Nr.

Ganshorn Medizin Electronic GmbH
Industriestraße 6-8, D-97618 Niederlauer, Germany

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
