Zvonko2203/Map-from-transfer-folder/SanaBike 1000 tehnical drawings 2025/Kristijan_comments/20-30-100.pdf

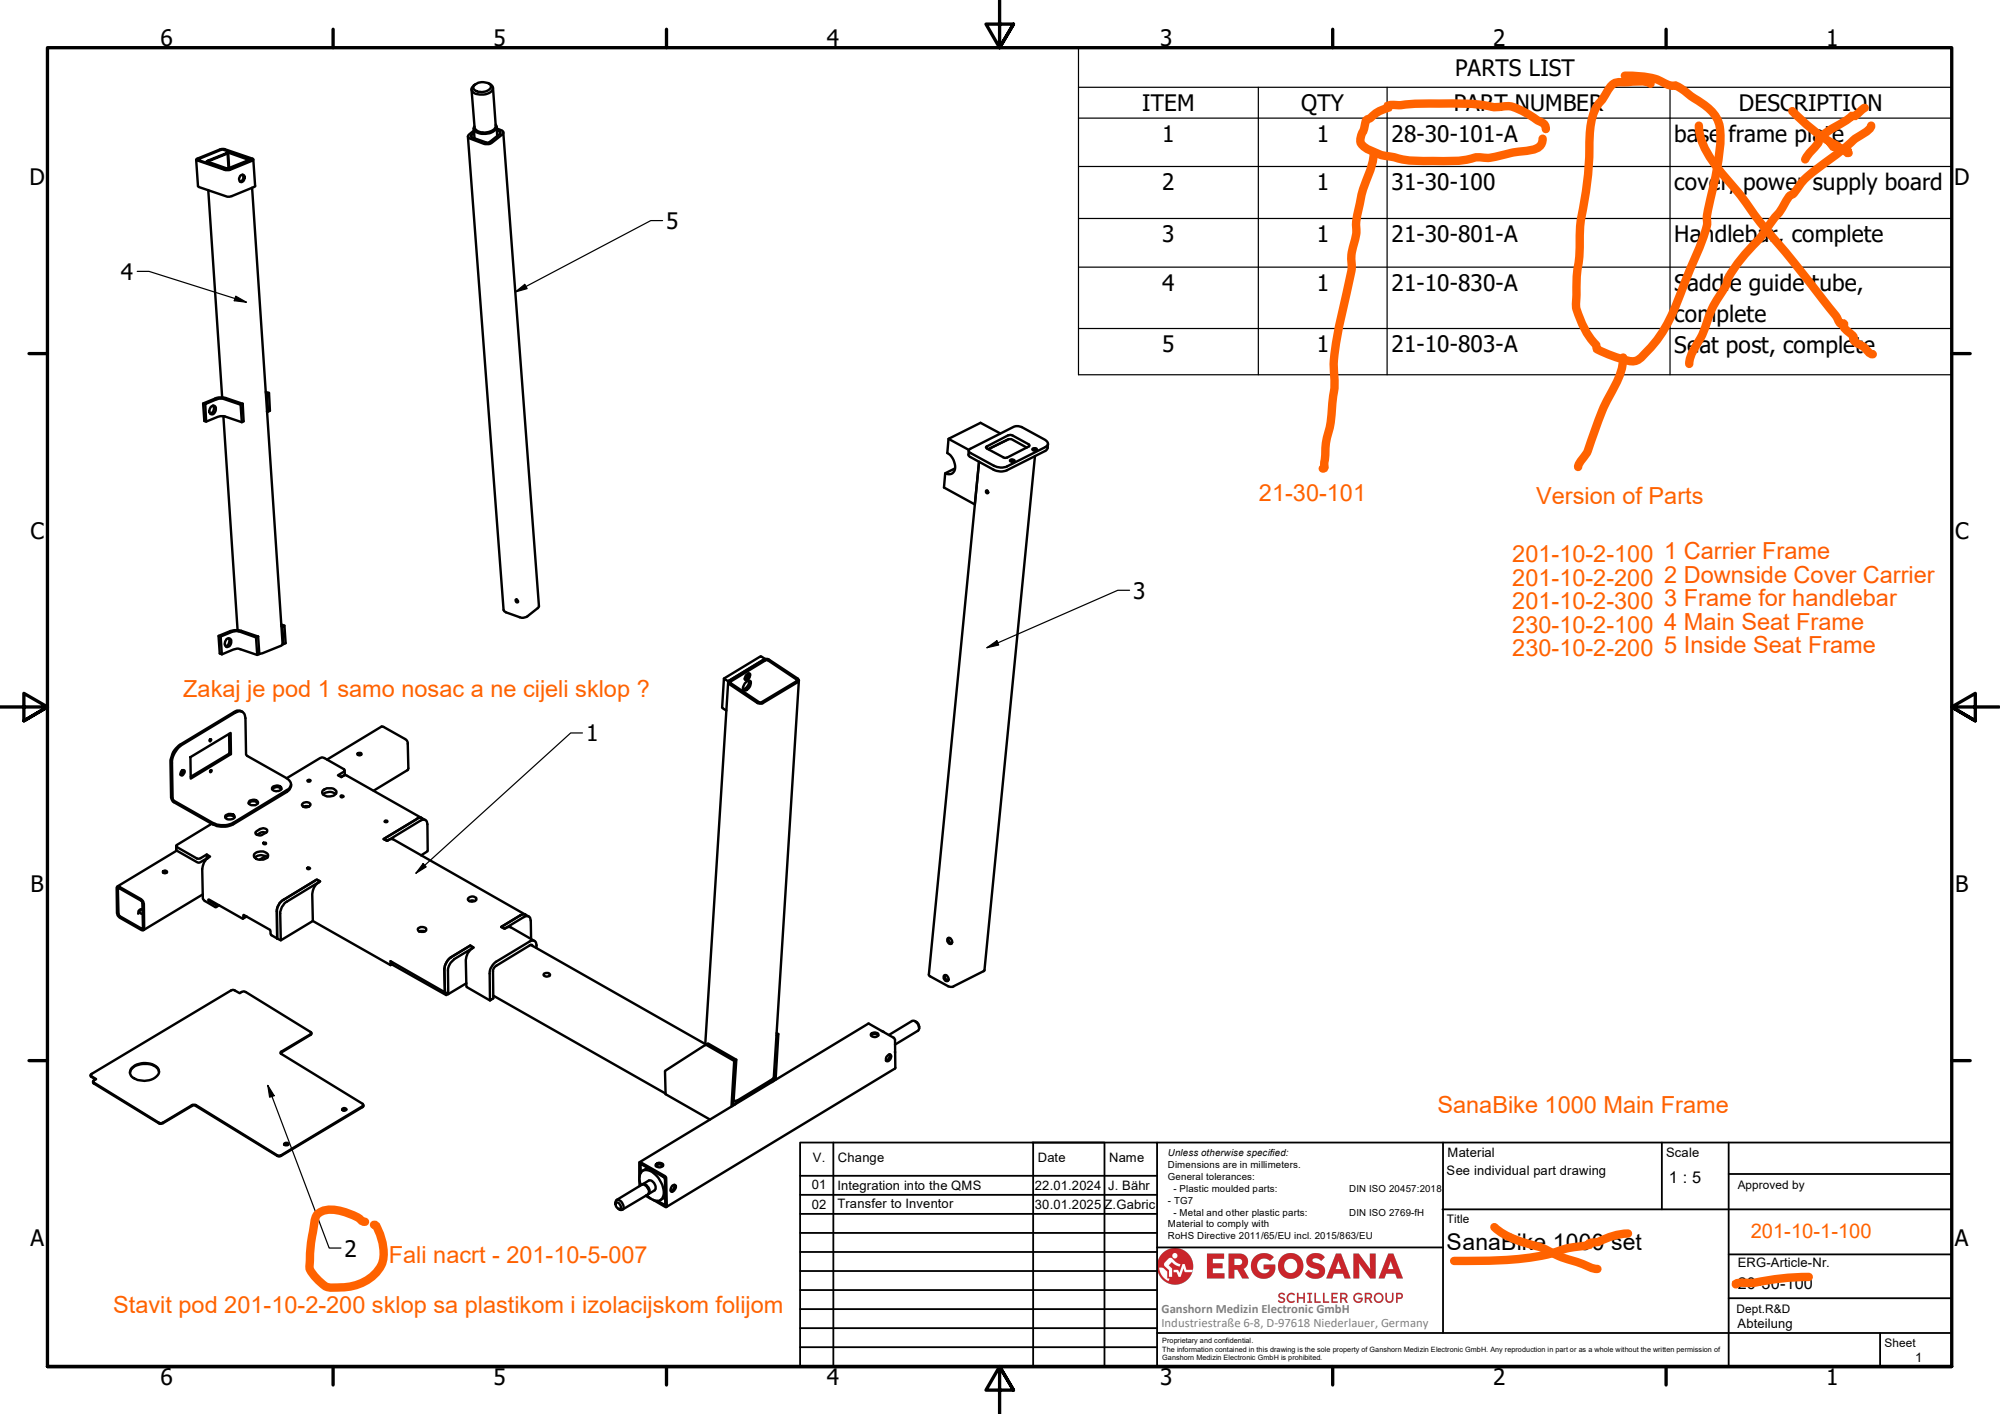
[picture p24: page 1]
PARTS LIST; Version of Parts; Fali nacrt - 201-10-5-007

ITEM | QTY | PART NUMBER | DESCRIPTION
1 | 1 | 28-30-101-A | base frame plate

2 | 1 | 31-30-100 | cover, power supply board

3 | 1 | 21-30-801-A | Handlebar, complete

4 | 1 | 21-10-830-A | Saddle guide tube, complete

5 | 1 | 21-10-803-A | Seat post, complete

1 Carrier Frame
2 Downside Cover Carrier
3 Frame for handlebar
4 Main Seat Frame
5 Inside Seat Frame

Zakaj je pod 1 samo nosac a ne cijeli sklop ?

SanaBike 1000 Main Frame

V. | Change | Date | Name | Unless otherwise specified: Dimensions are in millimeters. General tolerances: - Plastic moulded parts: DIN ISO 20457:2018 - TG7 - Metal and other plastic parts: DIN ISO 2769-fH Material to comply with RoHS Directive 2011/65/EU incl. 2015/863/EU | Material See individual part drawing | Scale 1 : 5

01 | Integration into the QMS | 22.01.2024 | J. Bähr | | | | Approved by
02 | Transfer to Inventor | 30.01.2025 Z.Gabric

Title SanaBike 1000 set | | 201-10-1-100

Stavit pod 201-10-2-200 sklop sa plastikom i izolacijskom folijom

ERG-Article-Nr.

Ganshorn Medizin Electronic GmbH
Industriestraße 6-8, D-97618 Niederlauer, Germany

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
