Zvonko2203/Map-from-transfer-folder/SanaBike 1000 tehnical drawings 2025/Kristijan_comments/21-10-803-A.pdf

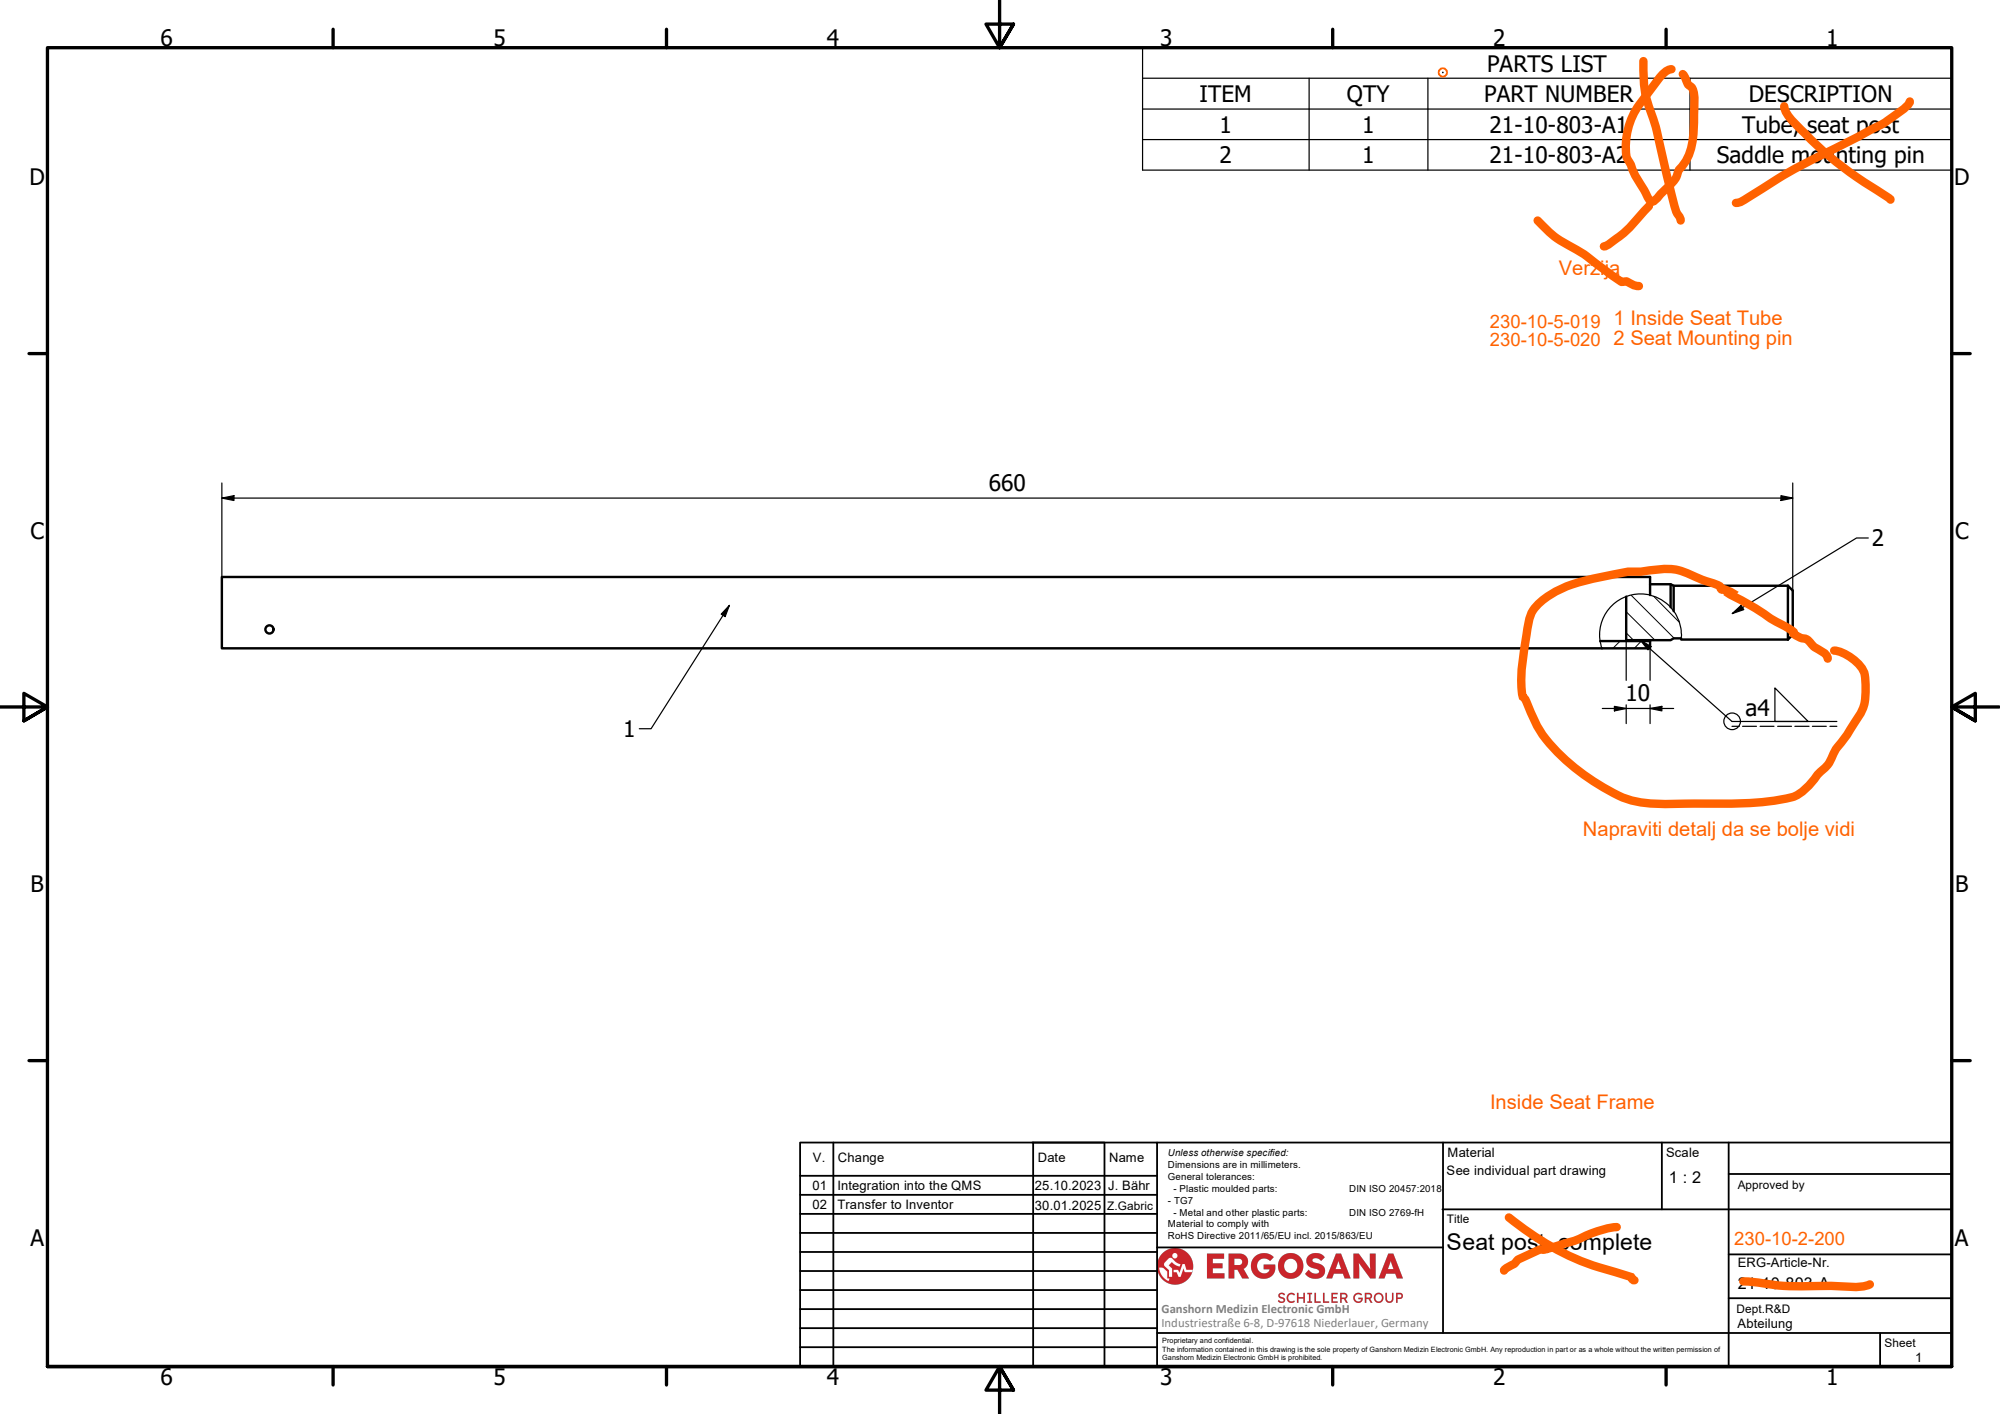
[picture p25: page 1]

PARTS LIST

ITEM | QTY | PART NUMBER | DESCRIPTION
1 | 1 | 21-10-803-A1 | Tube, seat post
2 | 1 | 21-10-803-A2 | Saddle mounting pin

Verzija
1 Inside Seat Tube
2 Seat Mounting pin

Napraviti detalj da se bolje vidi

Inside Seat Frame

V. | Change | Date | Name | Unless otherwise specified: Dimensions are in millimeters. General tolerances: - Plastic moulded parts: DIN ISO 20457:2018 - TG7 - Metal and other plastic parts: DIN ISO 2769-fH Material to comply with RoHS Directive 2011/65/EU incl. 2015/863/EU | Material See individual part drawing | Scale 1 : 2

01 | Integration into the QMS | 25.10.2023 | J. Bähr | | | | Approved by
02 | Transfer to Inventor | 30.01.2025 | Z.Gabric

Title Seat post, complete | | 230-10-2-200

ERG-Article-Nr.

Ganshorn Medizin Electronic GmbH
Industriestraße 6-8, D-97618 Niederlauer, Germany

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
