Zvonko2203/Map-from-transfer-folder/SanaBike 1000 tehnical drawings 2025/Kristijan_comments/21-10-803-A2.pdf

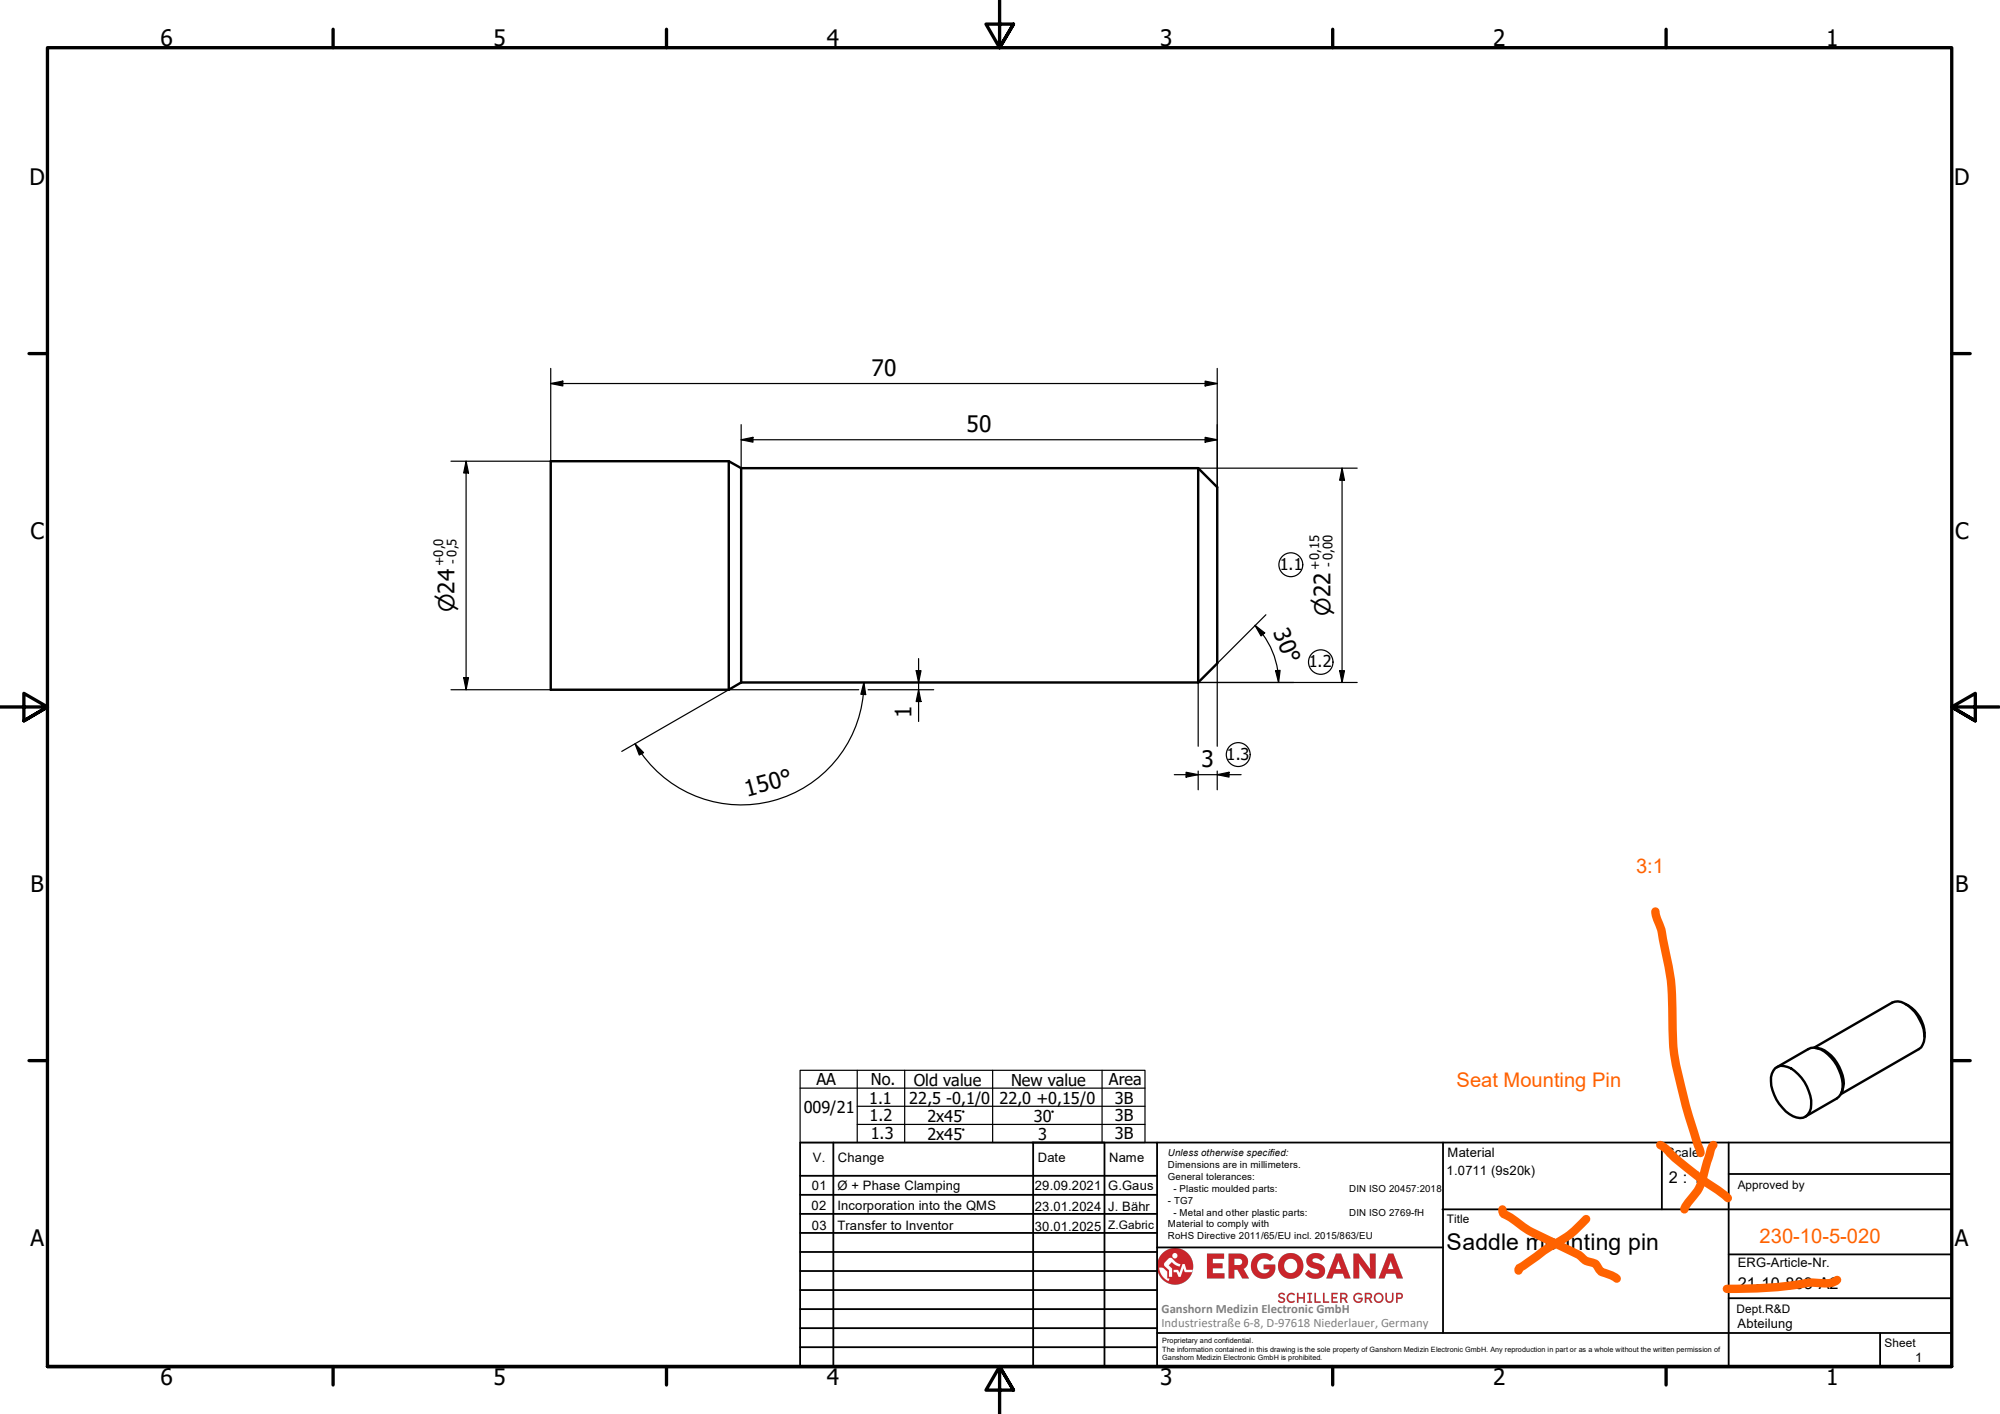
[picture p26: page 1]

Seat Mounting Pin

AA | No. | Old value | New value | Area
009/21 | 1.1 | 22,5 -0,1/0 | 22,0 +0,15/0 | 3B

1.2 | 2x45~ | 30~ | 3B
1.3 | 2x45~ | 3 | 3B

V. | Change | Date | Name | Unless otherwise specified: Dimensions are in millimeters. General tolerances: - Plastic moulded parts: DIN ISO 20457:2018 - TG7 - Metal and other plastic parts: DIN ISO 2769-fH Material to comply with RoHS Directive 2011/65/EU incl. 2015/863/EU | Material 1.0711 (9s20k) | Scale 2 : 1

01 | Ø + Phase Clamping | 29.09.2021 | G.Gaus | | | | Approved by
02 | Incorporation into the QMS | 23.01.2024 | J. Bähr
03 | Transfer to Inventor | 30.01.2025 | Z.Gabric

Title Saddle mounting pin | | 230-10-5-020

ERG-Article-Nr.

Ganshorn Medizin Electronic GmbH
Industriestraße 6-8, D-97618 Niederlauer, Germany

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
