Zvonko2203/Map-from-transfer-folder/SanaBike 1000 tehnical drawings 2025/Kristijan_comments/21-10-830-A.pdf

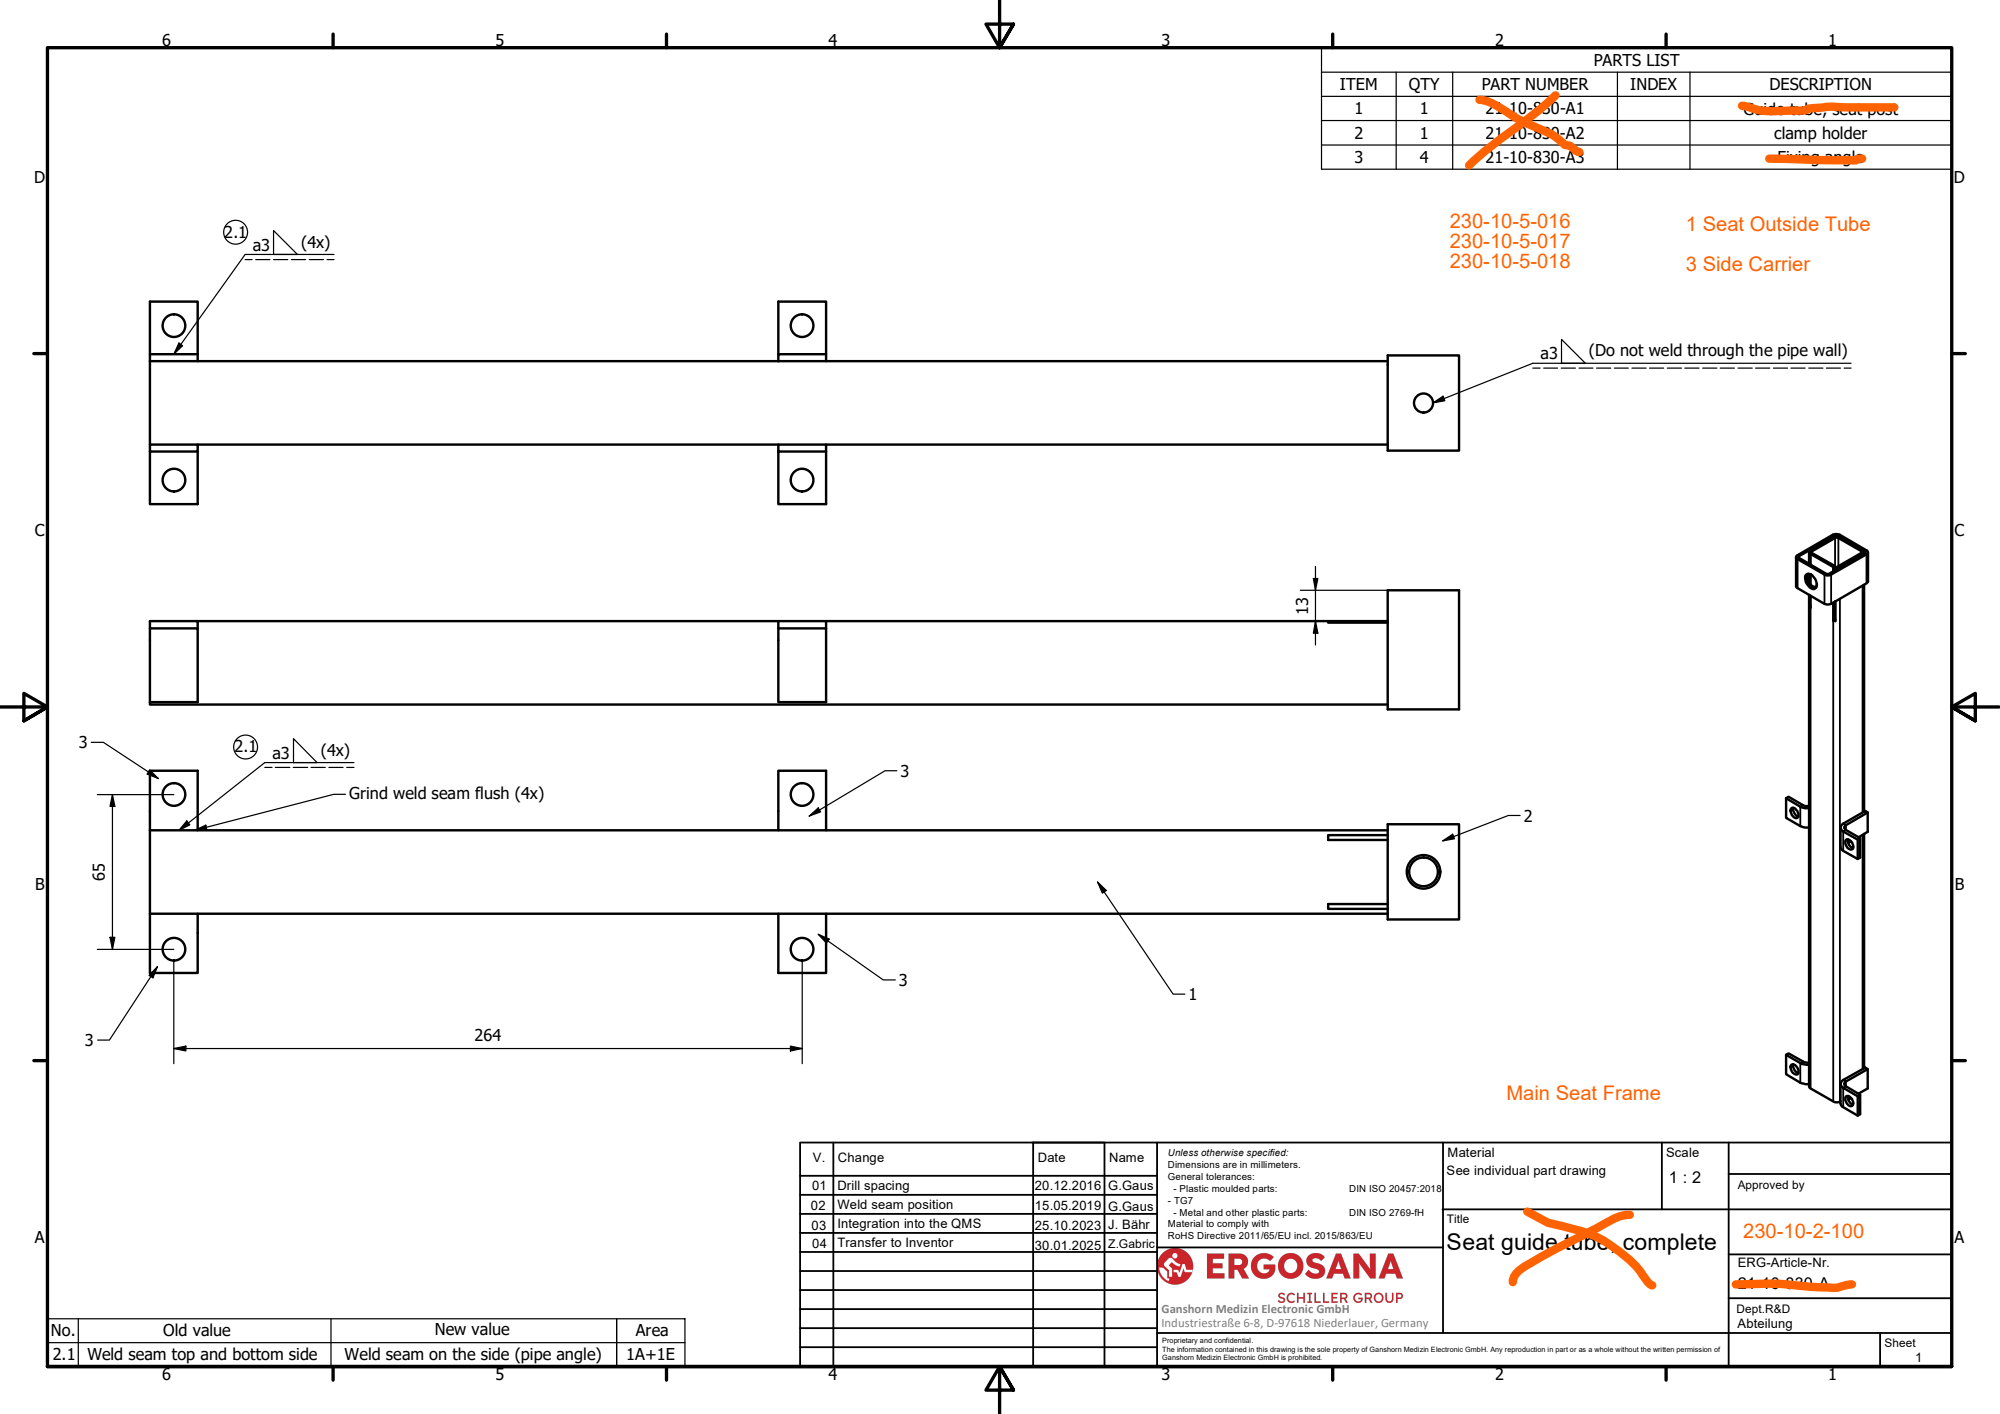
[picture p27: page 1]
(Do not weld through the pipe wall)

2.1 a3 (4x) | PARTS LIST

ITEM | QTY | PART NUMBER | INDEX | DESCRIPTION
11 | 21-10-830-A1 | | Guide tube, seat post
2 | 1 | 21-10-830-A2 | | clamp holder
43 | 21-10-830-A3 | | Fixing angle

1 Seat Outside Tube
3 Side Carrier

Grind weld seam flush (4x)

Main Seat Frame

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

01 | Drill spacing | 20.12.2016 | G.Gaus | | | | Approved by
02 | Weld seam position | 15.05.2019 | G.Gaus
03 | Integration into the QMS | 25.10.2023 | J. Bähr
04 | Transfer to Inventor | 30.01.2025 | Z.Gabric

Title Seat guide tube, complete | | 230-10-2-100

ERG-Article-Nr.

Ganshorn Medizin Electronic GmbH
Industriestraße 6-8, D-97618 Niederlauer, Germany

No. | Old value | New value | Area
2.1 | Weld seam top and bottom side | Weld seam on the side (pipe angle) | 1A+1E

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
