Zvonko2203/Map-from-transfer-folder/SanaBike 1000 tehnical drawings 2025/Kristijan_comments/21-30-101-A2.pdf

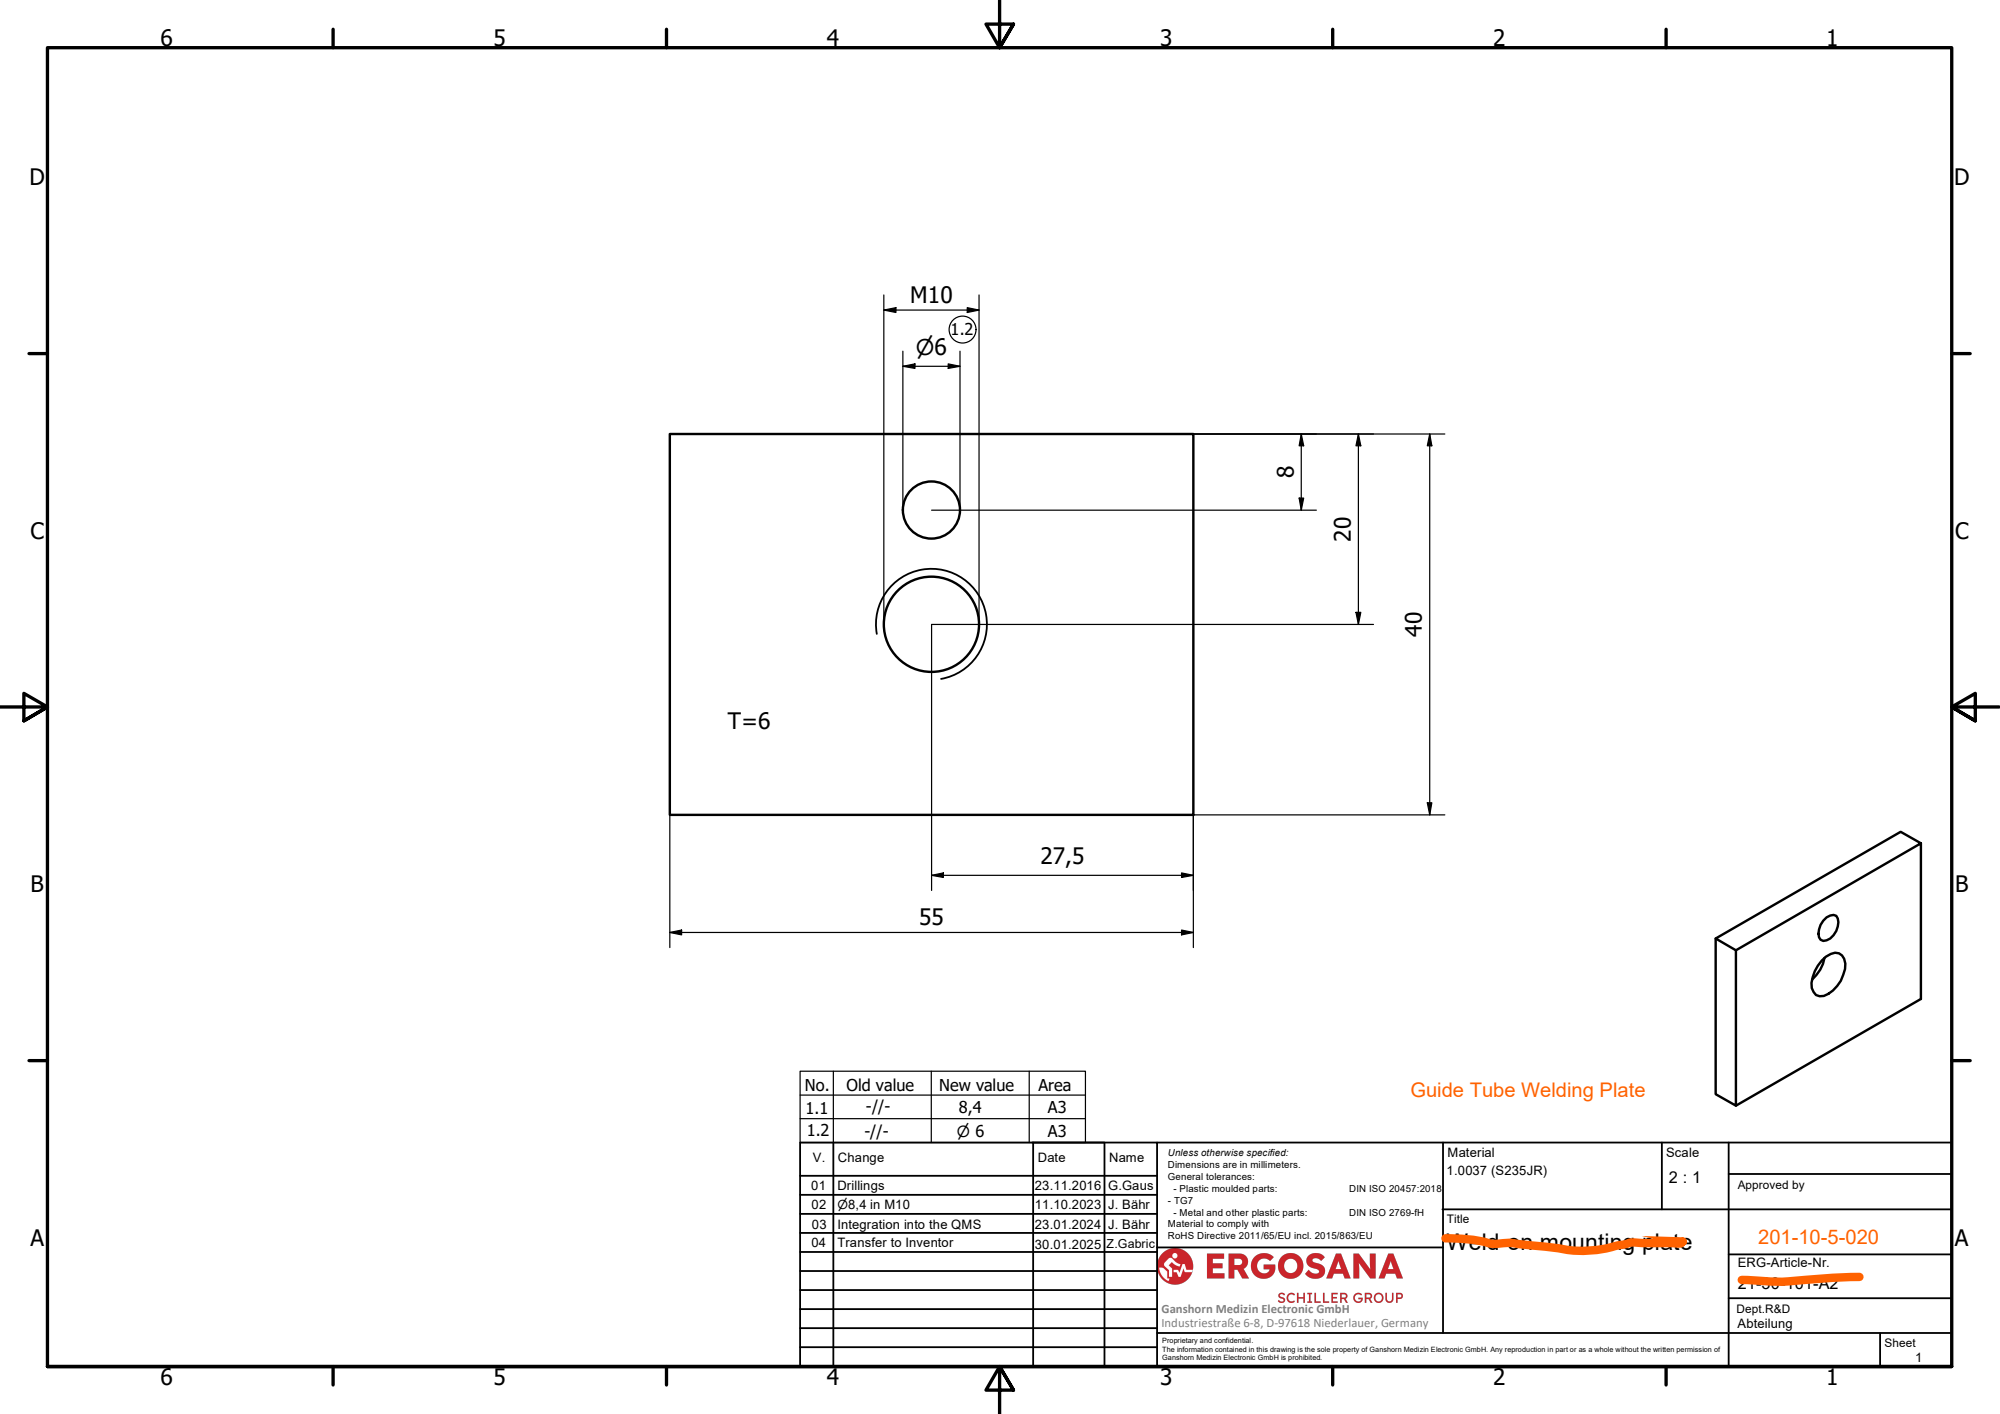
[picture p28: page 1]

No. | Old value | New value | Area
1.1 | -//- | 8,4 | A3
1.2 | -//- | ⌀ 6 | A3

Guide Tube Welding Plate

V. | Change | Date | Name | Unless otherwise specified: Dimensions are in millimeters. General tolerances: - Plastic moulded parts: DIN ISO 20457:2018 - TG7 - Metal and other plastic parts: DIN ISO 2769-fH Material to comply with RoHS Directive 2011/65/EU incl. 2015/863/EU | Material 1.0037 (S235JR) | Scale 2 : 1

01 | Drillings | 23.11.2016 | G.Gaus | | | | Approved by
02 | ⌀8,4 in M10 | 11.10.2023 | J. Bähr

Title Weld-on mounting plate | | 201-10-5-020

03 | Integration into the QMS | 23.01.2024 | J. Bähr
04 | Transfer to Inventor | 30.01.2025 | Z.Gabric

ERG-Article-Nr.

Ganshorn Medizin Electronic GmbH
Industriestraße 6-8, D-97618 Niederlauer, Germany

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
