Zvonko2203/Map-from-transfer-folder/SanaBike 1000 tehnical drawings 2025/Kristijan_comments/21-30-101.pdf

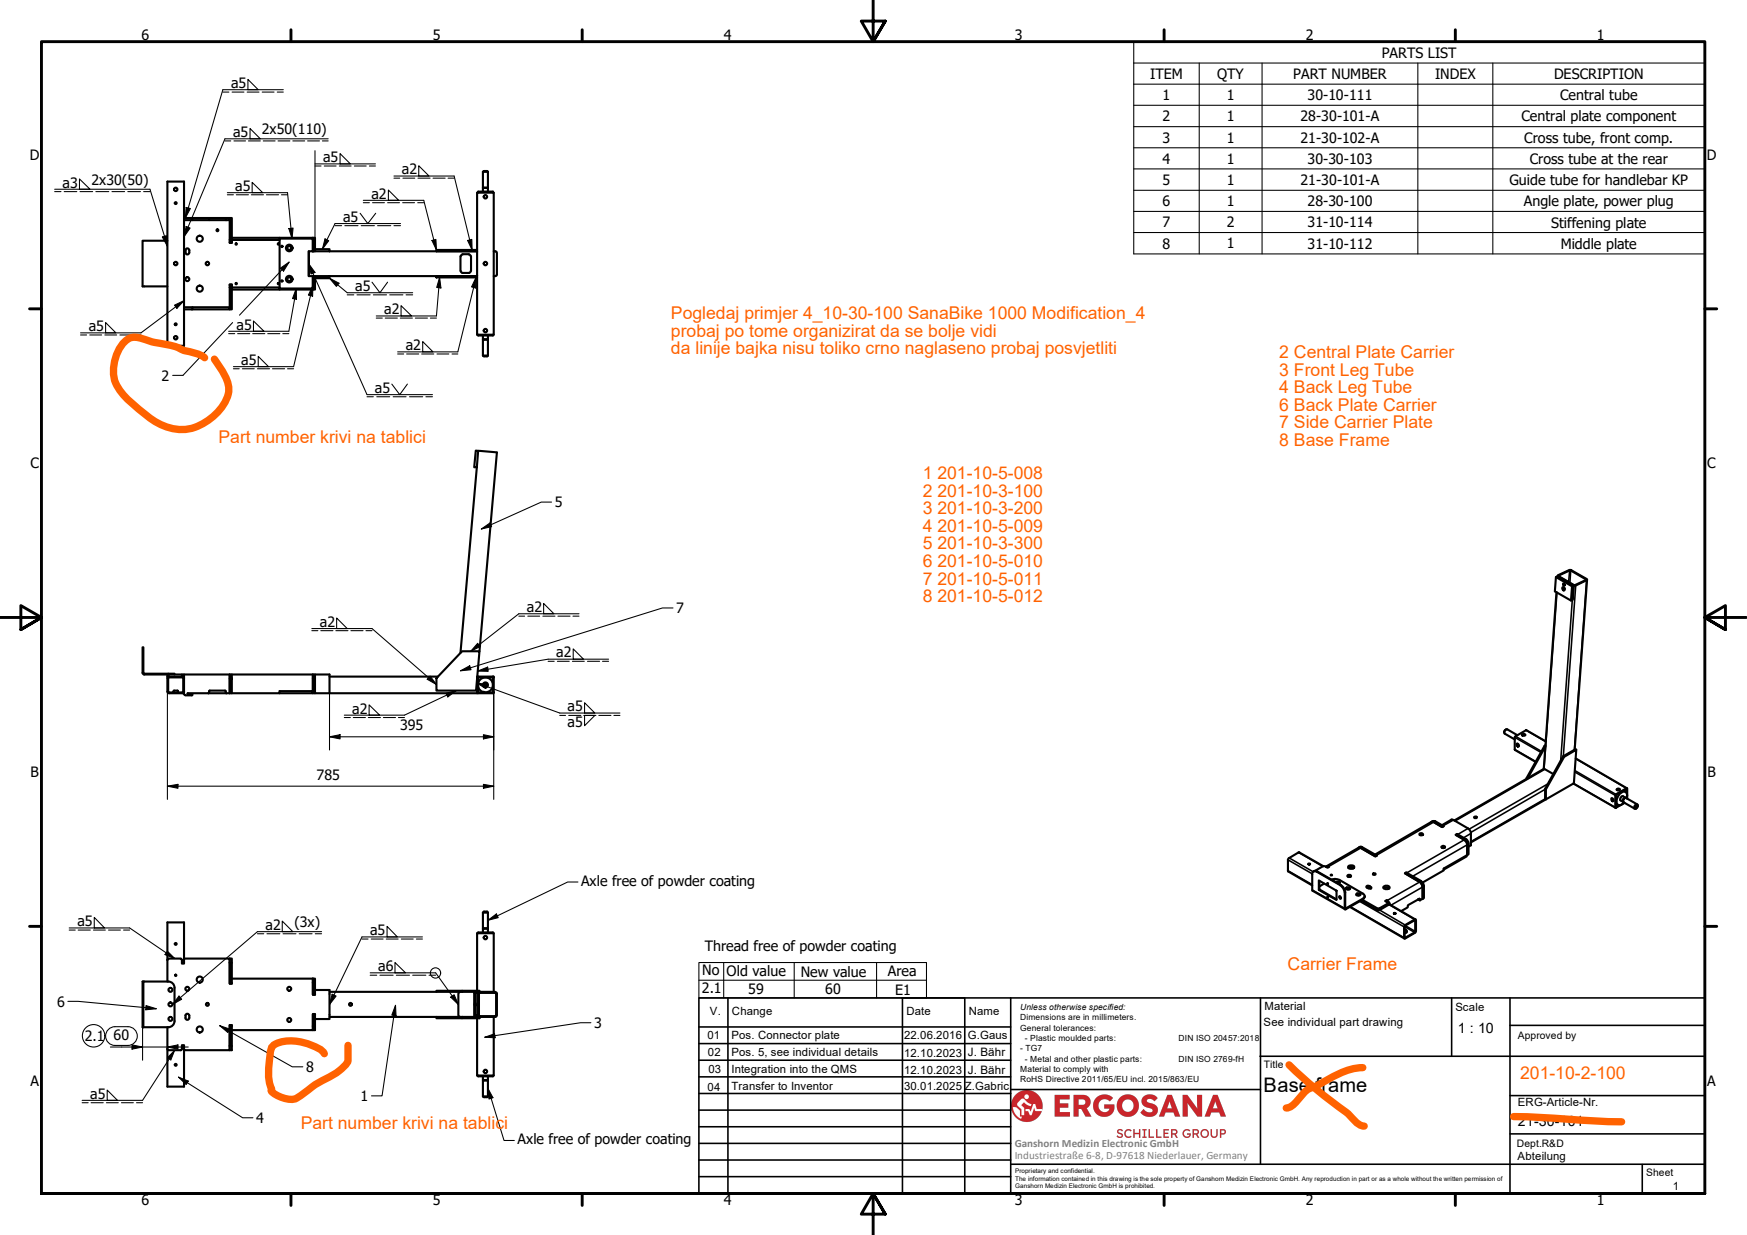
[picture p29: page 1]
Approved by; Pos. Connector plate; G.Gaus; Carrier Frame; Part number krivi na tablici; 8 Base Frame

a5 | PARTS LIST

ITEM | QTY | PART NUMBER | INDEX | DESCRIPTION
1 | 1 | 30-10-111 | | Central tube
2 | 1 | 28-30-101-A | | Central plate component
3 | 1 | 21-30-102-A | | Cross tube, front comp.
4 | 1 | 30-30-103 | | Cross tube at the rear
5 | 1 | 21-30-101-A | | Guide tube for handlebar KP
6 | 1 | 28-30-100 | | Angle plate, power plug
7 | 2 | 31-10-114 | | Stiffening plate
8 | 1 | 31-10-112 | | Middle plate

Pogledaj primjer 4_10-30-100 SanaBike 1000 Modification_4
probaj po tome organizirat da se bolje vidi
da linije bajka nisu toliko crno naglaseno probaj posvjetliti

2 Central Plate Carrier
3 Front Leg Tube
4 Back Leg Tube
6 Back Plate Carrier
7 Side Carrier Plate

Axle free of powder coating

Thread free of powder coating

No | Old value | New value | Area
2.1 | 59 | 60 | E1
V. | Change | Date | Name | Unless otherwise specified: Dimensions are in millimeters. General tolerances: - Plastic moulded parts: DIN ISO 20457:2018 - TG7 - Metal and other plastic parts: DIN ISO 2769-fH Material to comply with RoHS Directive 2011/65/EU incl. 2015/863/EU | Material See individual part drawing | Scale 1 : 10

02 | Pos. 5, see individual details | 12.10.2023 | J. Bähr
03 | Integration into the QMS | 12.10.2023 | J. Bähr
04 | Transfer to Inventor | 30.01.2025 | Z.Gabric

Title Base frame | 201-10-2-100

Part number krivi na tablici

ERG-Article-Nr.

Ganshorn Medizin Electronic GmbH
Industriestraße 6-8, D-97618 Niederlauer, Germany

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
