Zvonko2203/Map-from-transfer-folder/SanaBike 1000 tehnical drawings 2025/Kristijan_comments/21-30-102-A1.pdf

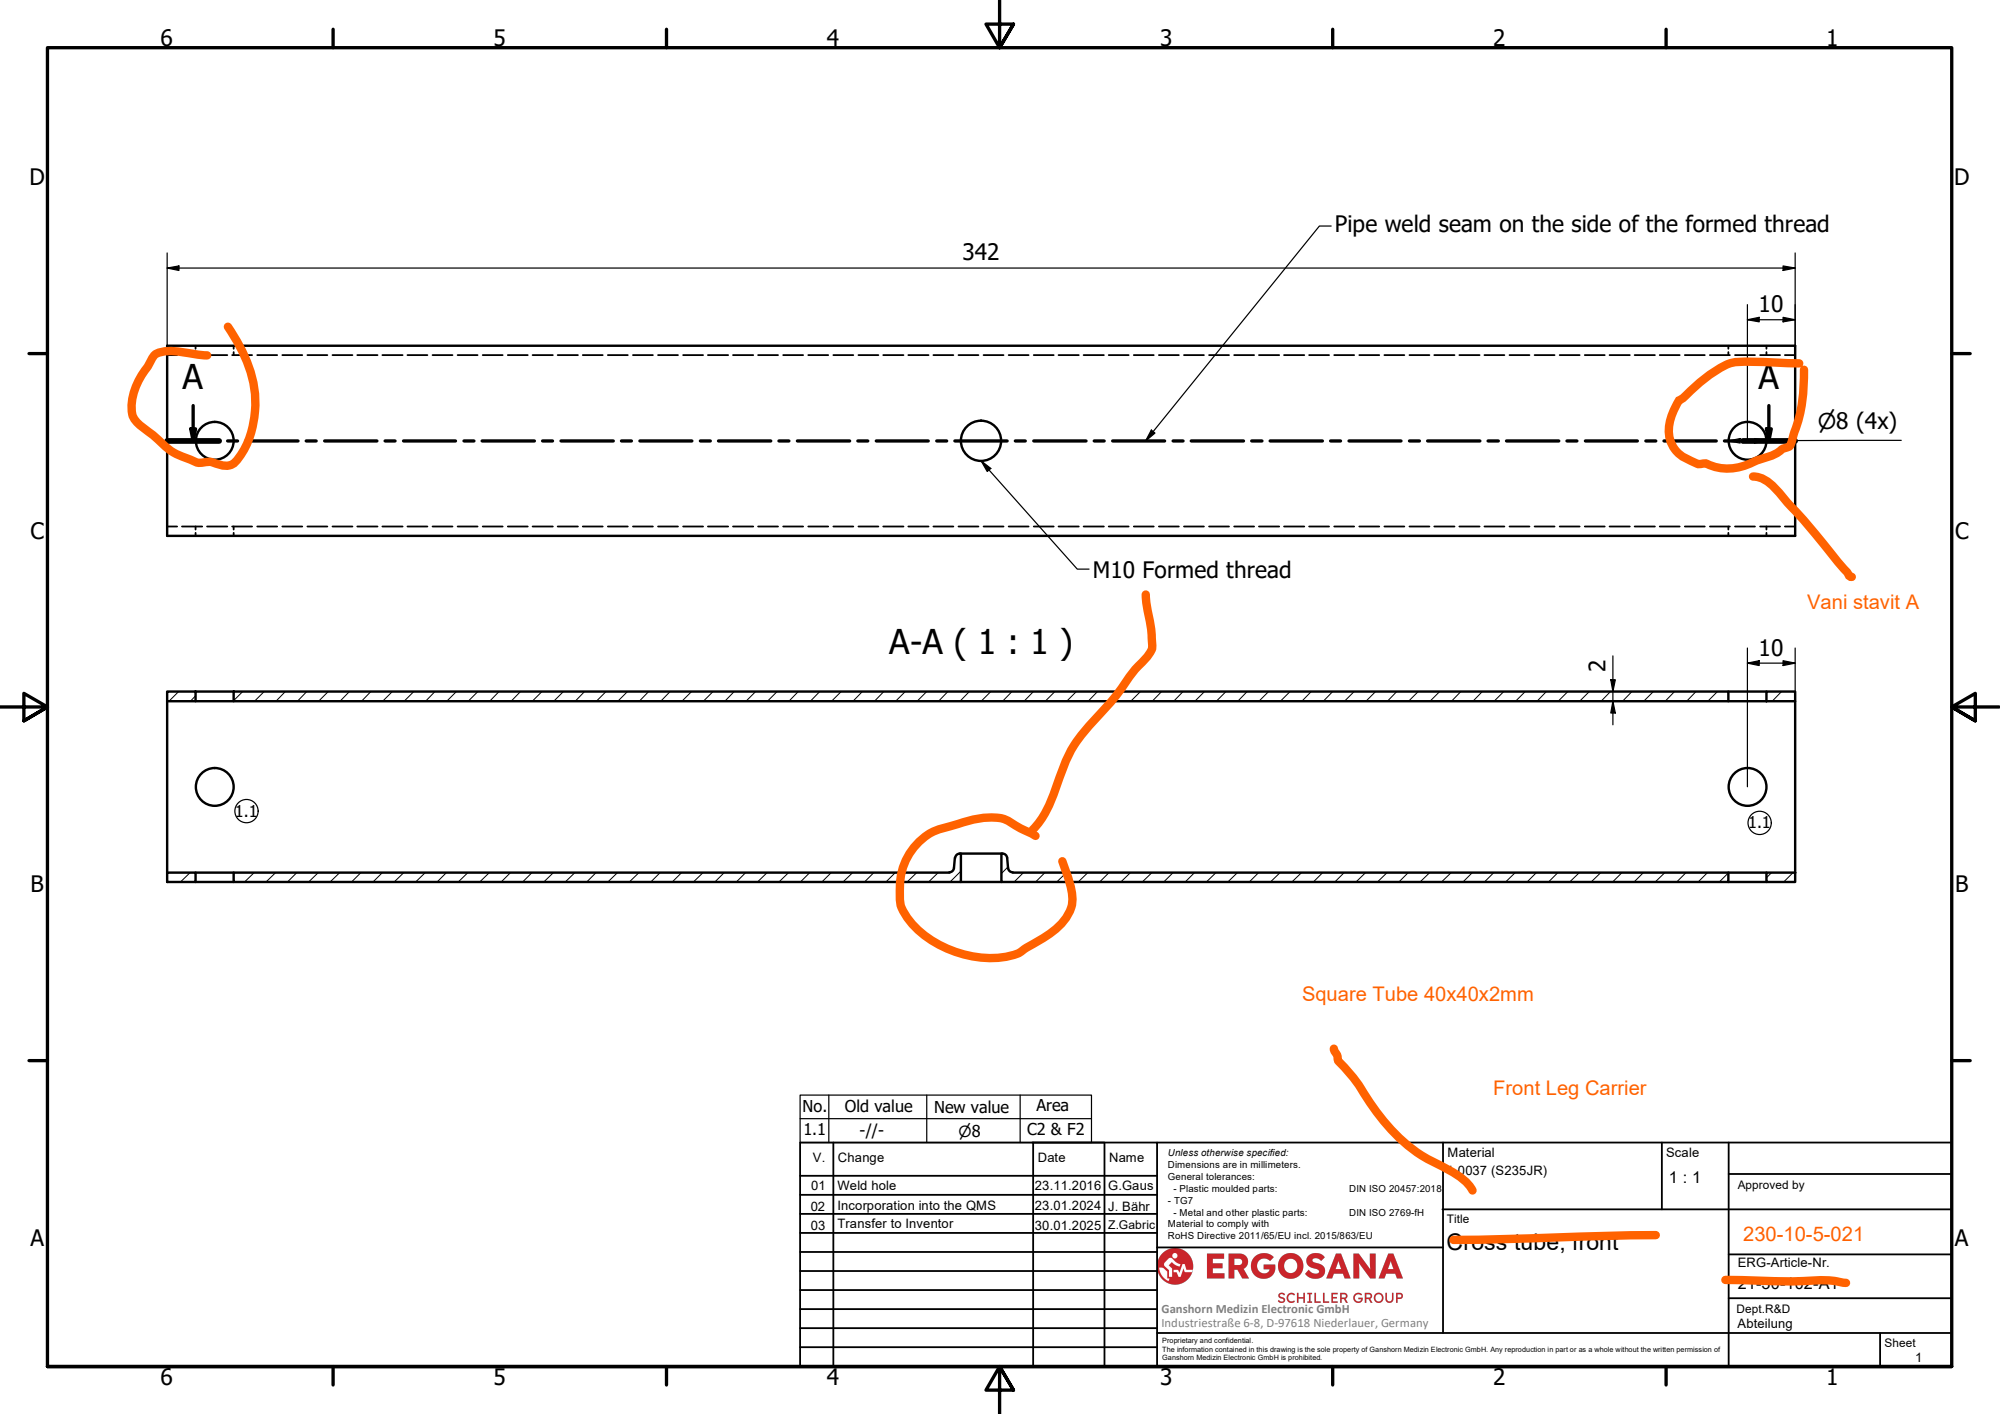
[picture p30: page 1]
M10 Formed thread; Square Tube 40x40x2mm; Vani stavit A

Pipe weld seam on the side of the formed thread

Front Leg Carrier

No. | Old value | New value | Area
1.1 | -//- | ⌀8 | C2 & F2

V. | Change | Date | Name | Unless otherwise specified: Dimensions are in millimeters. General tolerances: - Plastic moulded parts: DIN ISO 20457:2018 - TG7 - Metal and other plastic parts: DIN ISO 2769-fH Material to comply with RoHS Directive 2011/65/EU incl. 2015/863/EU | Material 1.0037 (S235JR) | Scale 1 : 1

01 | Weld hole | 23.11.2016 | G.Gaus | | | | Approved by
02 | Incorporation into the QMS | 23.01.2024 | J. Bähr
03 | Transfer to Inventor | 30.01.2025 | Z.Gabric

Title Cross tube, front | | 230-10-5-021

ERG-Article-Nr.

Ganshorn Medizin Electronic GmbH
Industriestraße 6-8, D-97618 Niederlauer, Germany

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
