Zvonko2203/Map-from-transfer-folder/SanaBike 1000 tehnical drawings 2025/Kristijan_comments/21-30-801-A1.pdf

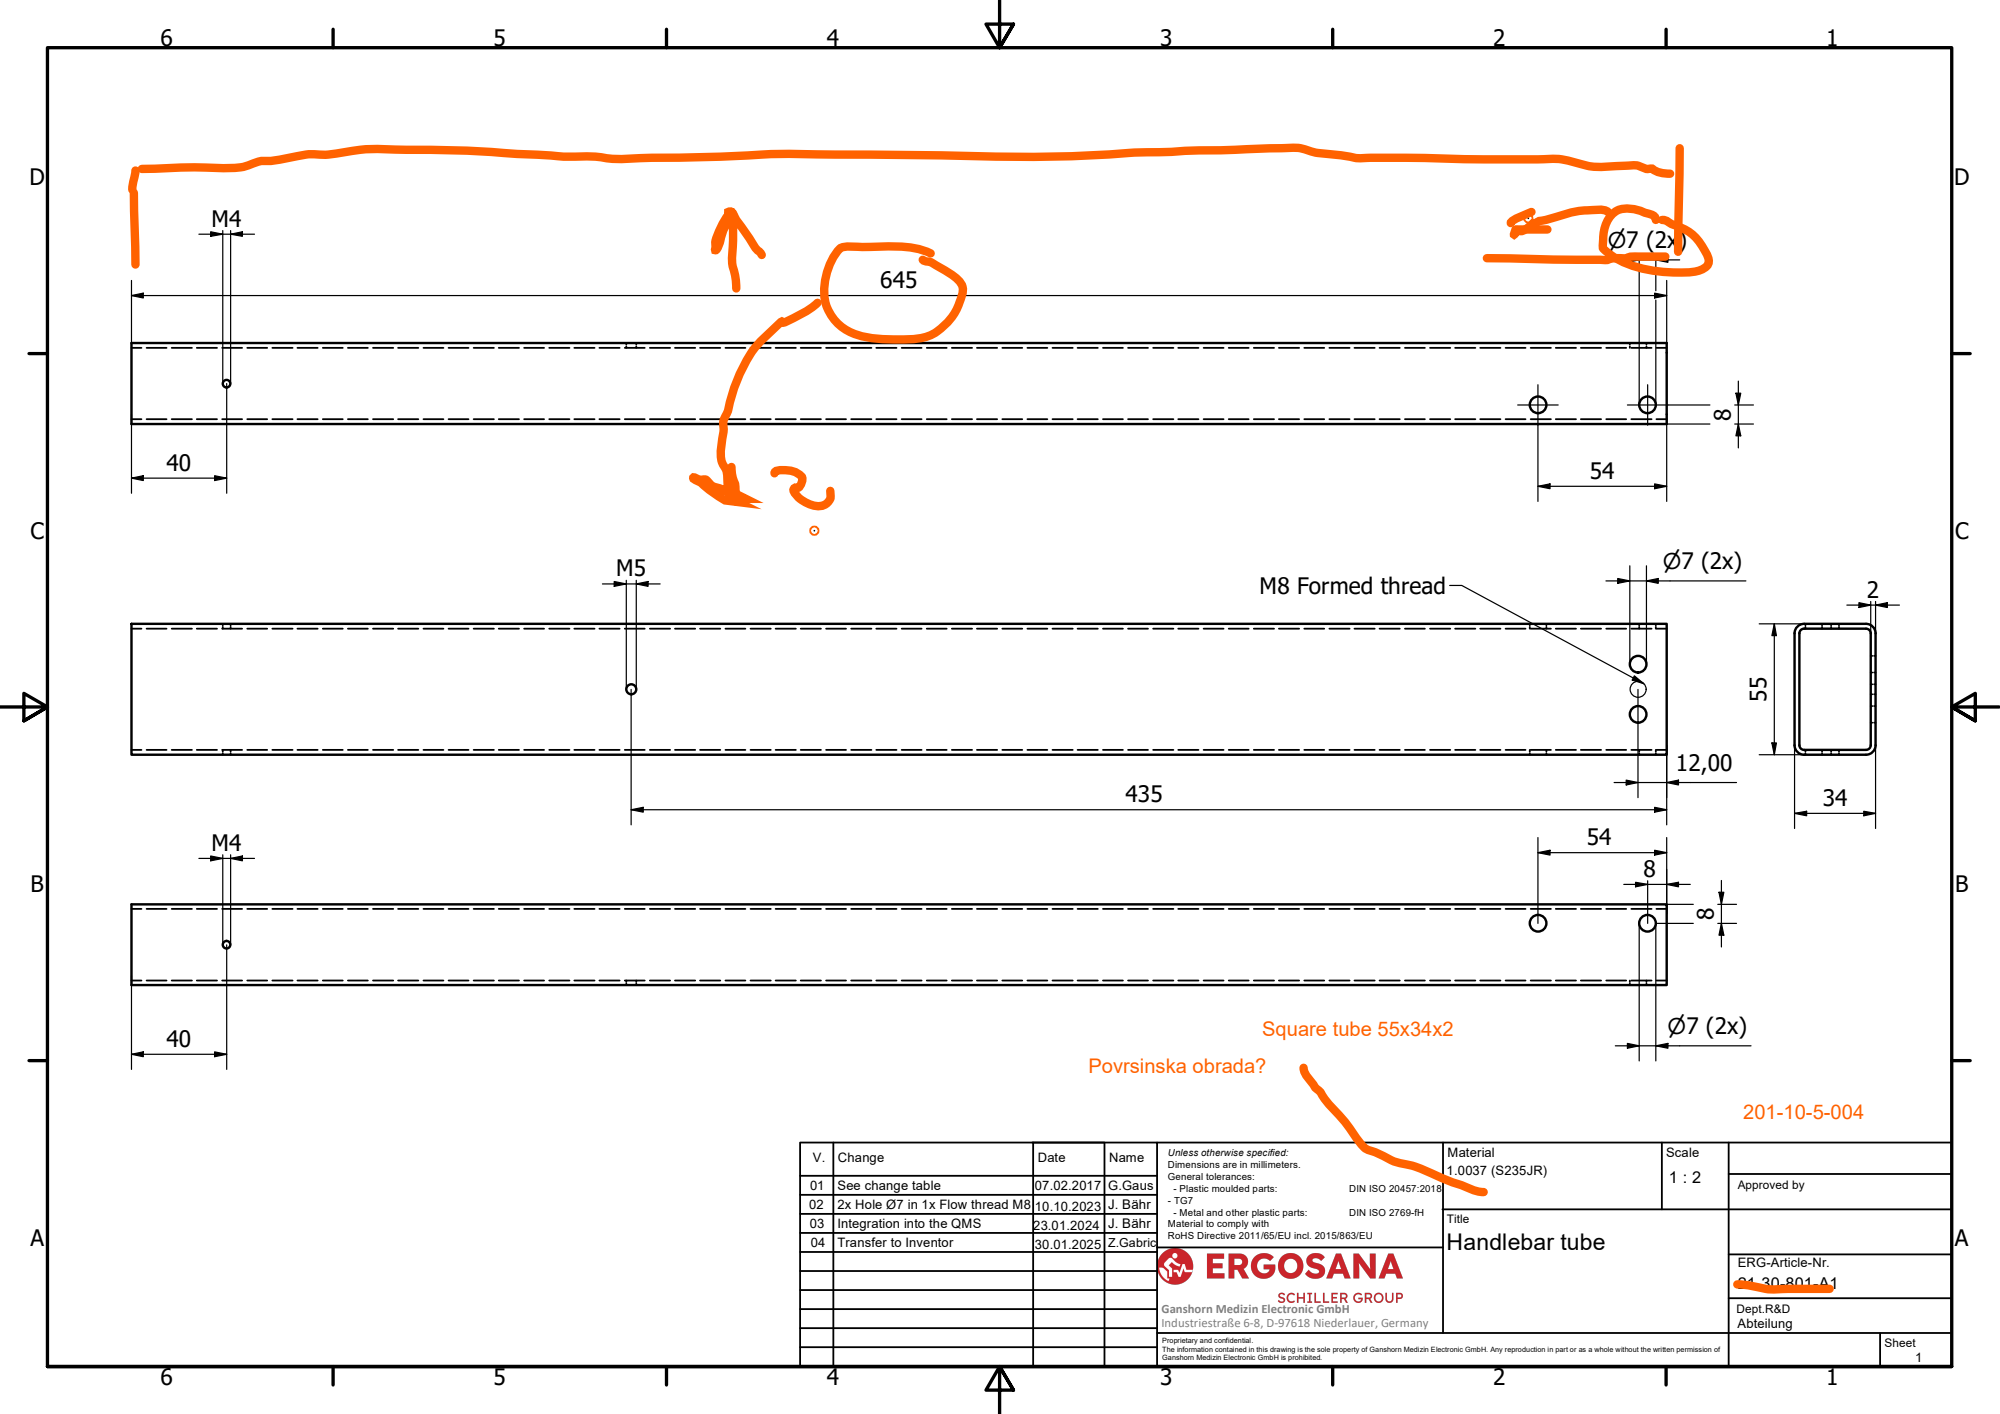
[picture p31: page 1]
M8 Formed thread; Square tube 55x34x2 Povrsinska obrada?

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

01 | See change table | 07.02.2017 | G.Gaus | | | | Approved by
02 | 2x Hole Ø7 in 1x Flow thread M8 | 10.10.2023 | J. Bähr
03 | Integration into the QMS | 23.01.2024 | J. Bähr
04 | Transfer to Inventor | 30.01.2025 | Z.Gabric

Title Handlebar tube

ERG-Article-Nr.

Ganshorn Medizin Electronic GmbH
Industriestraße 6-8, D-97618 Niederlauer, Germany

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
