Zvonko2203/Map-from-transfer-folder/SanaBike 1000 tehnical drawings 2025/Kristijan_comments/25-30-100.pdf

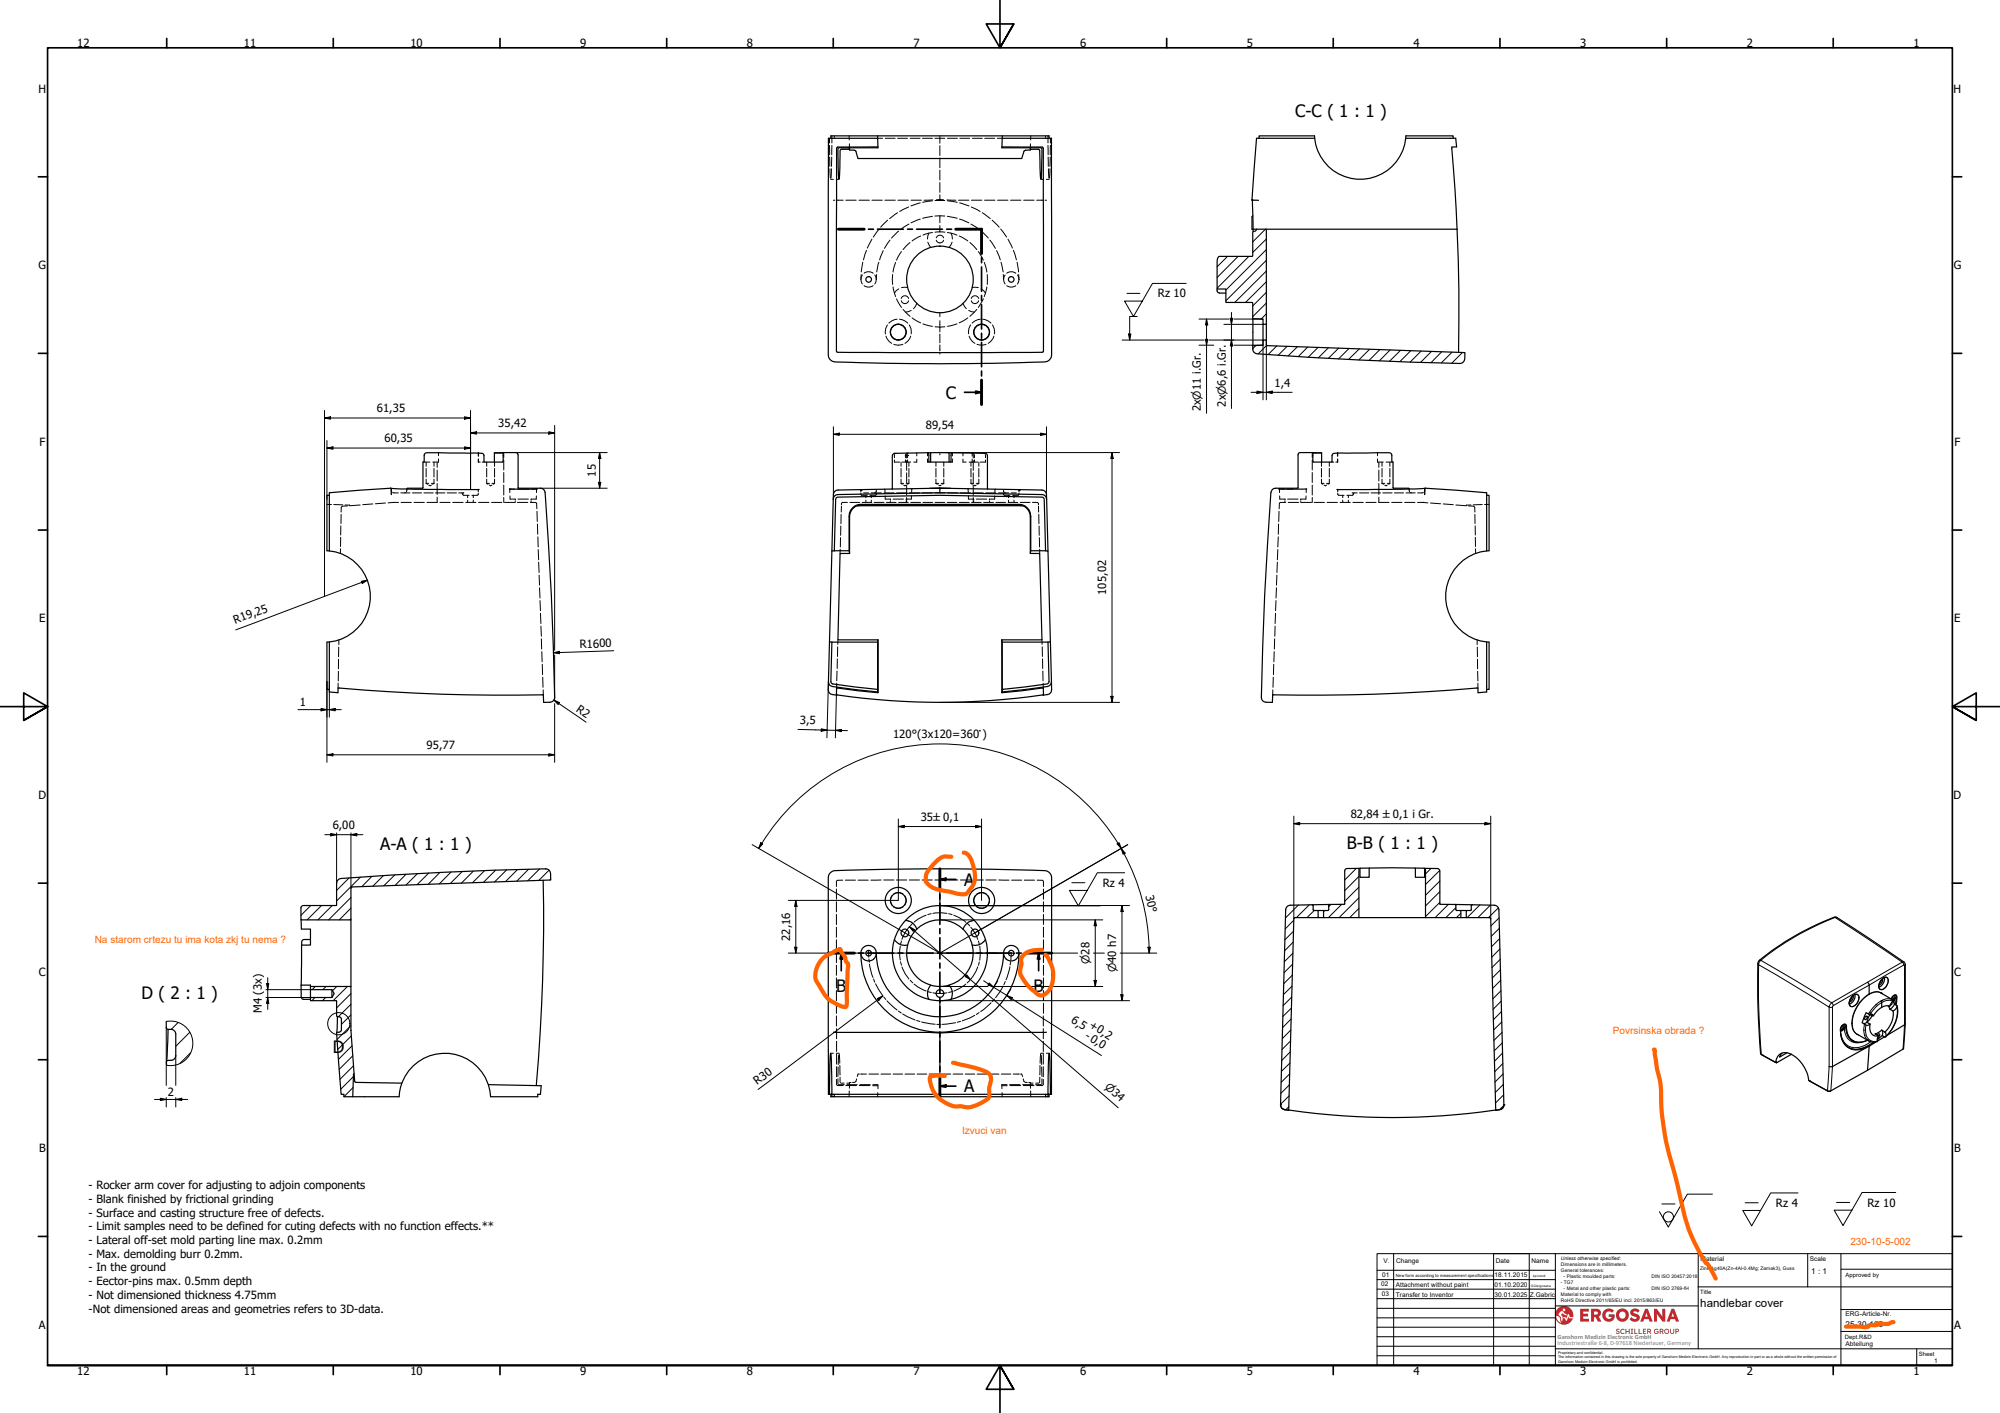
[picture p32: page 1]
Izvuci van; Povrsinska obrada ?

Na starom crtezu tu ima kota zkj tu nema ?

- Rocker arm cover for adjusting to adjoin components
- Blank finished by frictional grinding
- Surface and casting structure free of defects.
- Limit samples need to be defined for cuting defects with no function effects.**
- Lateral off-set mold parting line max. 0.2mm
- Max. demolding burr 0.2mm.
- In the ground
- Eector-pins max. 0.5mm depth
- Not dimensioned thickness 4.75mm
-Not dimensioned areas and geometries refers to 3D-data.

V. | Change | Date | Name | Unless otherwise specified: Dimensions are in millimeters. General tolerances: - Plastic moulded parts: DIN ISO 20457:2018 - TG7 - Metal and other plastic parts: DIN ISO 2769-fH Material to comply with RoHS Directive 2011/65/EU incl. 2015/863/EU | Material Zink Ag40A(Zn-4Al-0.4Mg; Zamak3), Guss | Scale 1 : 1

01 | New form according to measurement specifications18.11.2015 | | kp/condi | | | | Approved by
02 | Attachment without paint | 01.10.2020 | GG/ergosana
03 | Transfer to Inventor | 30.01.2025 | Z.Gabric | | Title handlebar cover

ERG-Article-Nr.

Ganshorn Medizin Electronic GmbH
Industriestraße 6-8, D-97618 Niederlauer, Germany

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
