Zvonko2203/Map-from-transfer-folder/SanaBike 1000 tehnical drawings 2025/Kristijan_comments/25-30-101.pdf

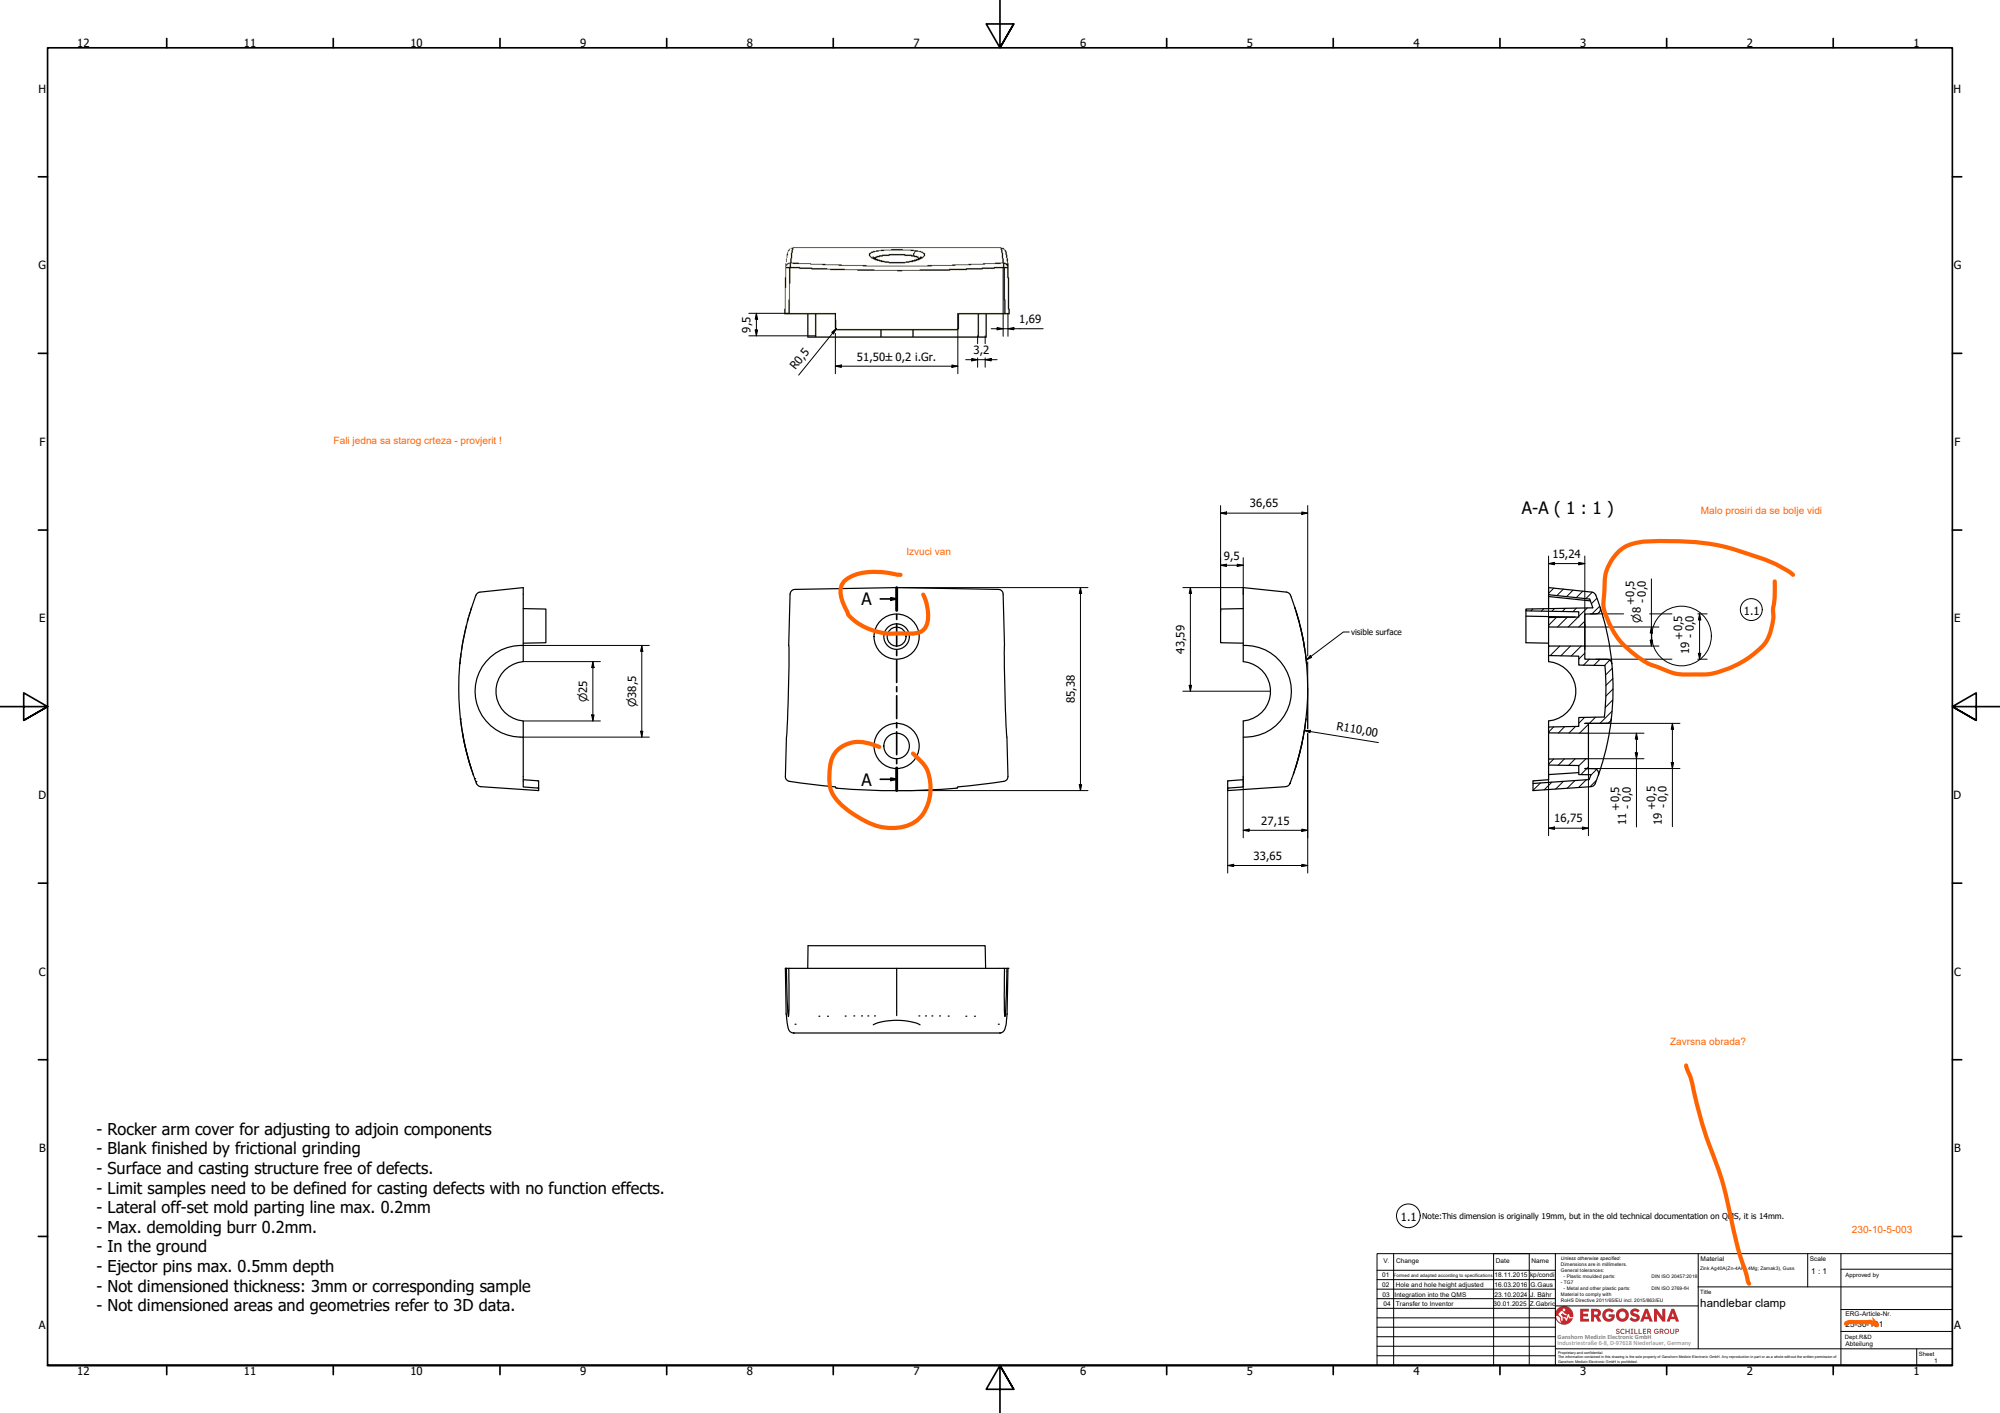
[picture p33: page 1]
visible surface; Zavrsna obrada?; Izvuci van

Fali jedna sa starog crteza - provjerit !

Malo prosiri da se bolje vidi

- Rocker arm cover for adjusting to adjoin components
- Blank finished by frictional grinding
- Surface and casting structure free of defects.
- Limit samples need to be defined for casting defects with no function effects.
- Lateral off-set mold parting line max. 0.2mm
- Max. demolding burr 0.2mm.
- In the ground
- Ejector pins max. 0.5mm depth
- Not dimensioned thickness: 3mm or corresponding sample
- Not dimensioned areas and geometries refer to 3D data.

1.1 Note:This dimension is originally 19mm, but in the old technical documentation on QMS, it is 14mm.

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

01 | Formed and adapted according to specifications | 18.11.2015 | kp/condi | | | | Approved by
02 | Hole and hole height adjusted | 16.03.2016 | G.Gaus
03 | Integration into the QMS | 23.10.2024 | J. Bähr | | Title handlebar clamp
04 | Transfer to Inventor | 30.01.2025 | Z.Gabric

ERG-Article-Nr.

Ganshorn Medizin Electronic GmbH
Industriestraße 6-8, D-97618 Niederlauer, Germany

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
