Zvonko2203/Map-from-transfer-folder/SanaBike 1000 tehnical drawings 2025/Kristijan_comments/27-10-808.pdf

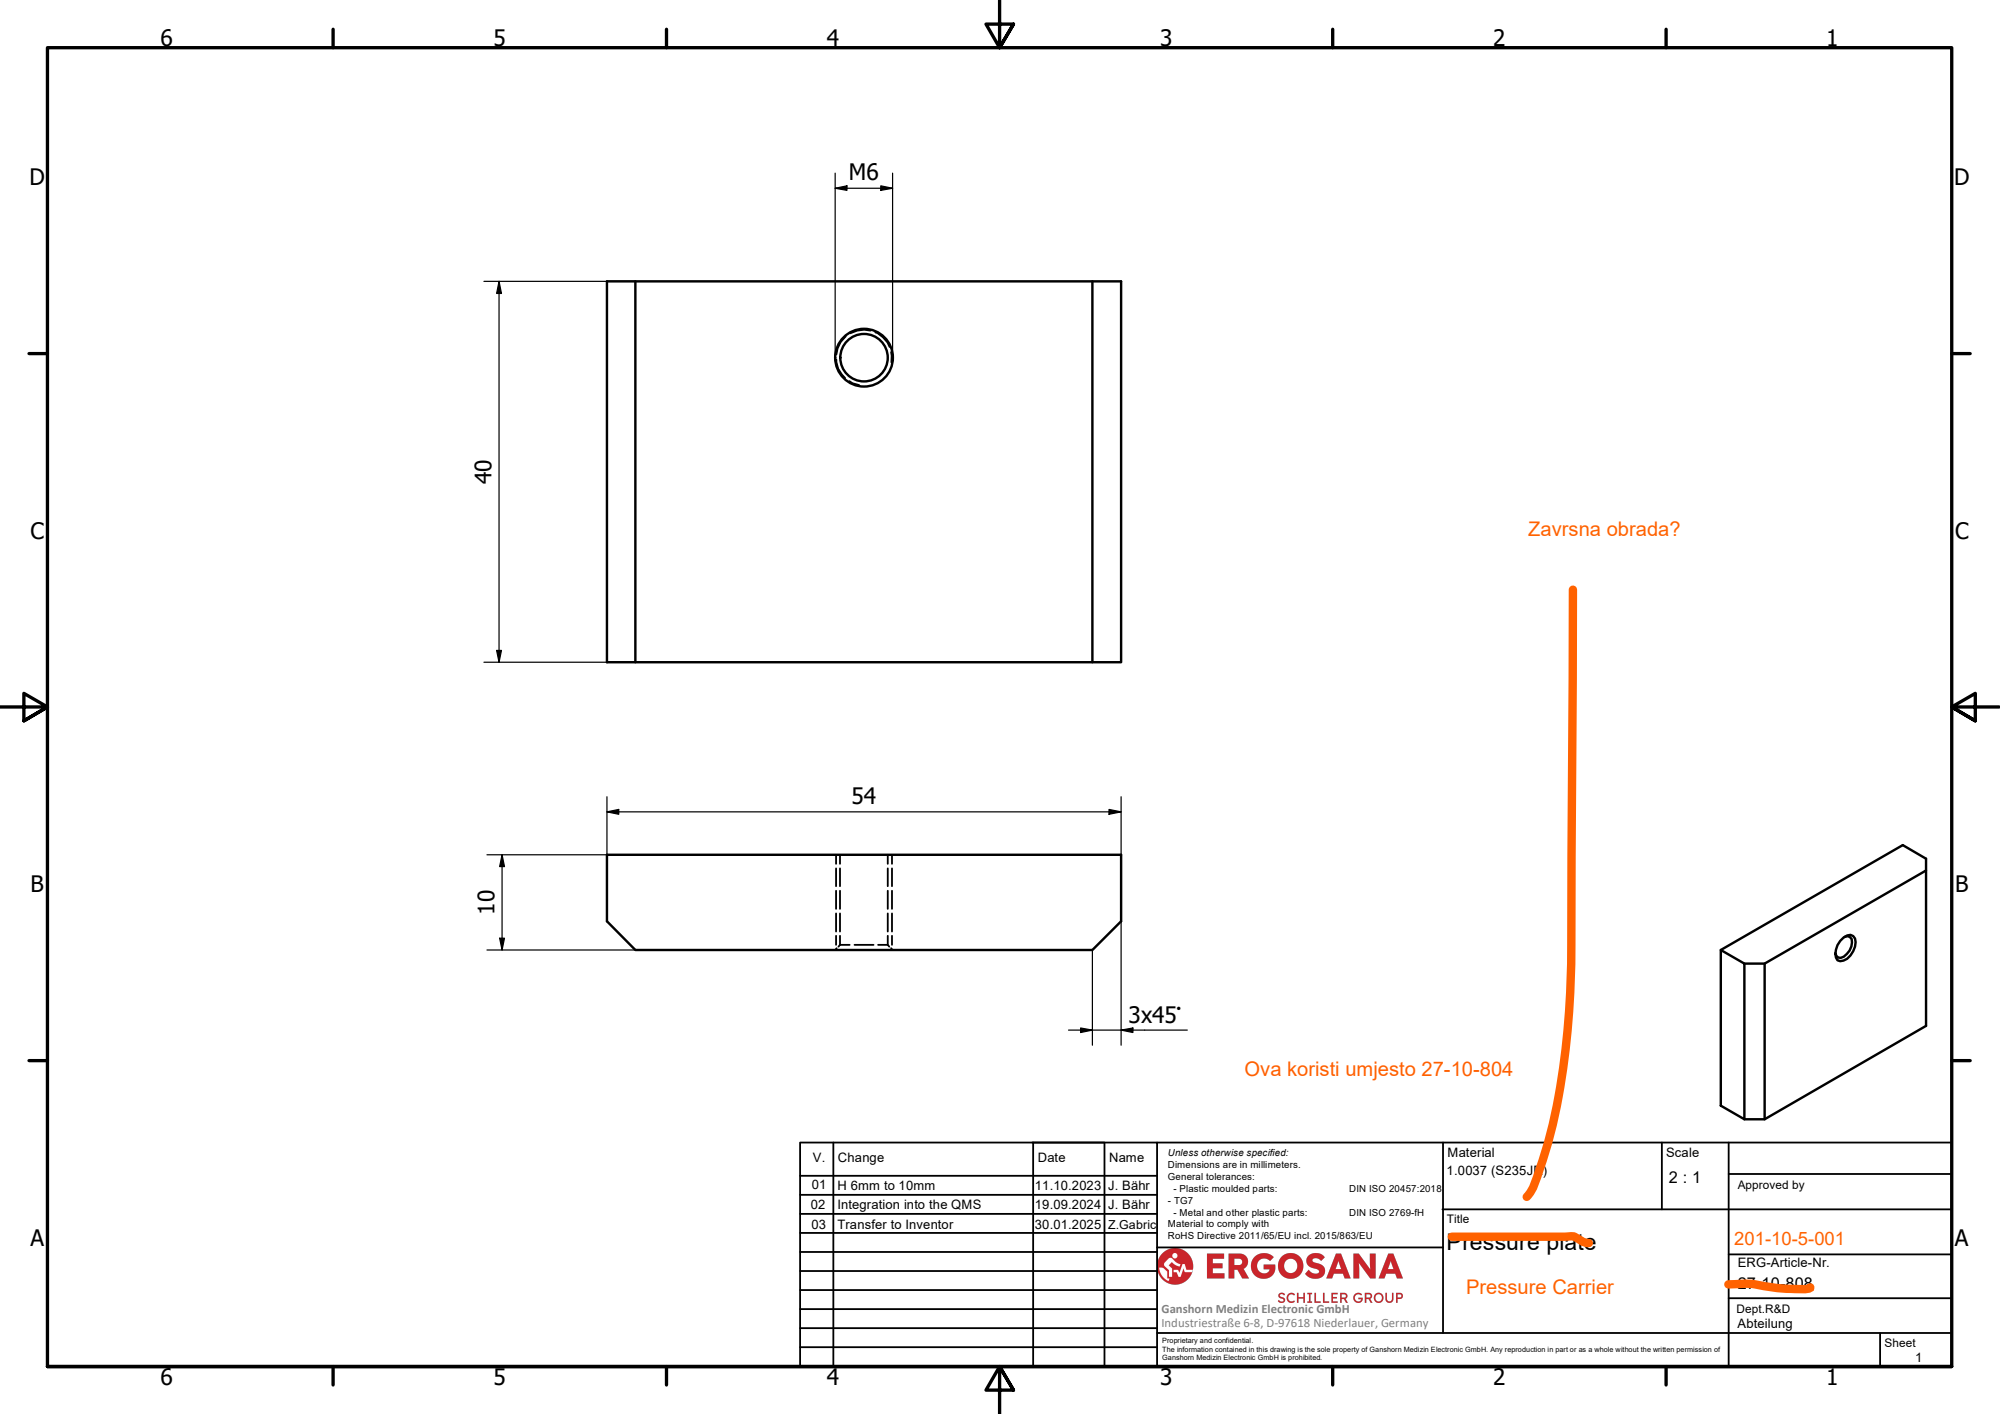
[picture p34: page 1]
Zavrsna obrada?

Ova koristi umjesto 27-10-804

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

01 | H 6mm to 10mm | 11.10.2023 | J. Bähr | | | | Approved by
02 | Integration into the QMS | 19.09.2024 | J. Bähr
03 | Transfer to Inventor | 30.01.2025 | Z.Gabric

Title Pressure plate Pressure Carrier | | 201-10-5-001

ERG-Article-Nr.

Ganshorn Medizin Electronic GmbH
Industriestraße 6-8, D-97618 Niederlauer, Germany

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
