Zvonko2203/Map-from-transfer-folder/SanaBike 1000 tehnical drawings 2025/Kristijan_comments/28-30-001.pdf

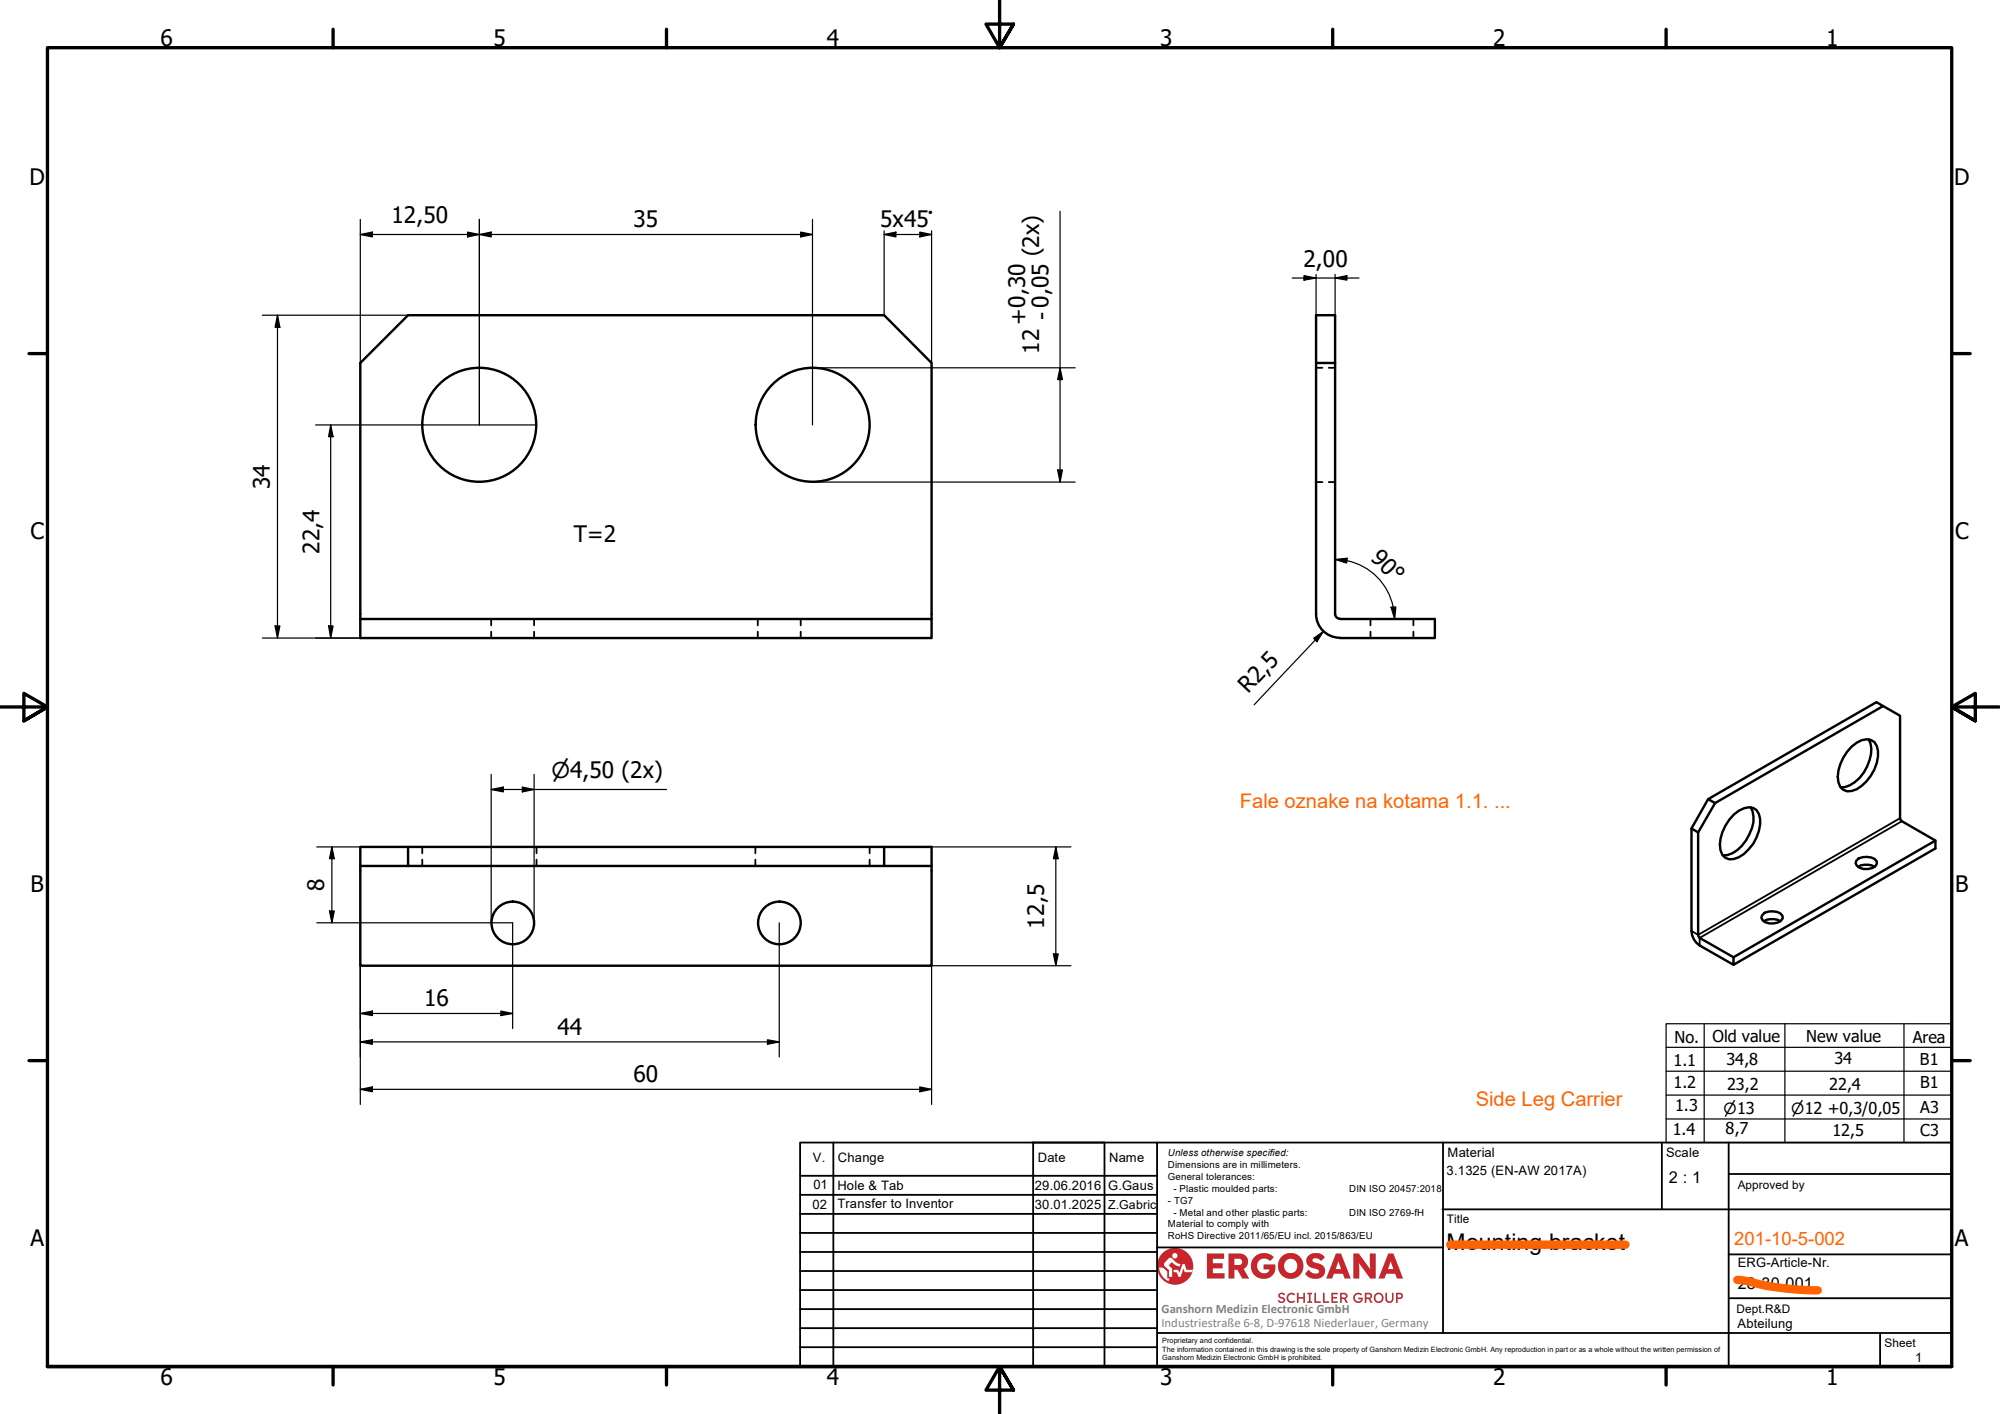
[picture p35: page 1]

Fale oznake na kotama 1.1. ...

No. | Old value | New value | Area
1.1 | 34,8 | 34 | B1
1.2 | 23,2 | 22,4 | B1
1.3 | ⌀13 | ⌀12 +0,3/0,05 | A3
1.4 | 8,7 | 12,5 | C3

Side Leg Carrier

V. | Change | Date | Name | Unless otherwise specified: Dimensions are in millimeters. General tolerances: - Plastic moulded parts: DIN ISO 20457:2018 - TG7 - Metal and other plastic parts: DIN ISO 2769-fH Material to comply with RoHS Directive 2011/65/EU incl. 2015/863/EU | Material 3.1325 (EN-AW 2017A) | Scale 2 : 1

01 | Hole & Tab | 29.06.2016 | G.Gaus | | | | Approved by
02 | Transfer to Inventor | 30.01.2025 | Z.Gabric

Title Mounting bracket | | 201-10-5-002

ERG-Article-Nr.

Ganshorn Medizin Electronic GmbH
Industriestraße 6-8, D-97618 Niederlauer, Germany

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
