Zvonko2203/Map-from-transfer-folder/SanaBike 1000 tehnical drawings 2025/Kristijan_comments/30-30-103.pdf

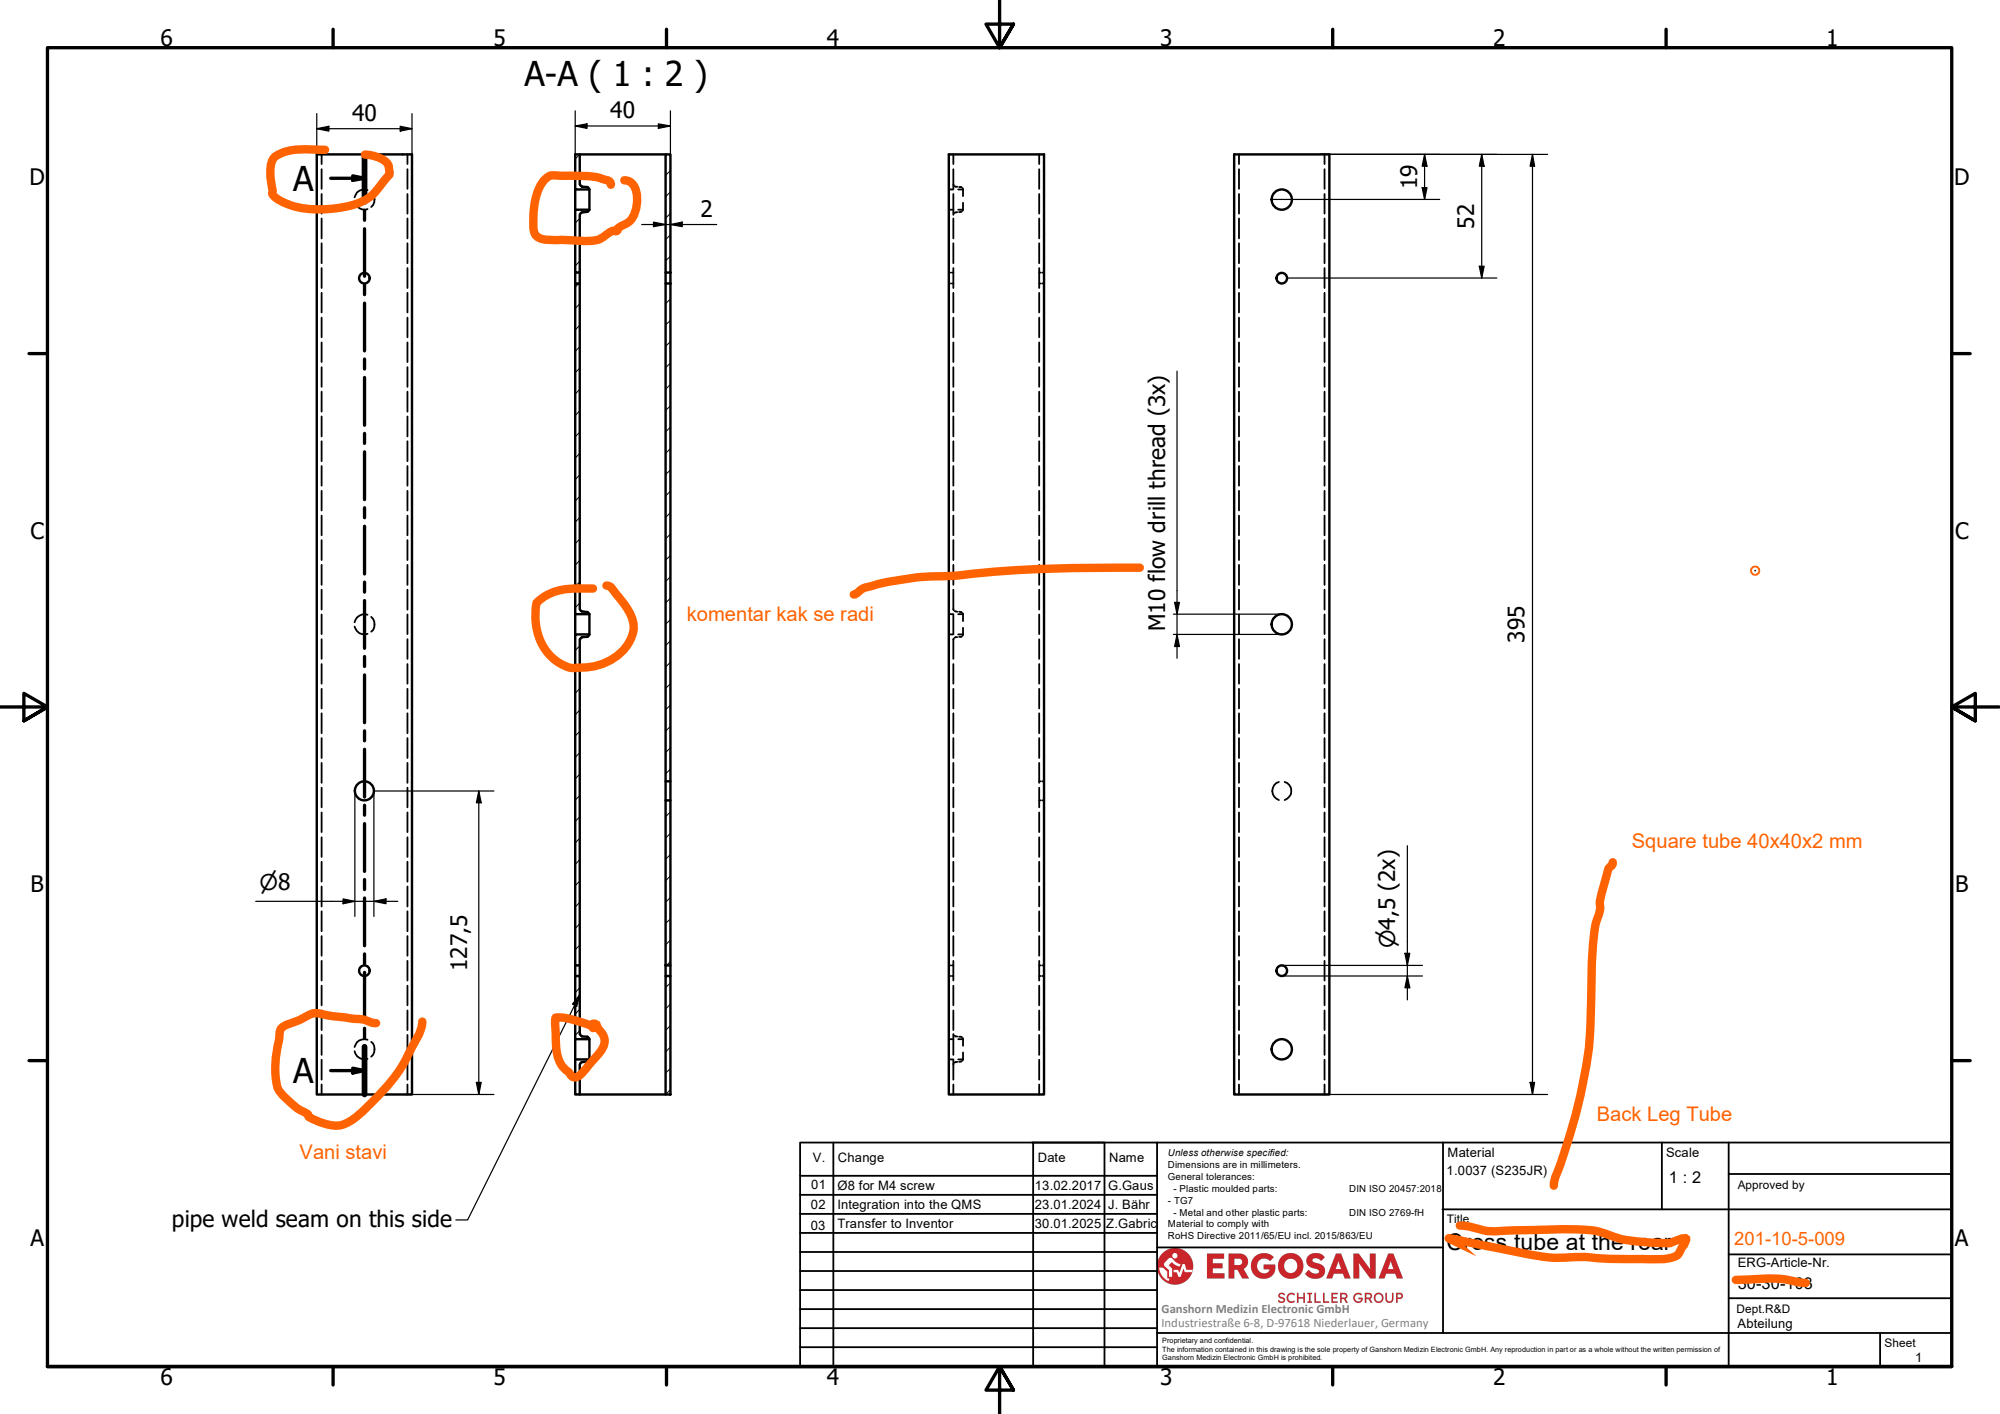
[picture p36: page 1]
drill thre; Vani stavi

komentar kak se radi

Square tube 40x40x2 mm

Back Leg Tube

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

01 | Ø8 for M4 screw | 13.02.2017 | G.Gaus | | | | Approved by
02 | Integration into the QMS | 23.01.2024 | J. Bähr
03 | Transfer to Inventor | 30.01.2025 | Z.Gabric

pipe weld seam on this side

Title Cross tube at the rear | | 201-10-5-009

ERG-Article-Nr.

Ganshorn Medizin Electronic GmbH
Industriestraße 6-8, D-97618 Niederlauer, Germany

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
