Zvonko2203/Map-from-transfer-folder/SanaBike 1000 tehnical drawings 2025/Kristijan_comments/31-10-112.pdf

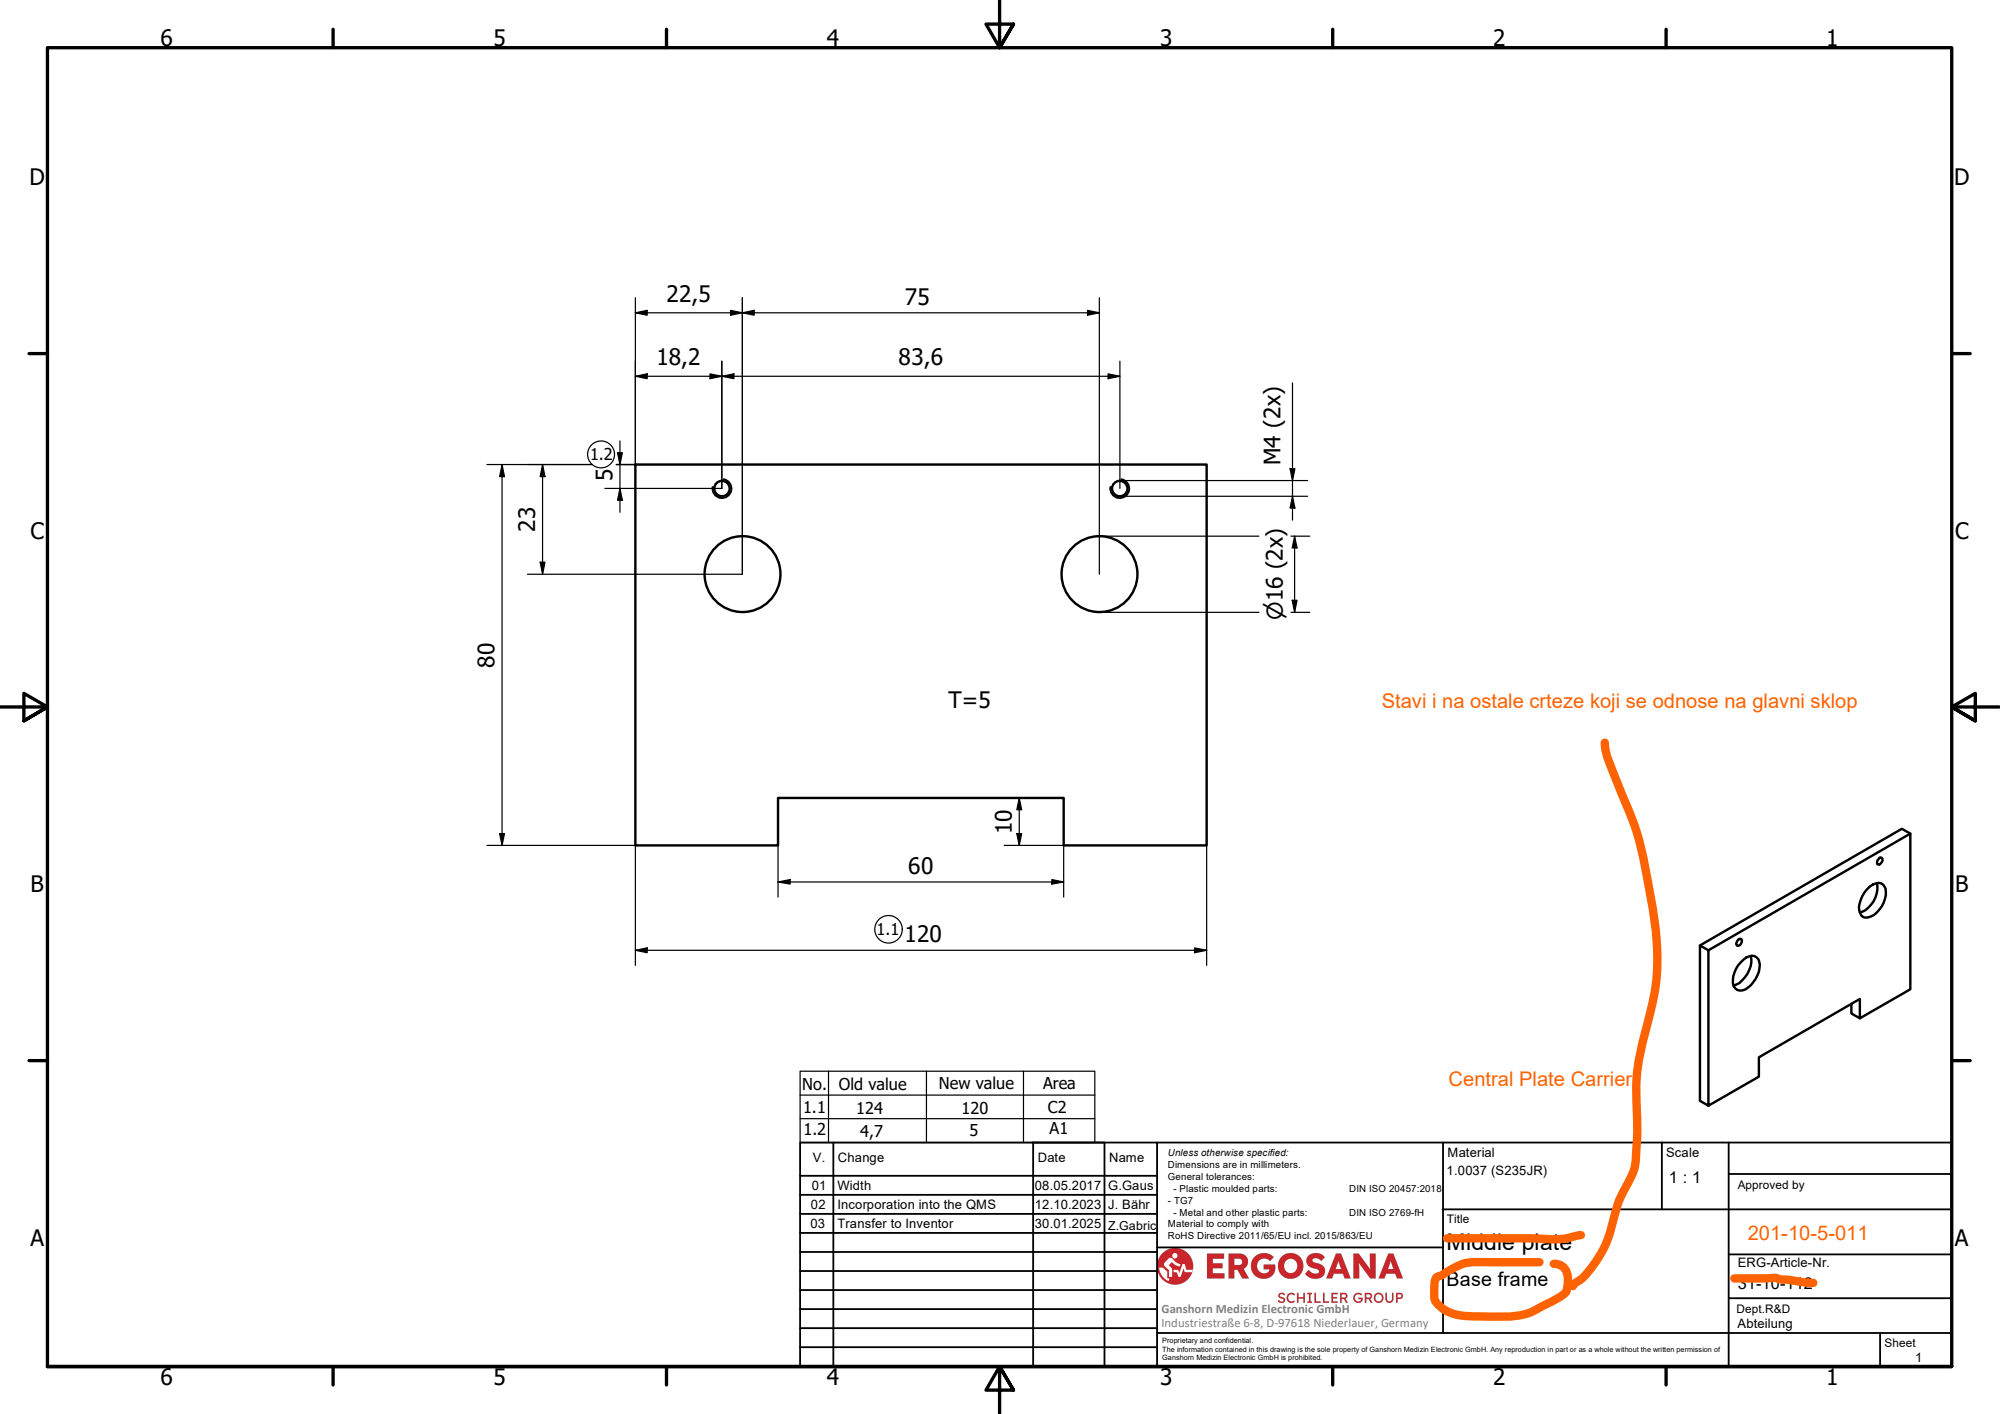
[picture p37: page 1]
Middle plate; Base frame

Stavi i na ostale crteze koji se odnose na glavni sklop

Central Plate Carrier

No. | Old value | New value | Area
1.1 | 124 | 120 | C2
1.2 | 4,7 | 5 | A1

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

Width01 | 08.05.2017 | G.Gaus | | | | Approved by
02 | Incorporation into the QMS | 12.10.2023 | J. Bähr
03 | Transfer to Inventor | 30.01.2025 | Z.Gabric

ERG-Article-Nr.

Ganshorn Medizin Electronic GmbH
Industriestraße 6-8, D-97618 Niederlauer, Germany

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
