Zvonko2203/Map-from-transfer-folder/SanaBike 1000 tehnical drawings 2025/Kristijan_comments/31-10-301.pdf

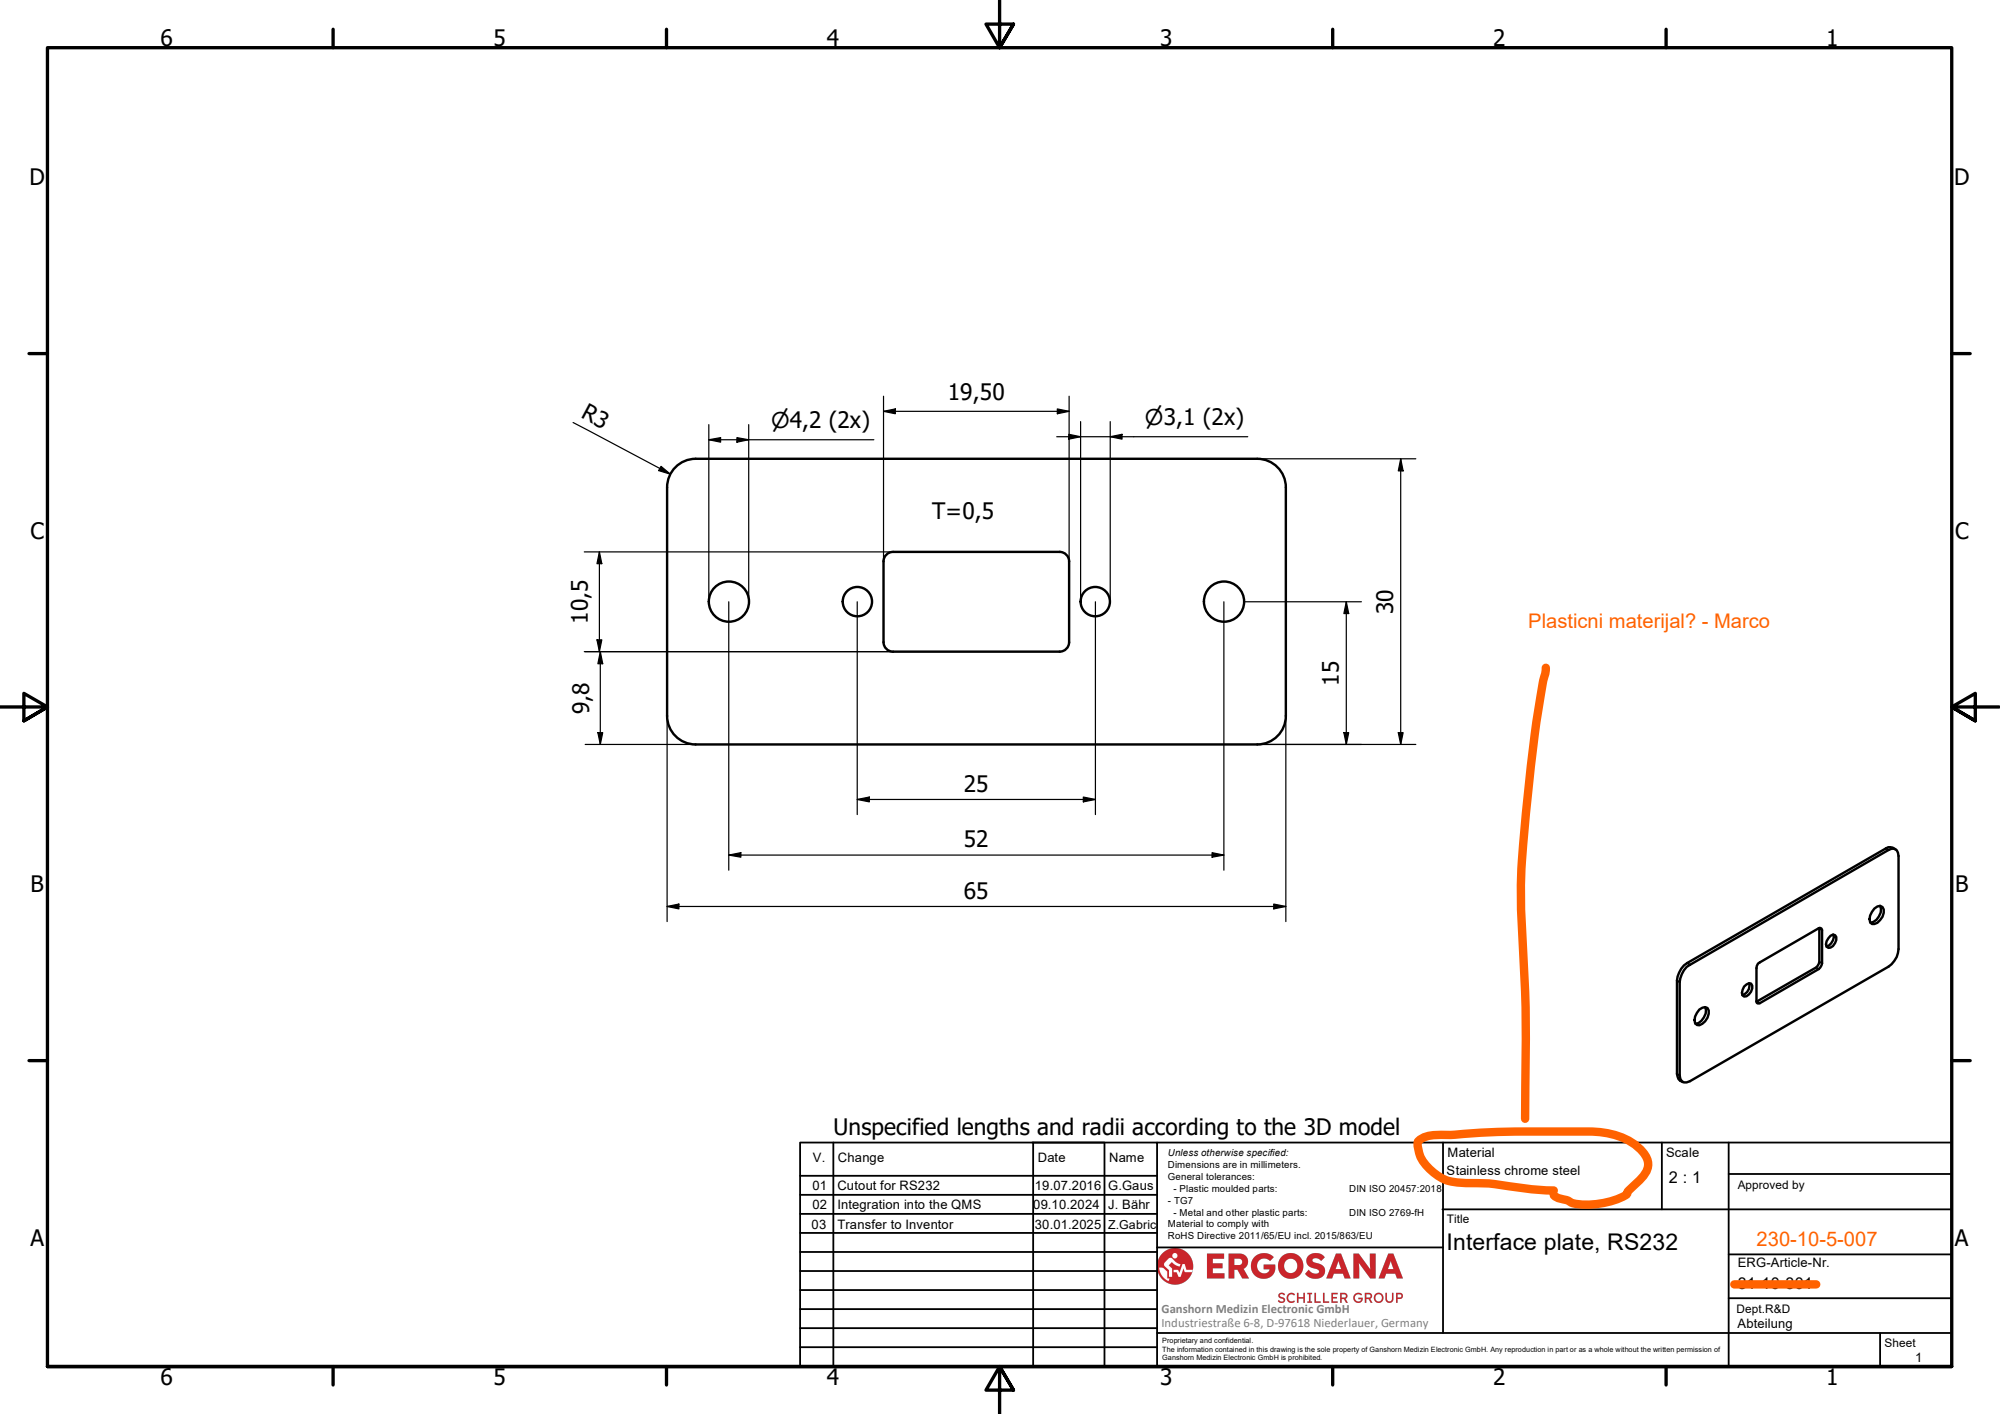
[picture p38: page 1]

Plasticni materijal? - Marco

Unspecified lengths and radii according to the 3D model

V. | Change | Date | Name | Unless otherwise specified: Dimensions are in millimeters. General tolerances: - Plastic moulded parts: DIN ISO 20457:2018 - TG7 - Metal and other plastic parts: DIN ISO 2769-fH Material to comply with RoHS Directive 2011/65/EU incl. 2015/863/EU | Material Stainless chrome steel | Scale 2 : 1

01 | Cutout for RS232 | 19.07.2016 | G.Gaus | | | | Approved by
02 | Integration into the QMS | 09.10.2024 | J. Bähr
03 | Transfer to Inventor | 30.01.2025 | Z.Gabric

Title Interface plate, RS232 | | 230-10-5-007

ERG-Article-Nr.

Ganshorn Medizin Electronic GmbH
Industriestraße 6-8, D-97618 Niederlauer, Germany

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
