Zvonko2203/Map-from-transfer-folder/SanaBike 1000 tehnical drawings 2025/Kristijan_comments/35-10-813.pdf

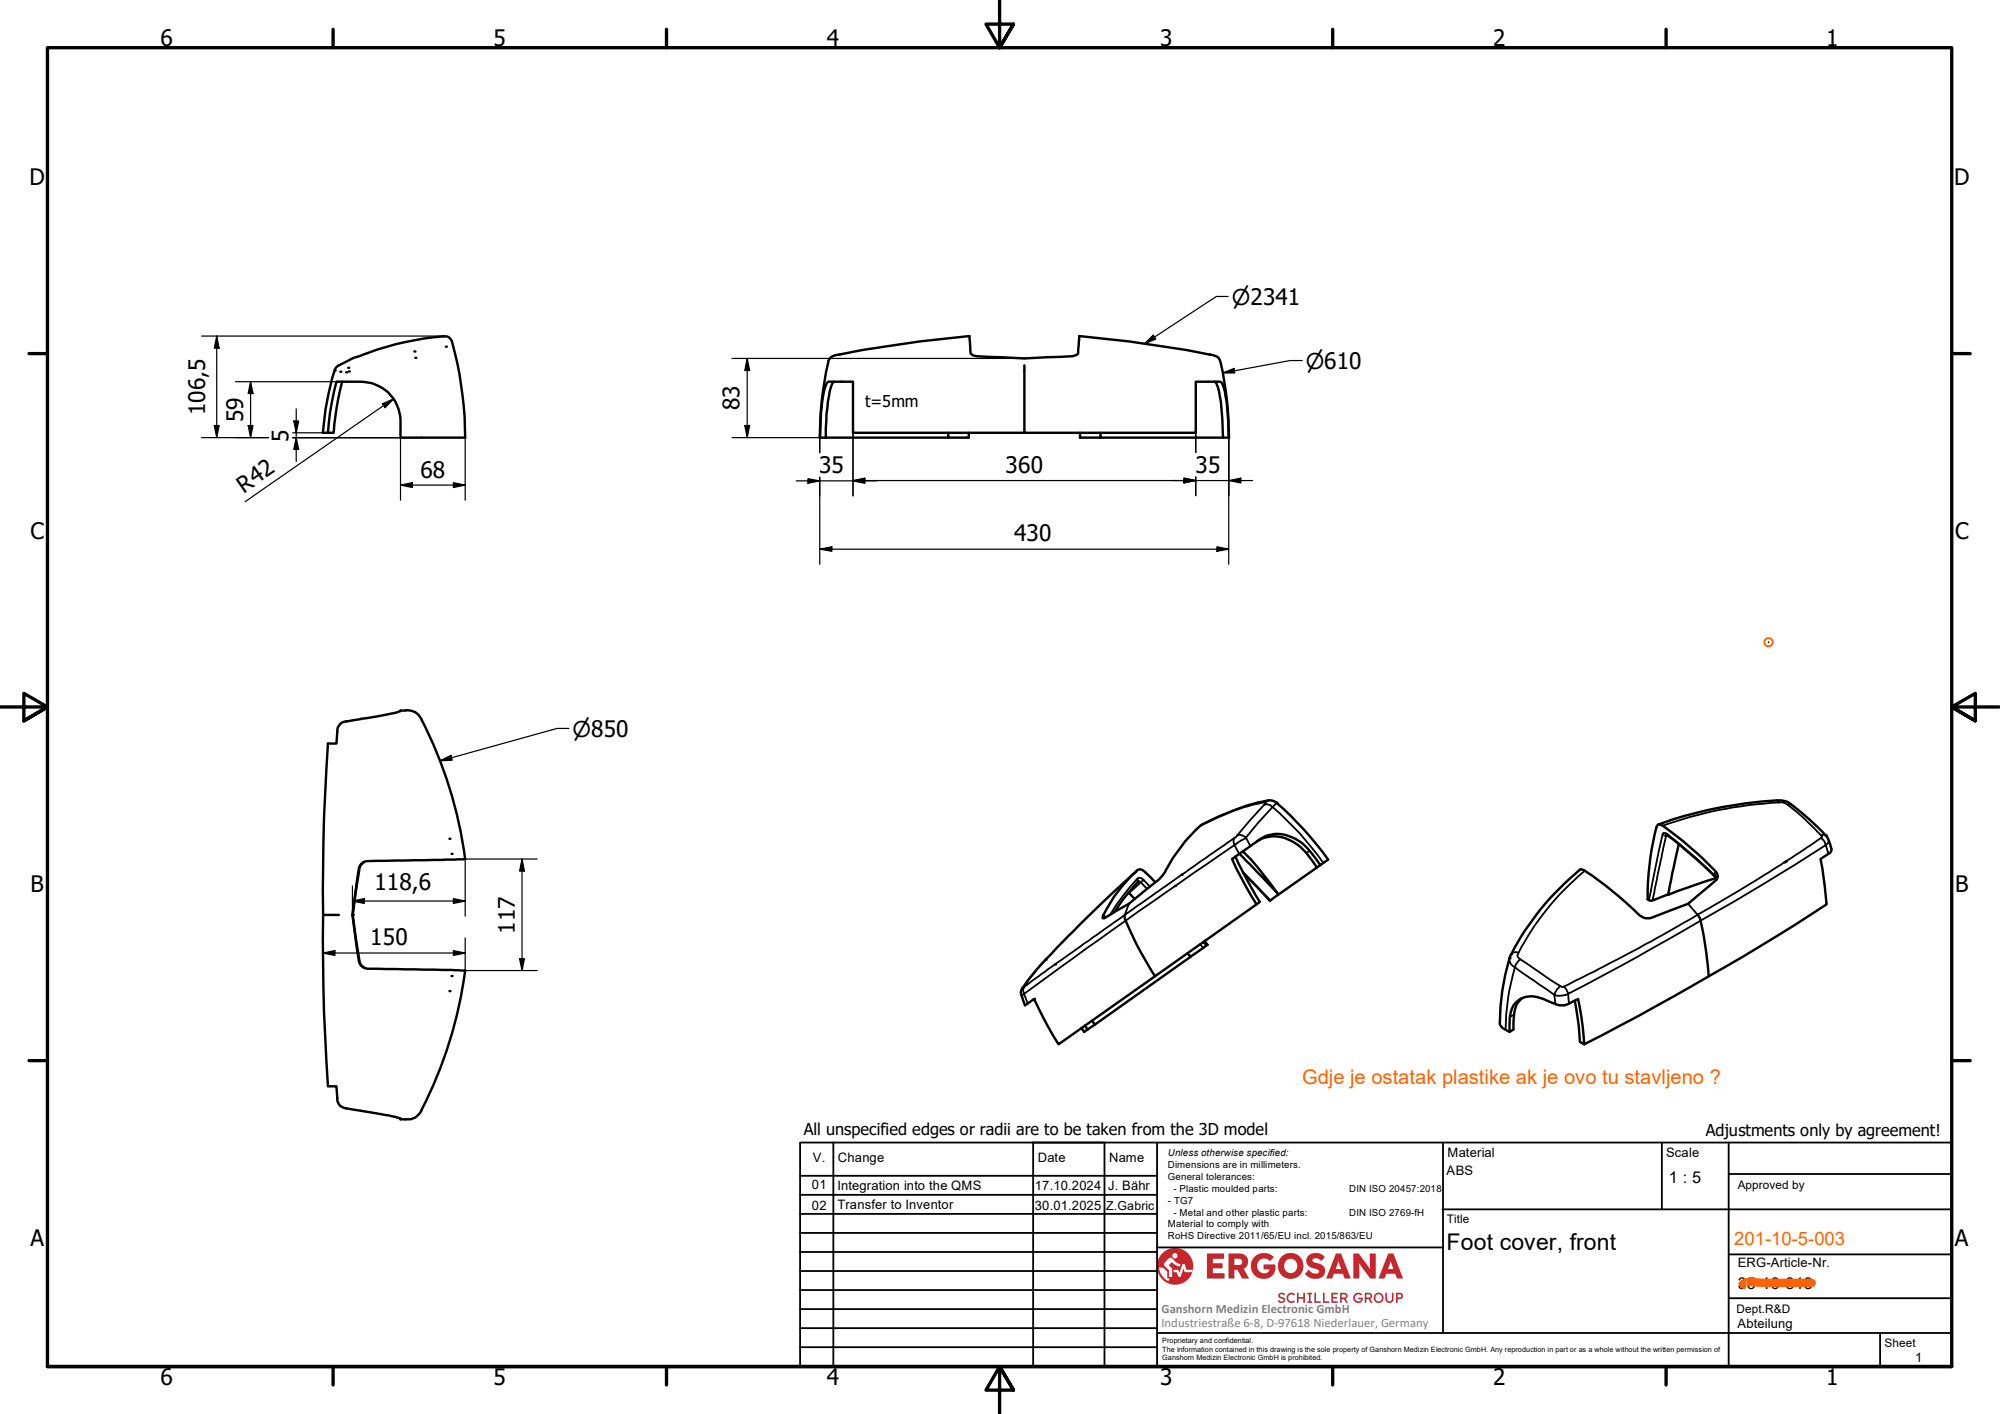
[picture p39: page 1]
All unspecified edges or radii are to be taken from the 3D model; Adjustments only by agreement!

Gdje je ostatak plastike ak je ovo tu stavljeno ?

V. | Change | Date | Name | Unless otherwise specified: Dimensions are in millimeters. General tolerances: - Plastic moulded parts: DIN ISO 20457:2018 - TG7 - Metal and other plastic parts: DIN ISO 2769-fH Material to comply with RoHS Directive 2011/65/EU incl. 2015/863/EU | Material ABS | Scale 1 : 5

01 | Integration into the QMS | 17.10.2024 | J. Bähr | | | | Approved by
02 | Transfer to Inventor | 30.01.2025 | Z.Gabric

Title Foot cover, front | | 201-10-5-003

ERG-Article-Nr.

Ganshorn Medizin Electronic GmbH
Industriestraße 6-8, D-97618 Niederlauer, Germany

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
