Zvonko2203/Map-from-transfer-folder/(commit log)

2025-05-22 SanaBike
    3D models, drawings and tests
    [070-5465 (rev1) (WE FLYLT EP13).iam, 070-5465_6A.ipt, 070-5465_coil.ipt, 1,5nF, 250V Kondensator (HerstNr. MPY20W1150FA00MSC9).ipt, 1,5nF, 250V Kondensator (HerstNr. MPYY20W1150FA00MSSD).ipt, 1-copper.ipt, 1-soldermask.ipt, 10-30-100 SanaBike 1000.iam]
2025-07-24 Create New SanaBike frame-24-7-2025
2025-07-24 Create SanaBike 1000 new frame for PS-24-7-2025
2025-07-24 Update SanaBike 1000 new frame for PS-24-7-2025
